prabhakar06447/micropendousx/Pictures/MicropendousX-LPC183x-Prototyping-Oven-Step2.jpg

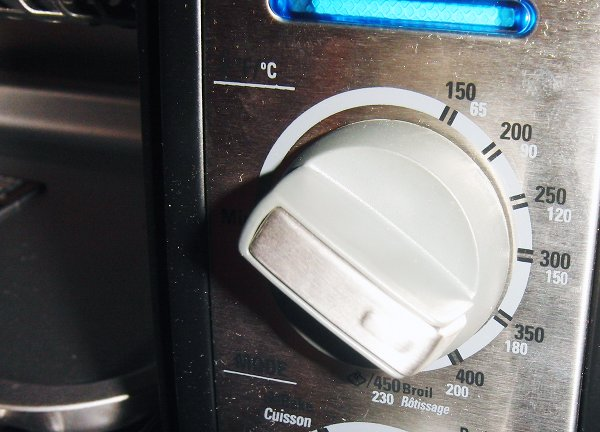
Pictures/MicropendousX-LPC183x-Prototyping-Oven-Step2.jpg
