prabhakar06447/micropendousx/Pictures/MicropendousX-LPC183x-Prototype-Testing-WindowsLibUSB.jpg

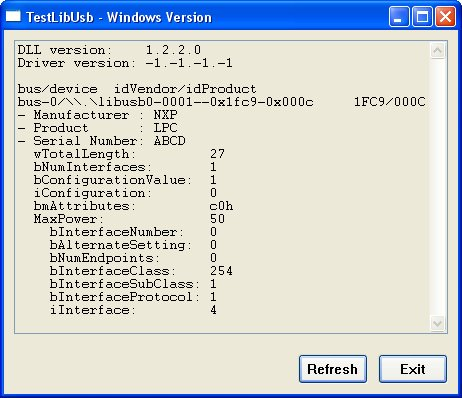
Pictures/MicropendousX-LPC183x-Prototype-Testing-WindowsLibUSB.jpg
