prabhakar06447/micropendousx/MicropendousX/Hardware/MicropendousX-176x/MicropendousX-176x_Actionshot-2-Bottom-Large.jpg

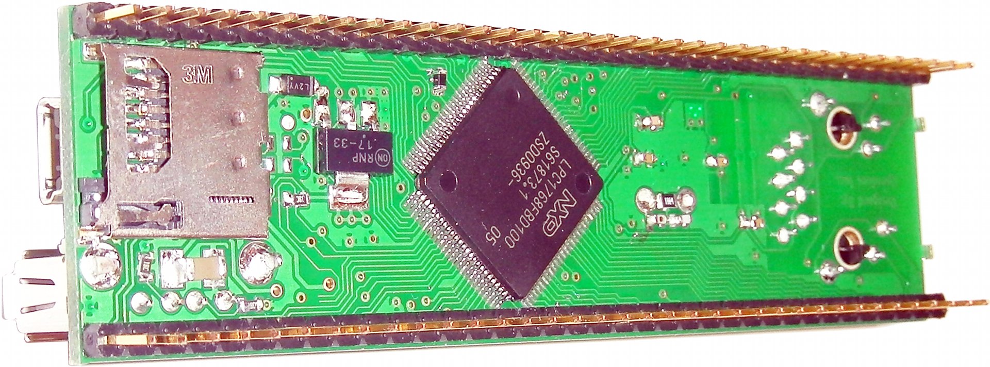
MicropendousX/Hardware/MicropendousX-176x/MicropendousX-176x_Actionshot-2-Bottom-Large.jpg
