prabhakar06447/micropendousx/MicropendousX/Hardware/MicropendousX-176x/MicropendousX-176x_JTAG_Connected-1.jpg

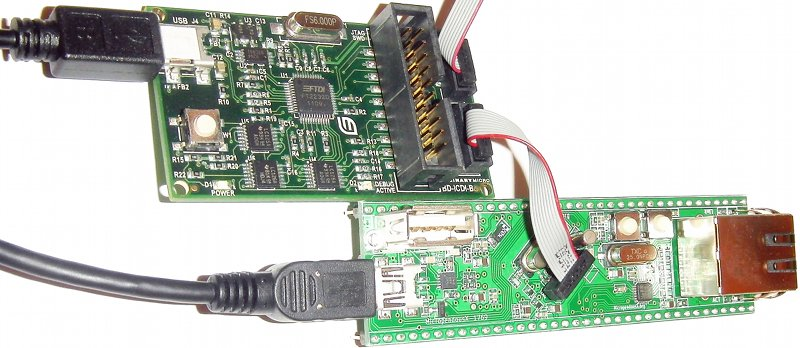
MicropendousX/Hardware/MicropendousX-176x/MicropendousX-176x_JTAG_Connected-1.jpg
