prabhakar06447/micropendousx/MicropendousX/Hardware/MicropendousX-176x/MicropendousX-176x_JTAG_Connected-2.jpg

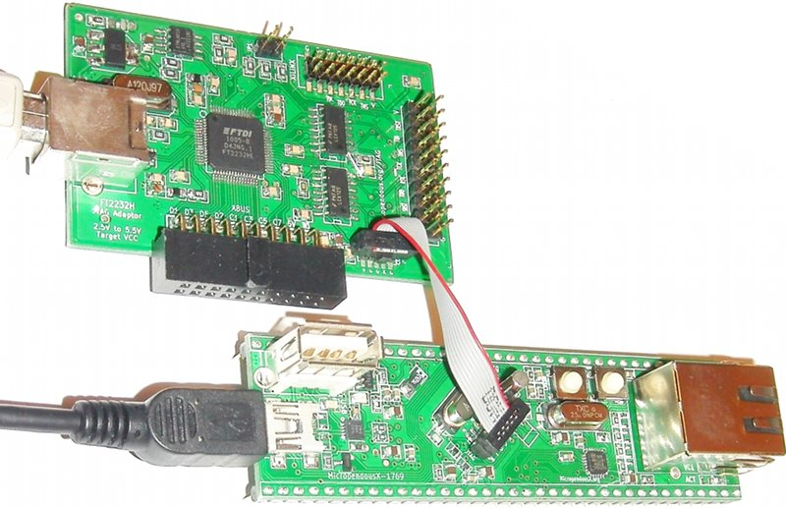
MicropendousX/Hardware/MicropendousX-176x/MicropendousX-176x_JTAG_Connected-2.jpg
