prabhakar06447/micropendousx/MicropendousX/Hardware/MicropendousX-176x/MicropendousX-176x_Top-Large.jpg

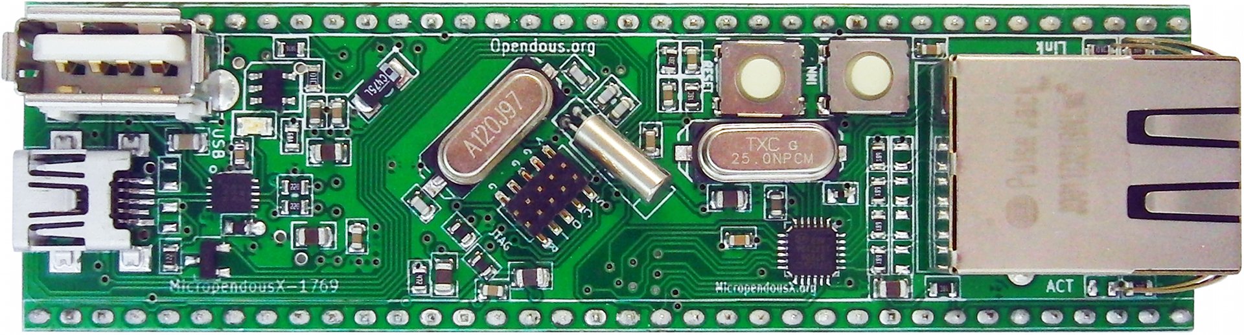
MicropendousX/Hardware/MicropendousX-176x/MicropendousX-176x_Top-Large.jpg
