prabhakar06447/micropendousx/MicropendousX/Hardware/MicropendousX-1343/MicropendousX-1343-Small.jpg

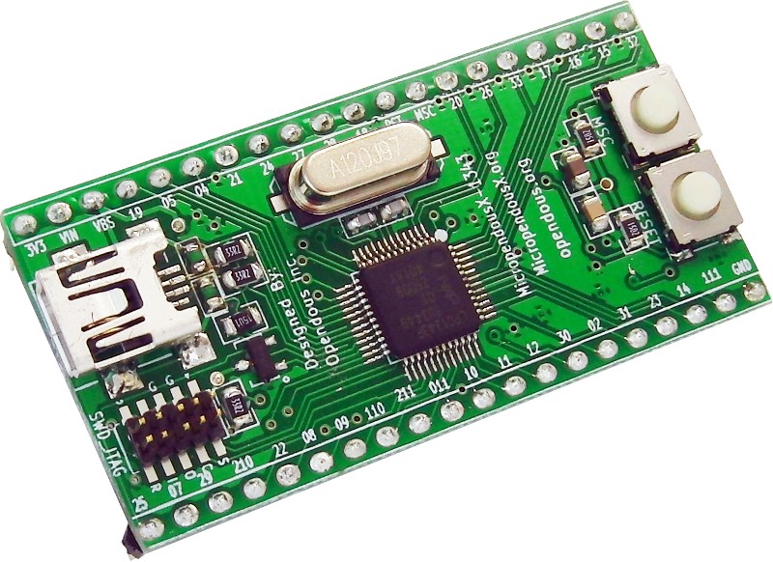
MicropendousX/Hardware/MicropendousX-1343/MicropendousX-1343-Small.jpg
