prabhakar06447/micropendousx/MicropendousX/Hardware/MicropendousX-1758/MicropendousX-1758-Bottom.jpg

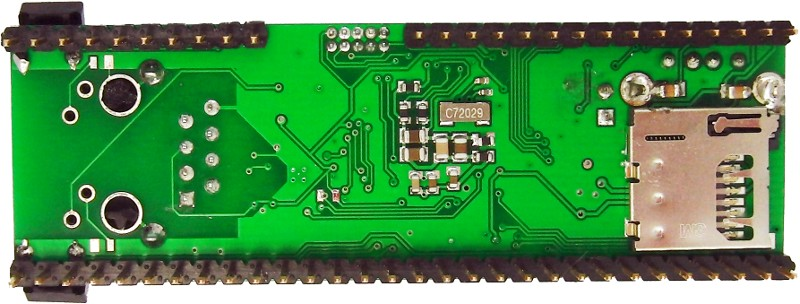
MicropendousX/Hardware/MicropendousX-1758/MicropendousX-1758-Bottom.jpg
