prabhakar06447/micropendousx/MicropendousX/Hardware/MicropendousX-1758/MicropendousX-1758-Top.jpg

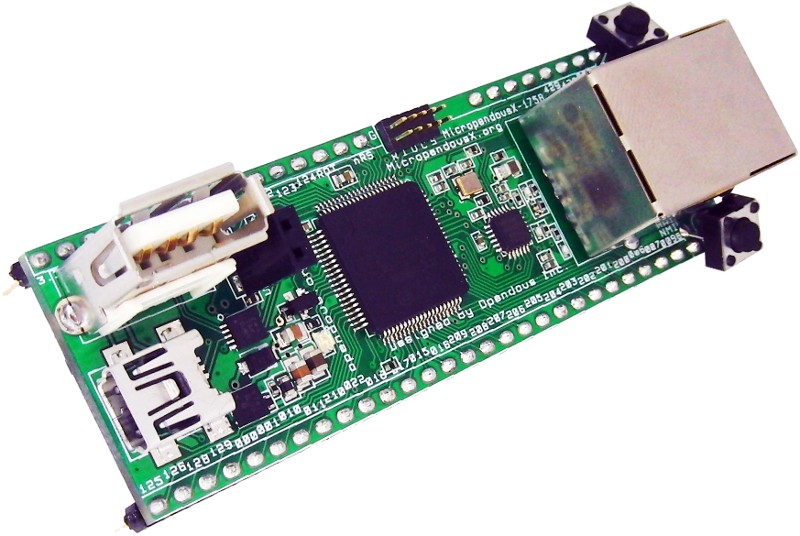
MicropendousX/Hardware/MicropendousX-1758/MicropendousX-1758-Top.jpg
