prabhakar06447/micropendousx/MicropendousX/Hardware/MicropendousX-GPS/MicropendousX-LPC182x-GPS-Layout.jpg

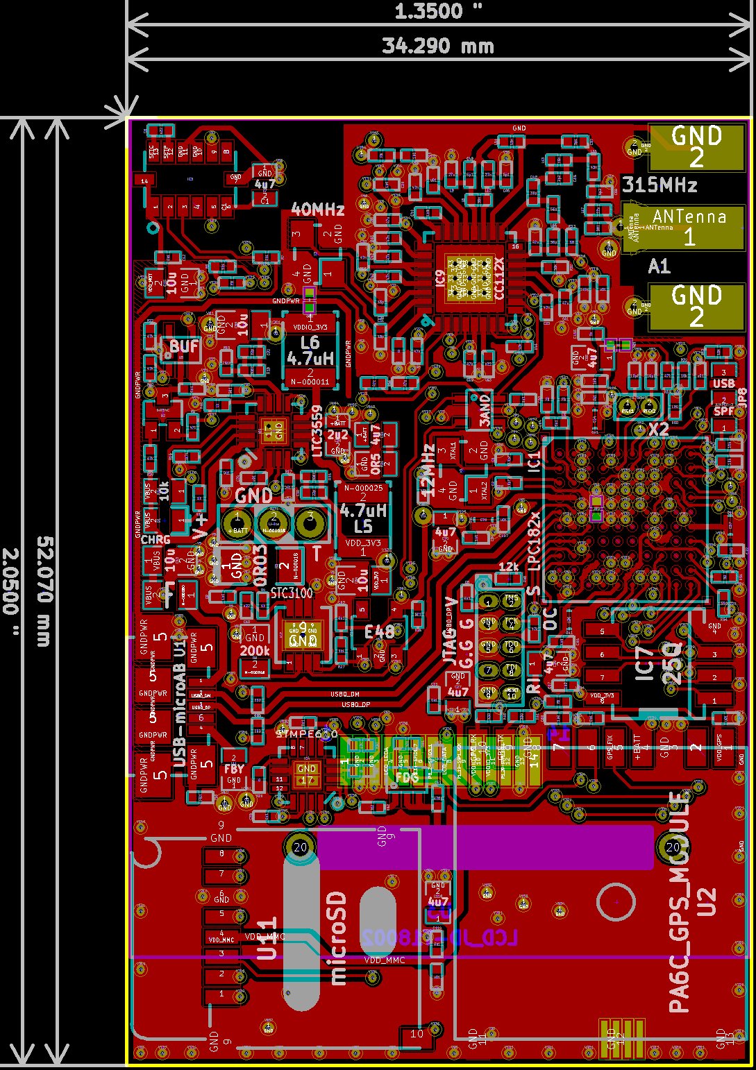
MicropendousX/Hardware/MicropendousX-GPS/MicropendousX-LPC182x-GPS-Layout.jpg
