prabhakar06447/micropendousx/MicropendousX/Hardware/MicropendousX-LPC183x/MicropendousX-LPC183x_Layout.jpg

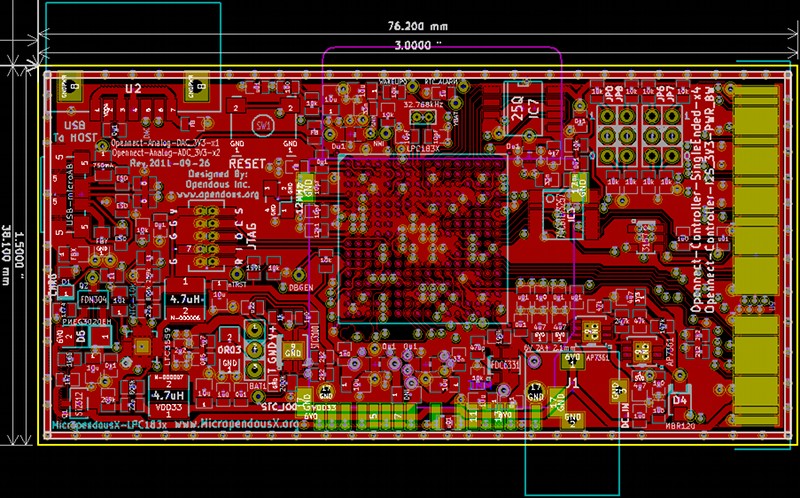
MicropendousX/Hardware/MicropendousX-LPC183x/MicropendousX-LPC183x_Layout.jpg
