prabhakar06447/micropendousx/Pictures/MicropendousX-1343-Picture1.jpg

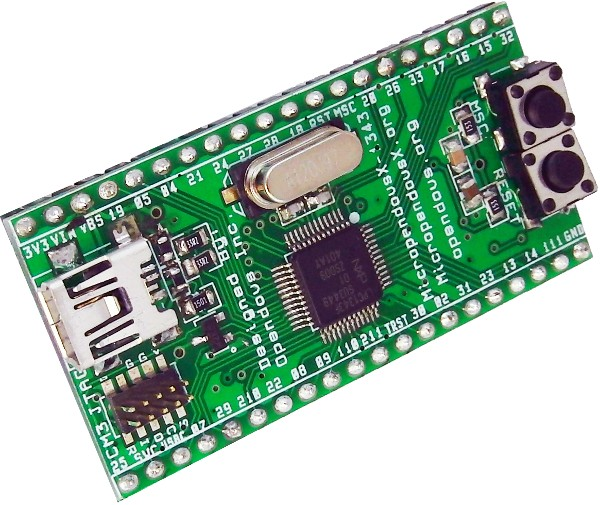
Pictures/MicropendousX-1343-Picture1.jpg
