prabhakar06447/micropendousx/Pictures/MicropendousX-1758-JTAG_Adapter_Connected-1.jpg

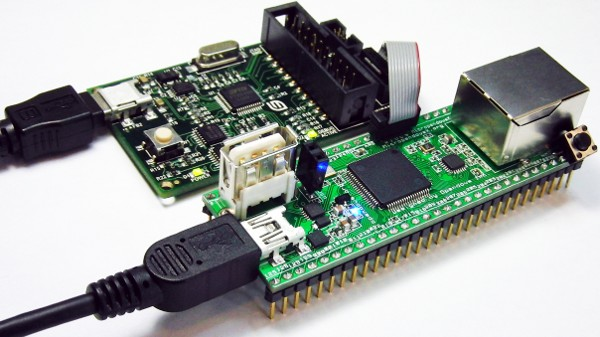
Pictures/MicropendousX-1758-JTAG_Adapter_Connected-1.jpg
