prabhakar06447/micropendousx/Pictures/MicropendousX-1758-Picture2.jpg

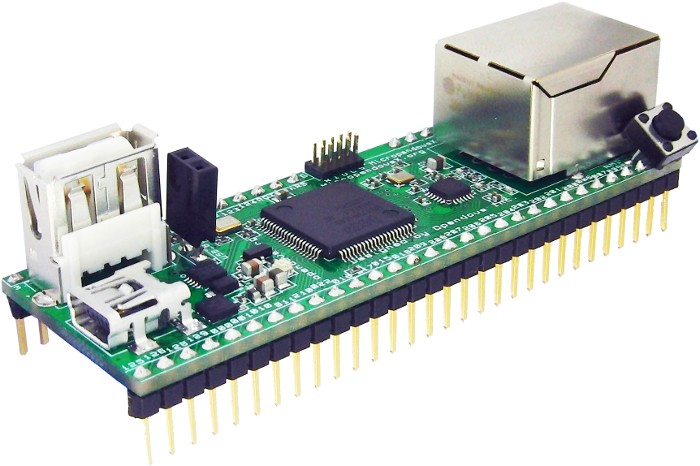
Pictures/MicropendousX-1758-Picture2.jpg
