prabhakar06447/micropendousx/Pictures/MicropendousX-1758-Picture3.jpg

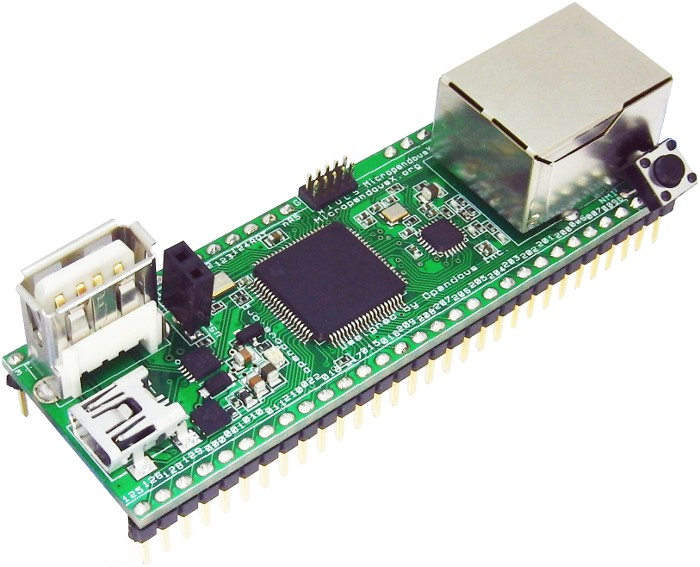
Pictures/MicropendousX-1758-Picture3.jpg
