prabhakar06447/micropendousx/Pictures/MicropendousX-LPC183x-Prototype-JumperSettingsUSB0.jpg

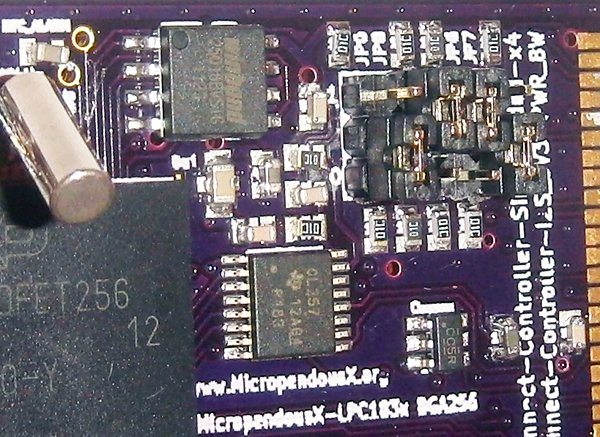
Pictures/MicropendousX-LPC183x-Prototype-JumperSettingsUSB0.jpg
