prabhakar06447/micropendousx/Pictures/MicropendousX-LPC183x-Prototyping-ExaminingPlacement.jpg

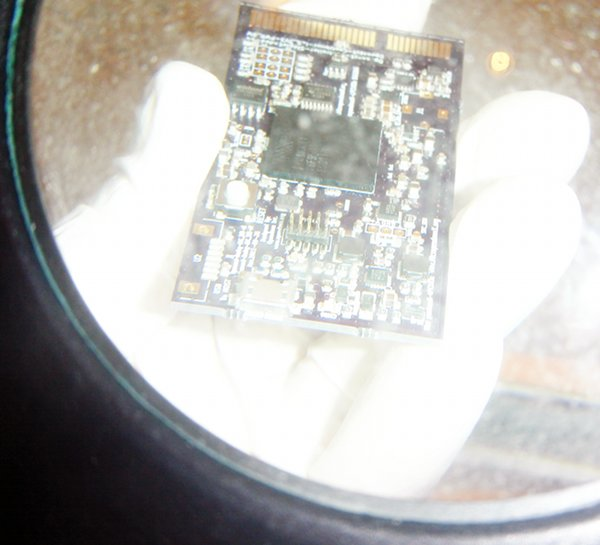
Pictures/MicropendousX-LPC183x-Prototyping-ExaminingPlacement.jpg
