prabhakar06447/micropendousx/Pictures/MicropendousX-LPC183x-Prototyping-OvenTray.jpg

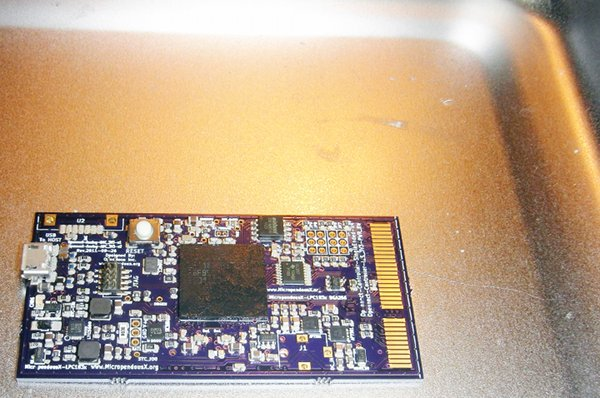
Pictures/MicropendousX-LPC183x-Prototyping-OvenTray.jpg
