prabhakar06447/micropendousx/Pictures/MicropendousX-LPC183x-Prototyping-PreparingBGA.jpg

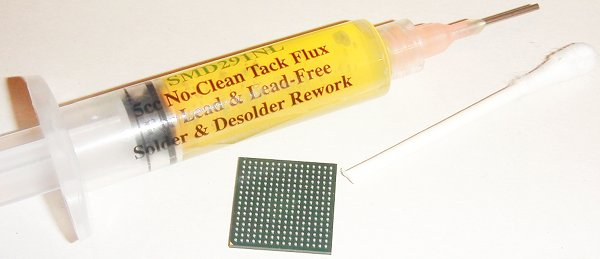
Pictures/MicropendousX-LPC183x-Prototyping-PreparingBGA.jpg
