prabhakar06447/micropendousx/Pictures/MicropendousX-LPC183x-Prototyping-StencilPositioning.jpg

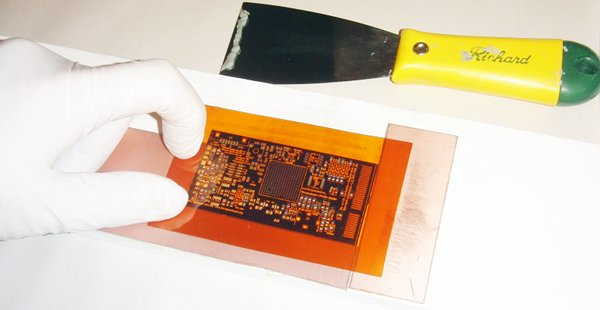
Pictures/MicropendousX-LPC183x-Prototyping-StencilPositioning.jpg
