prabhakar06447/micropendousx/MicropendousX/Hardware/MicropendousX-1343/MicropendousX-1343-BillOfMaterials.txt

QTY, Manufacturer Part#     , Cost($USD each) - References - Description

1  , LPC1343FBD48           , 6.30 - IC1 - IC MCU 32BIT 32KB FLASH 48LQFP
2  , CC0603JRNP09BN180      , 0.05 - C1 C2 - CAP CERAMIC 18PF 50V NP0 0603
1  , 08055C103KAT2A         , 0.03 - C7 - CAP CERM .01UF 10% 50V X7R 0805
2  , GRM21BR71E104KA01L     , 0.04 - C5 C6 - CAP CER .1UF 25V 10% X7R 0805
3  , LMK212BJ106KG-T        , 0.28 - C3 C4 C8 - CAP CER 10uF 10V X5R 0805
2  , CG0603MLC-05LE         , 0.23 - CR1 CR2 - SUPPRESSOR ESD 5VDC 0603 SMD MLC
1  , MBR120VLSFT1G          , 0.53 - D1 - DIODE SCHOTTKY 20V 1A SOD123FL
1  , BSS84LT1G              , 0.51 - Q1 - MOSFET P-CH 50V 130MA SOT-23 Logic Level Gate
2  , RMCF1/1033.2FRCT-ND    , 0.04 - R1 R2 - RES 33.2 OHM 1/8W 1% 0805 SMD
1  , RC0805FR-071K5L        , 0.07 - R3 - RES 1.50K OHM 1/8W 1% 0805 SMD
2  , RMCF1/1015KJRCT-ND     , 0.03 - R4 R5 - RES 15K OHM 1/8W 5% 0805 SMD
1  , RMCF1/100RCT-ND        , 0.03 - R7 - RES 0 OHM 1/8W 5% 0805 SMD
2  , EVQ-Q2U03W             , 0.39 - SW1 SW2 - SWITCH LT 6MM 260GF H=3.1MM SMD
1  , 101-00303-68           , 0.86 - U3 - CONN MINI MICRO-SD 8PIN PCB GOLD
1  , 690-004-221-023        , 0.93 - U2 - CONN USB JACK TYPE B HORIZON R/A
1  , GRPB052VWVN-RC         , 1.11 - U3 - Cortex CONN HEADER .050" 10PS DL PCB AU
1  , ZLDO1117G33TA          , 0.62 - U4 - IC REG LDO 1A 3.3V SOT223            
1  , ABLS-12.000MHZ-B4-T    , 0.46 - X1 - CRYSTAL 12.000 MHZ 18PF HC49US 30ppm
2  , 68001-220HLF           , 1.00 - P1 P2 - CONN HEADER 20POS .100 STR 15AU
-----------------------Total:15.86

Notes:	- Component costs listed are for single quantity orders from DigiKey
	- The outer male headers P1, P2 can be replaced with PPPC201LFBN-RC female headers
	- R3, the 1.5k USB D+ pull-up, and USB series resistors R1, R2 must be 1% or better
	- LPC1343FBD48 can be replaced with non-USB LPC1313FBD48 (Cortex-M3) or
	  LPC1114FBD48 (Cortex-M0) ICs.  USB will then only provide power.
	  DO NOT populate D1 when using non-USB ICs
	- MBR120VLSFT1G Schottky Diode can be replaced by MBRX120 in SOD123
	- R6 is a copper trace connecting GND and GNDPWR. Its pins should be shorted.
	- R7 need only be installed if you require SWD trace capability
