prabhakar06447/micropendousx/Pictures/MicropendousX-LPC183x-Prototyping-Materials.jpg

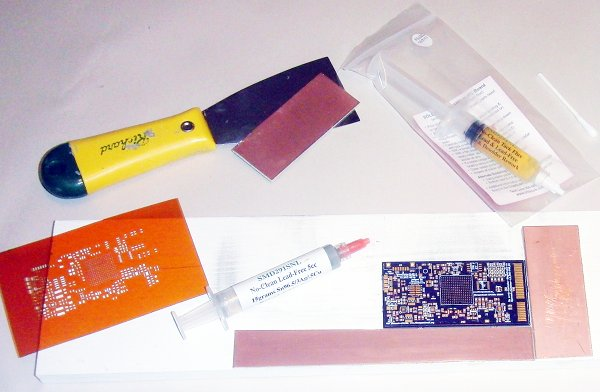
Pictures/MicropendousX-LPC183x-Prototyping-Materials.jpg
