prabhakar06447/micropendousx/MicropendousX/Hardware/MicropendousX-176x/MicropendousX-176x_Assembly.jpg

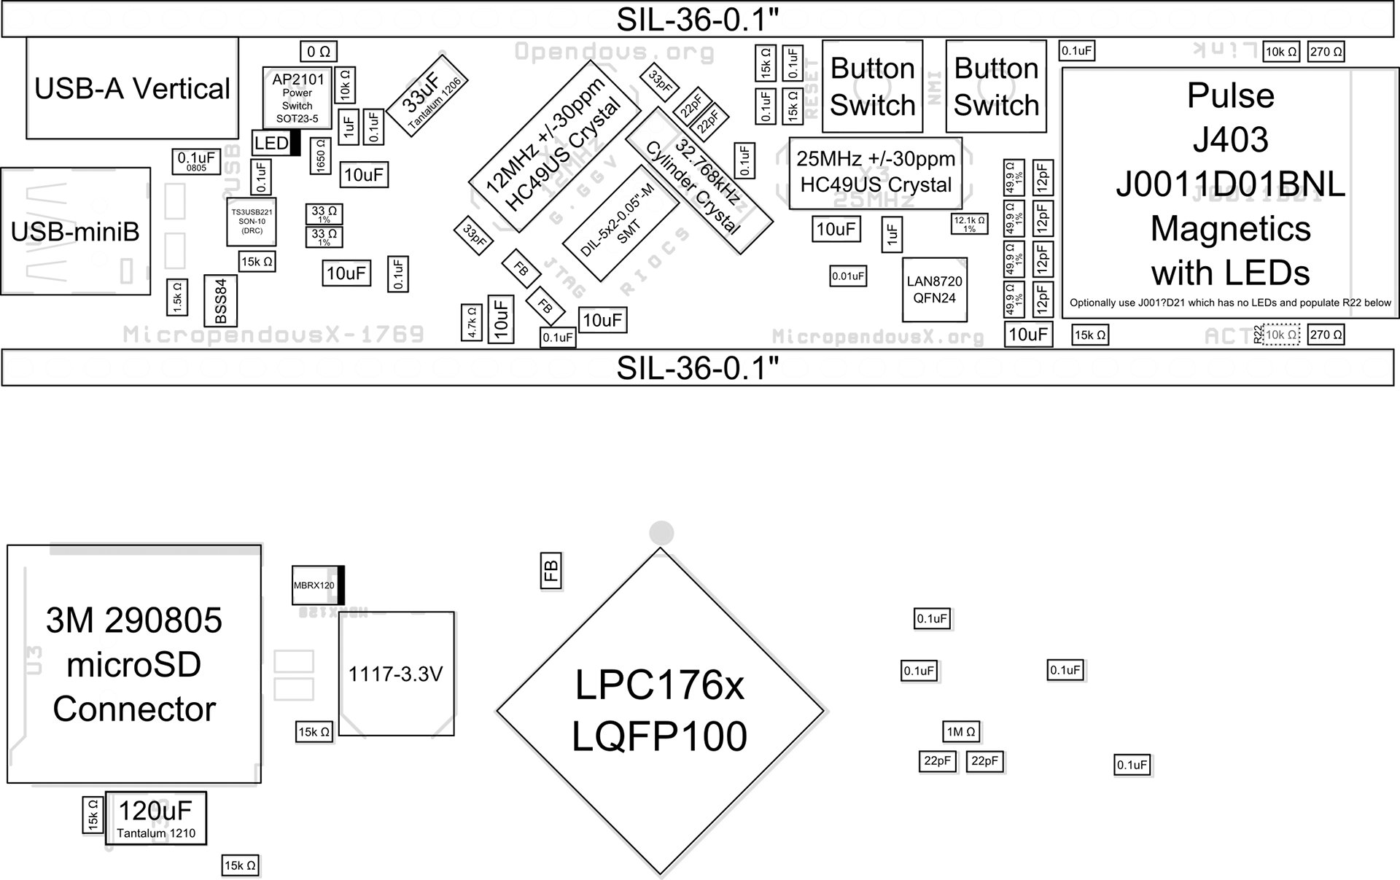
MicropendousX/Hardware/MicropendousX-176x/MicropendousX-176x_Assembly.jpg
