prabhakar06447/micropendousx/MicropendousX/Hardware/MicropendousX-1343/MicropendousX-1343_Assembly.jpg

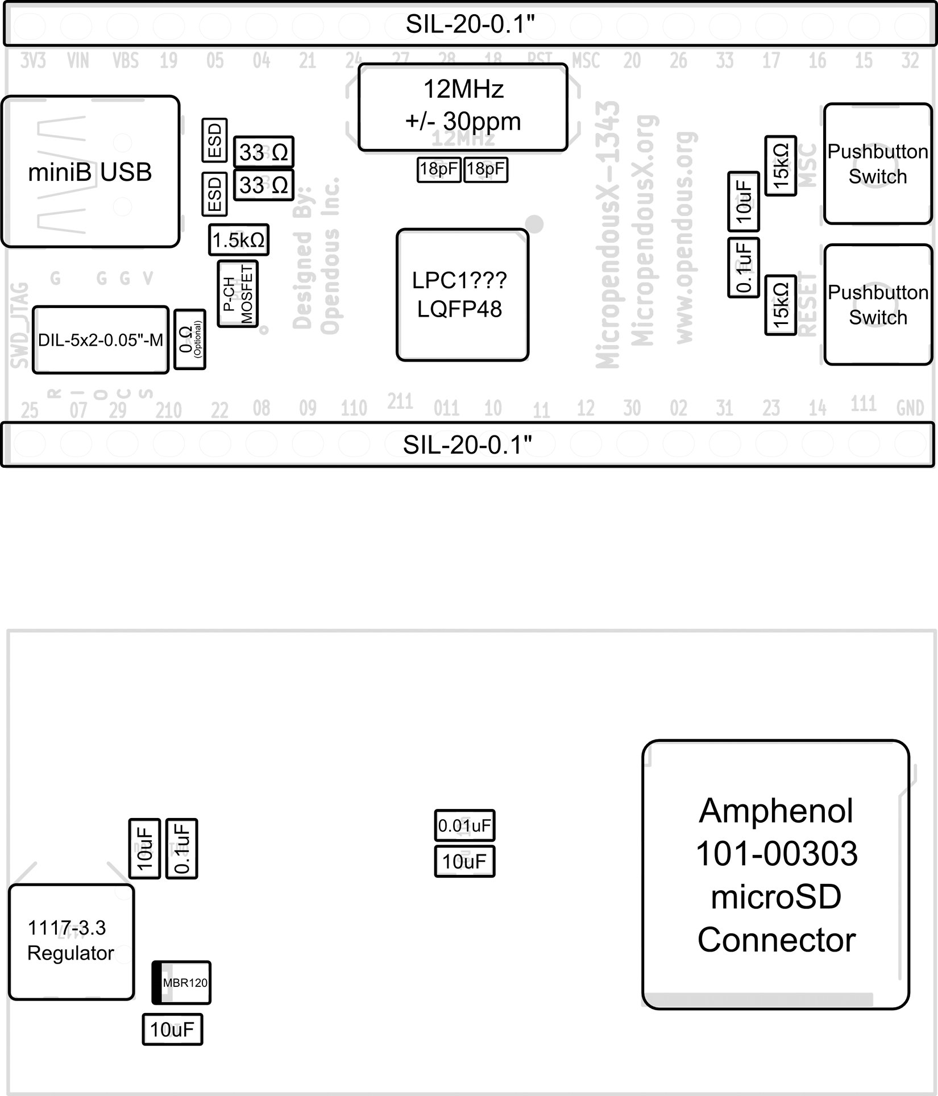
MicropendousX/Hardware/MicropendousX-1343/MicropendousX-1343_Assembly.jpg
