prabhakar06447/micropendousx/MicropendousX/Hardware/MicropendousX-LPC183x/MicropendousX-LPC183x-Assembly.jpg

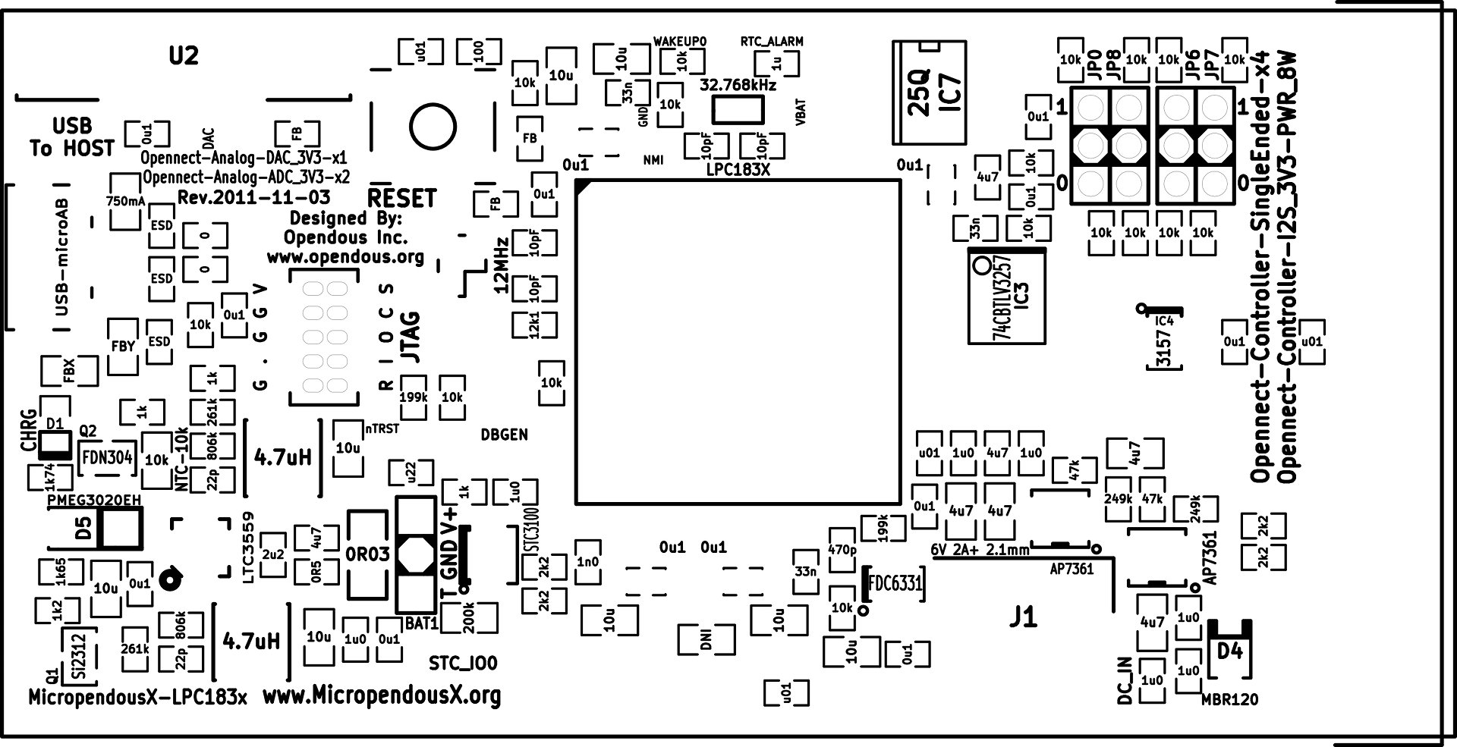
MicropendousX/Hardware/MicropendousX-LPC183x/MicropendousX-LPC183x-Assembly.jpg
