prabhakar06447/micropendousx/Pictures/MicropendousX-LPC183x-Prototyping-Oven-Step1.jpg

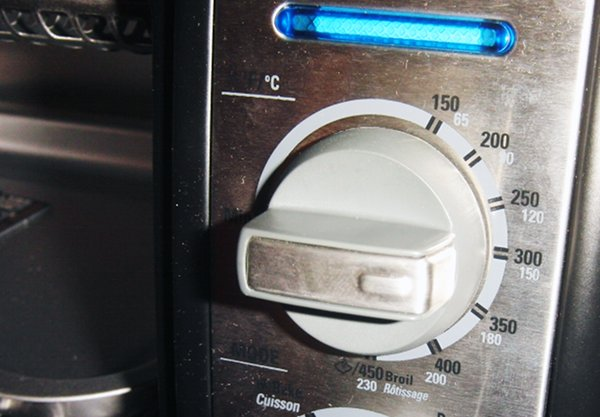
Pictures/MicropendousX-LPC183x-Prototyping-Oven-Step1.jpg
