prabhakar06447/micropendousx/Pictures/MicropendousX-LPC183x-Prototyping-Oven-Step3.jpg

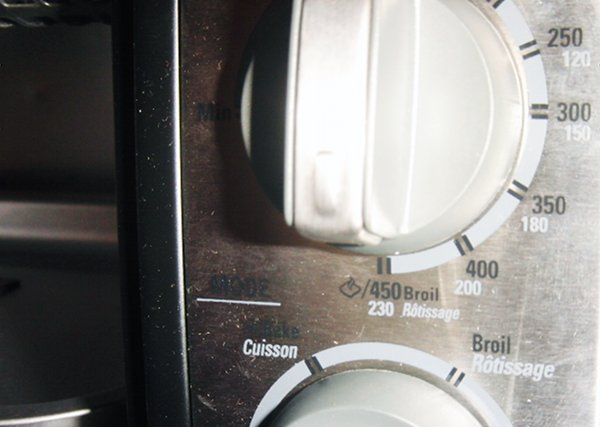
Pictures/MicropendousX-LPC183x-Prototyping-Oven-Step3.jpg
