prabhakar06447/micropendousx/Pictures/MicropendousX-LPC183x-Prototyping-SolderPasted.jpg

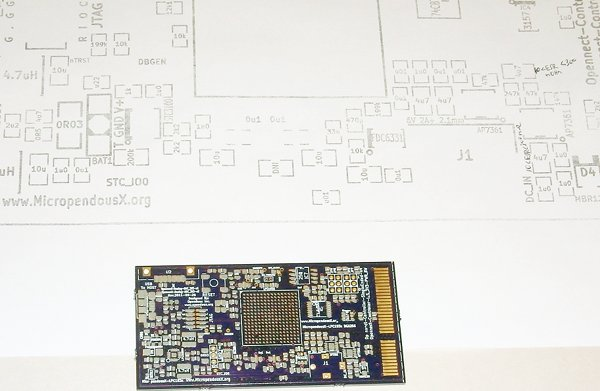
Pictures/MicropendousX-LPC183x-Prototyping-SolderPasted.jpg
