prabhakar06447/micropendousx/Pictures/MicropendousX-LPC183x-Prototype-Testing-Linux_lsusb.jpg

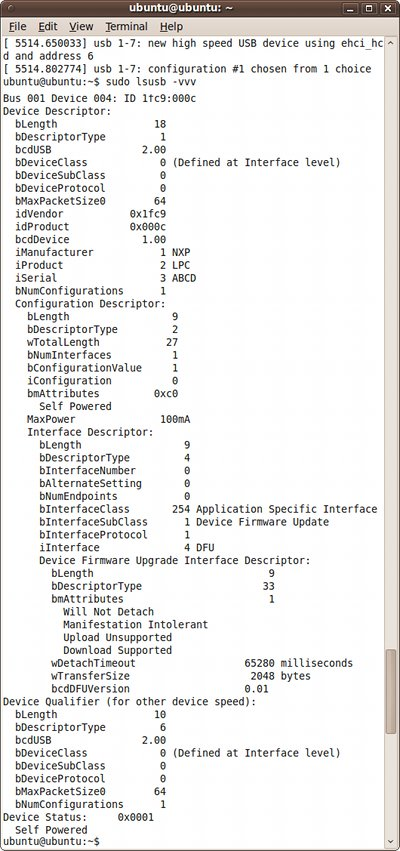
Pictures/MicropendousX-LPC183x-Prototype-Testing-Linux_lsusb.jpg
