prabhakar06447/micropendousx/Pictures/MicropendousX-LPC183x-Prototype-Testing-Small.jpg

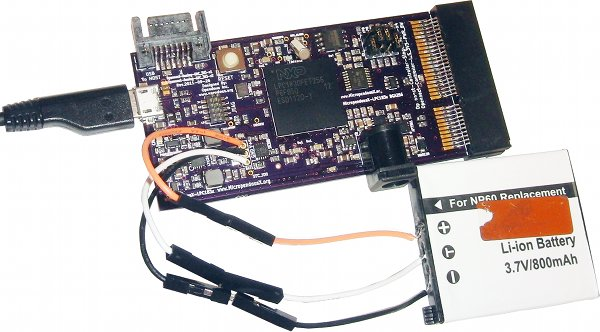
Pictures/MicropendousX-LPC183x-Prototype-Testing-Small.jpg
