prabhakar06447/micropendousx/MicropendousX/Hardware/MicropendousX-GPS/MicropendousX-LPC182x-GPS-Schematic.pdf

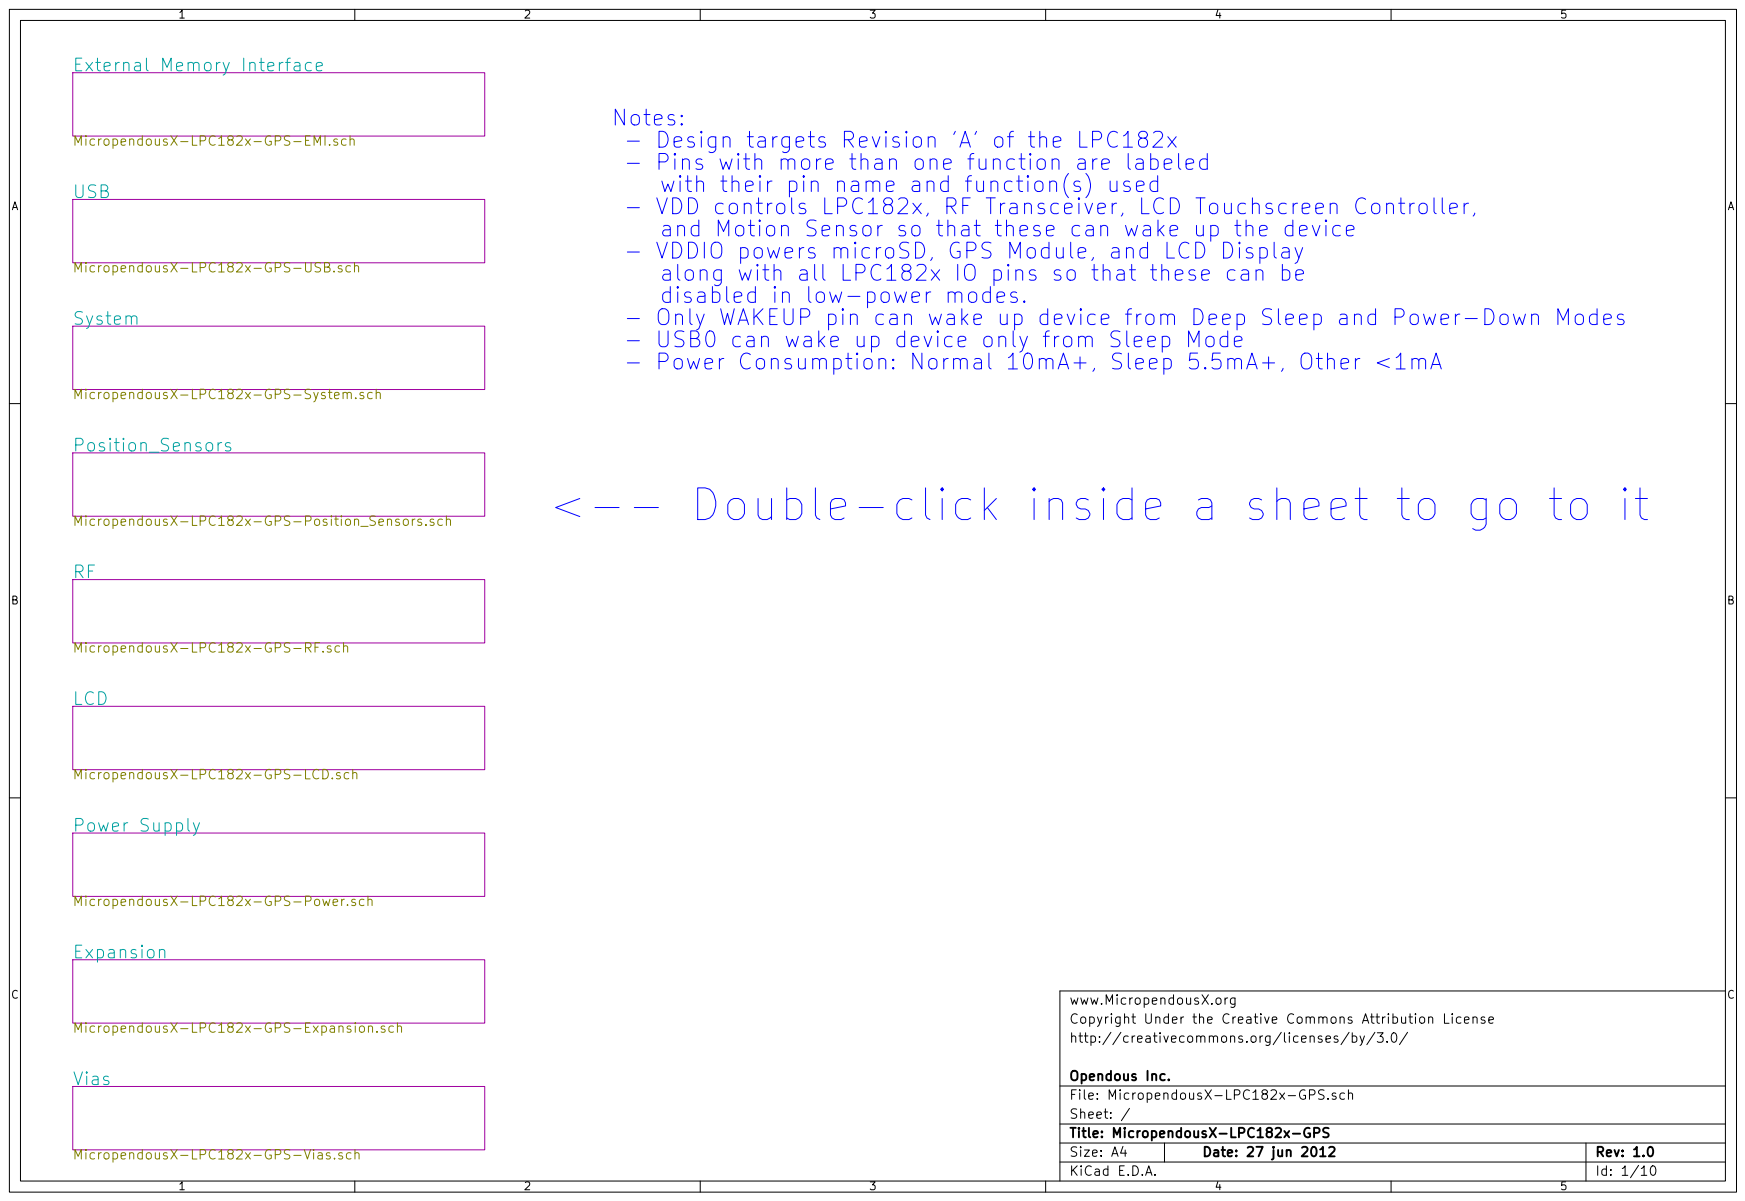
[picture p44: page 1]

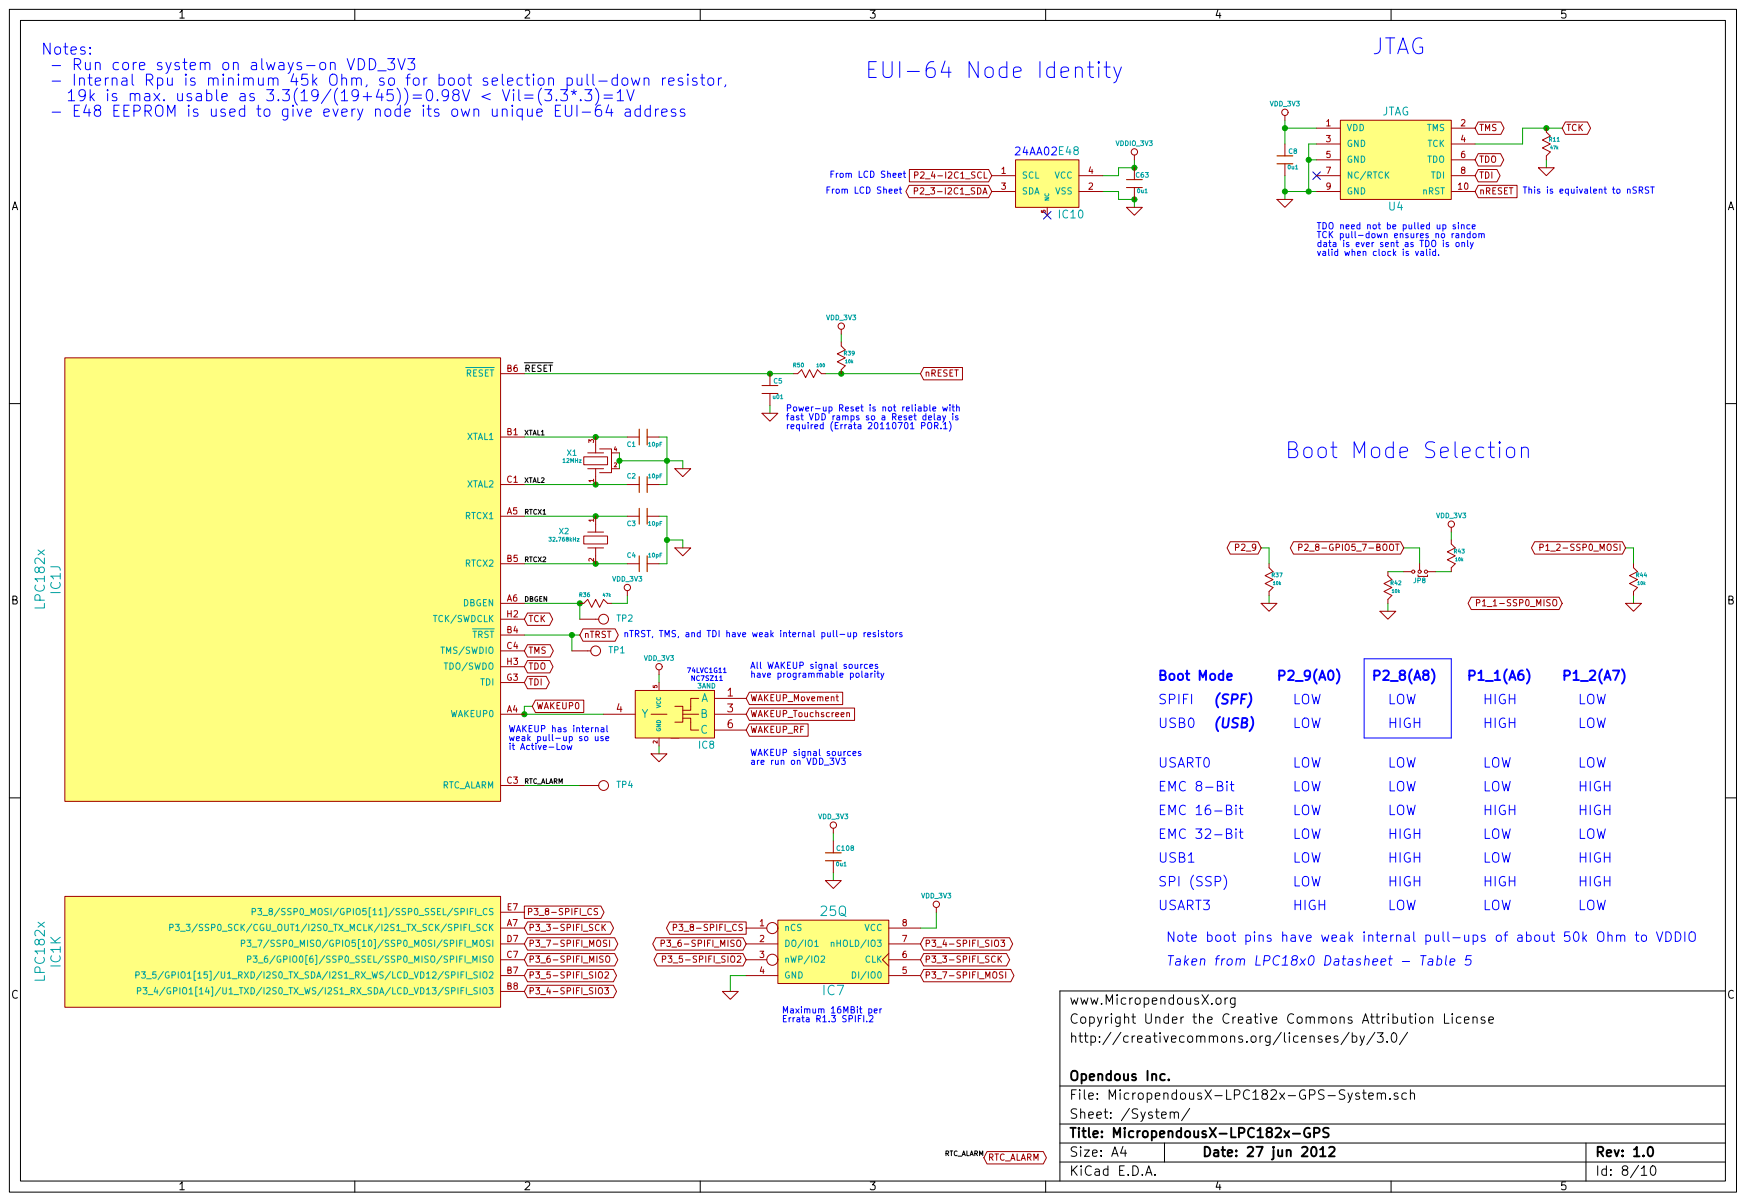
[picture p45: page 2]

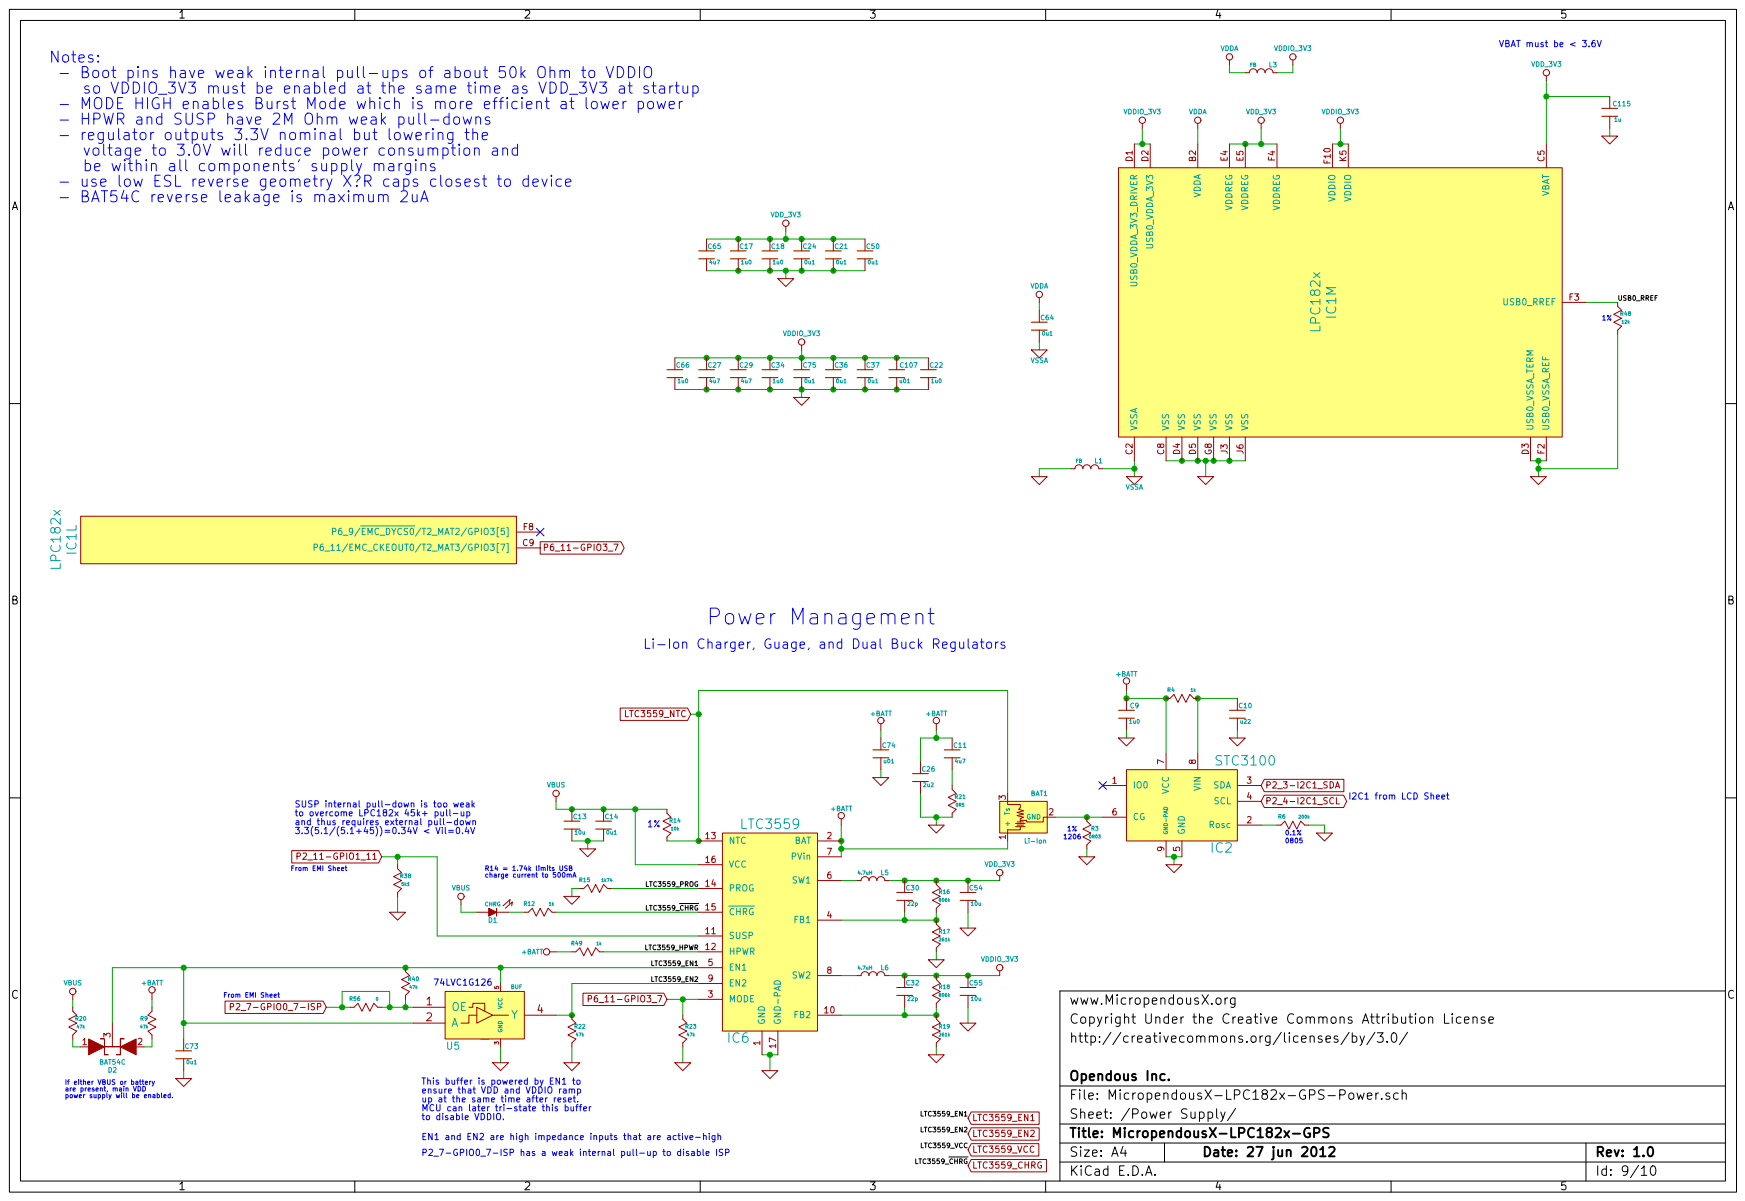
[picture p46: page 3]

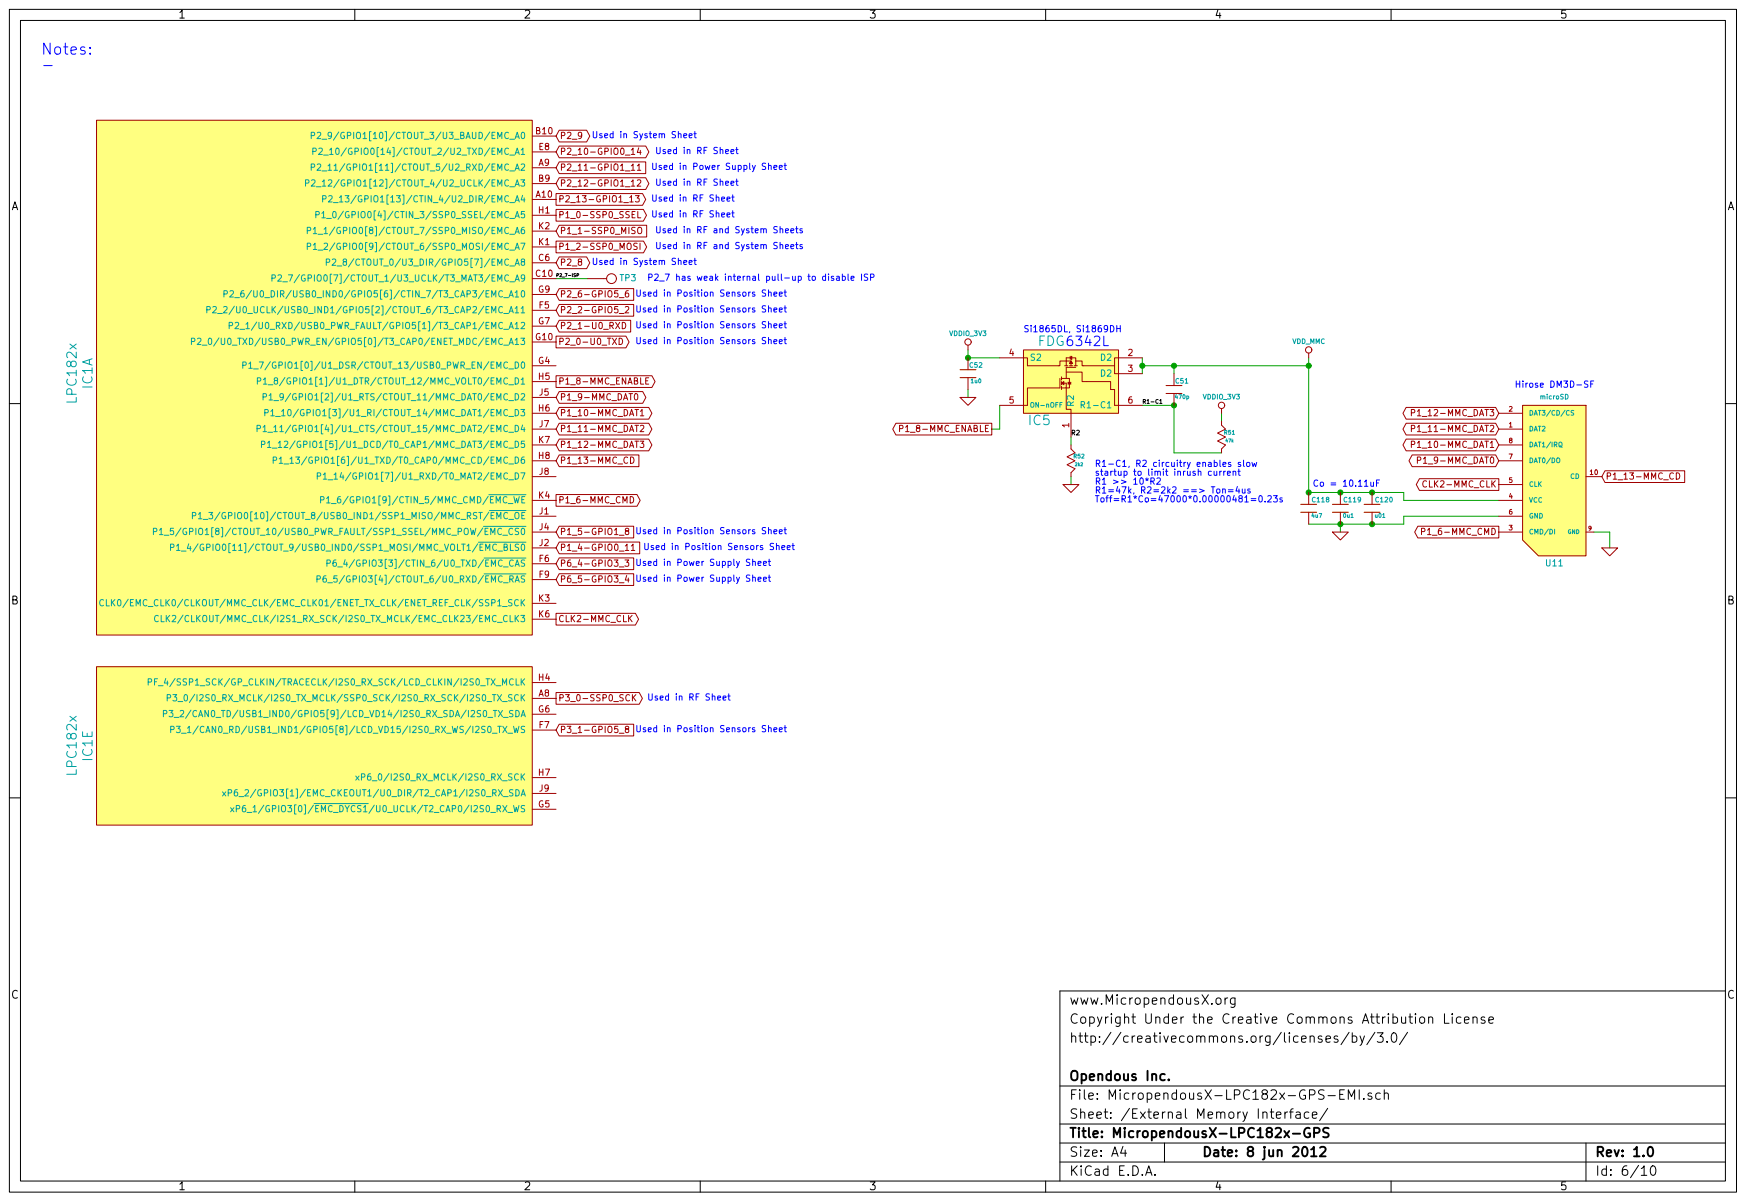
[picture p47: page 4]

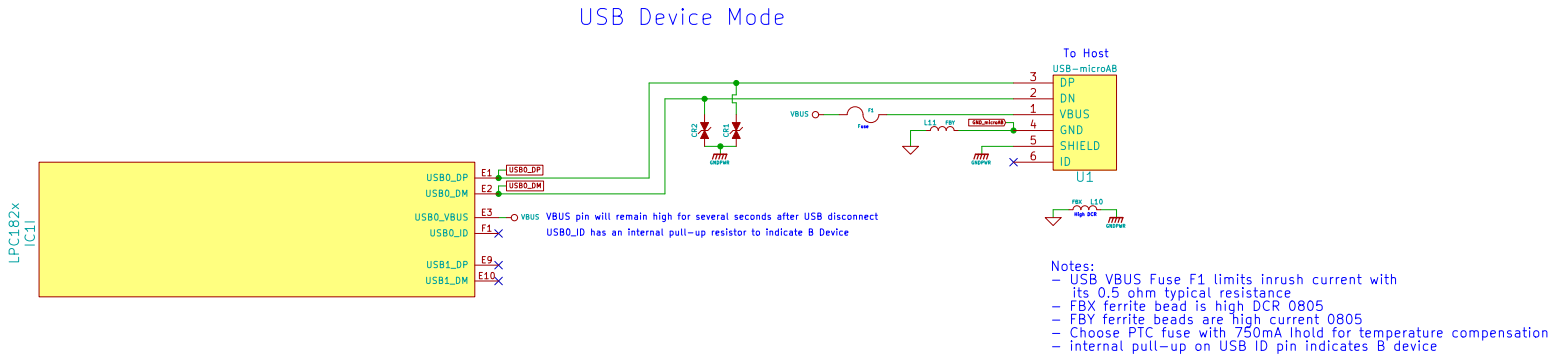
[picture p48: page 5]

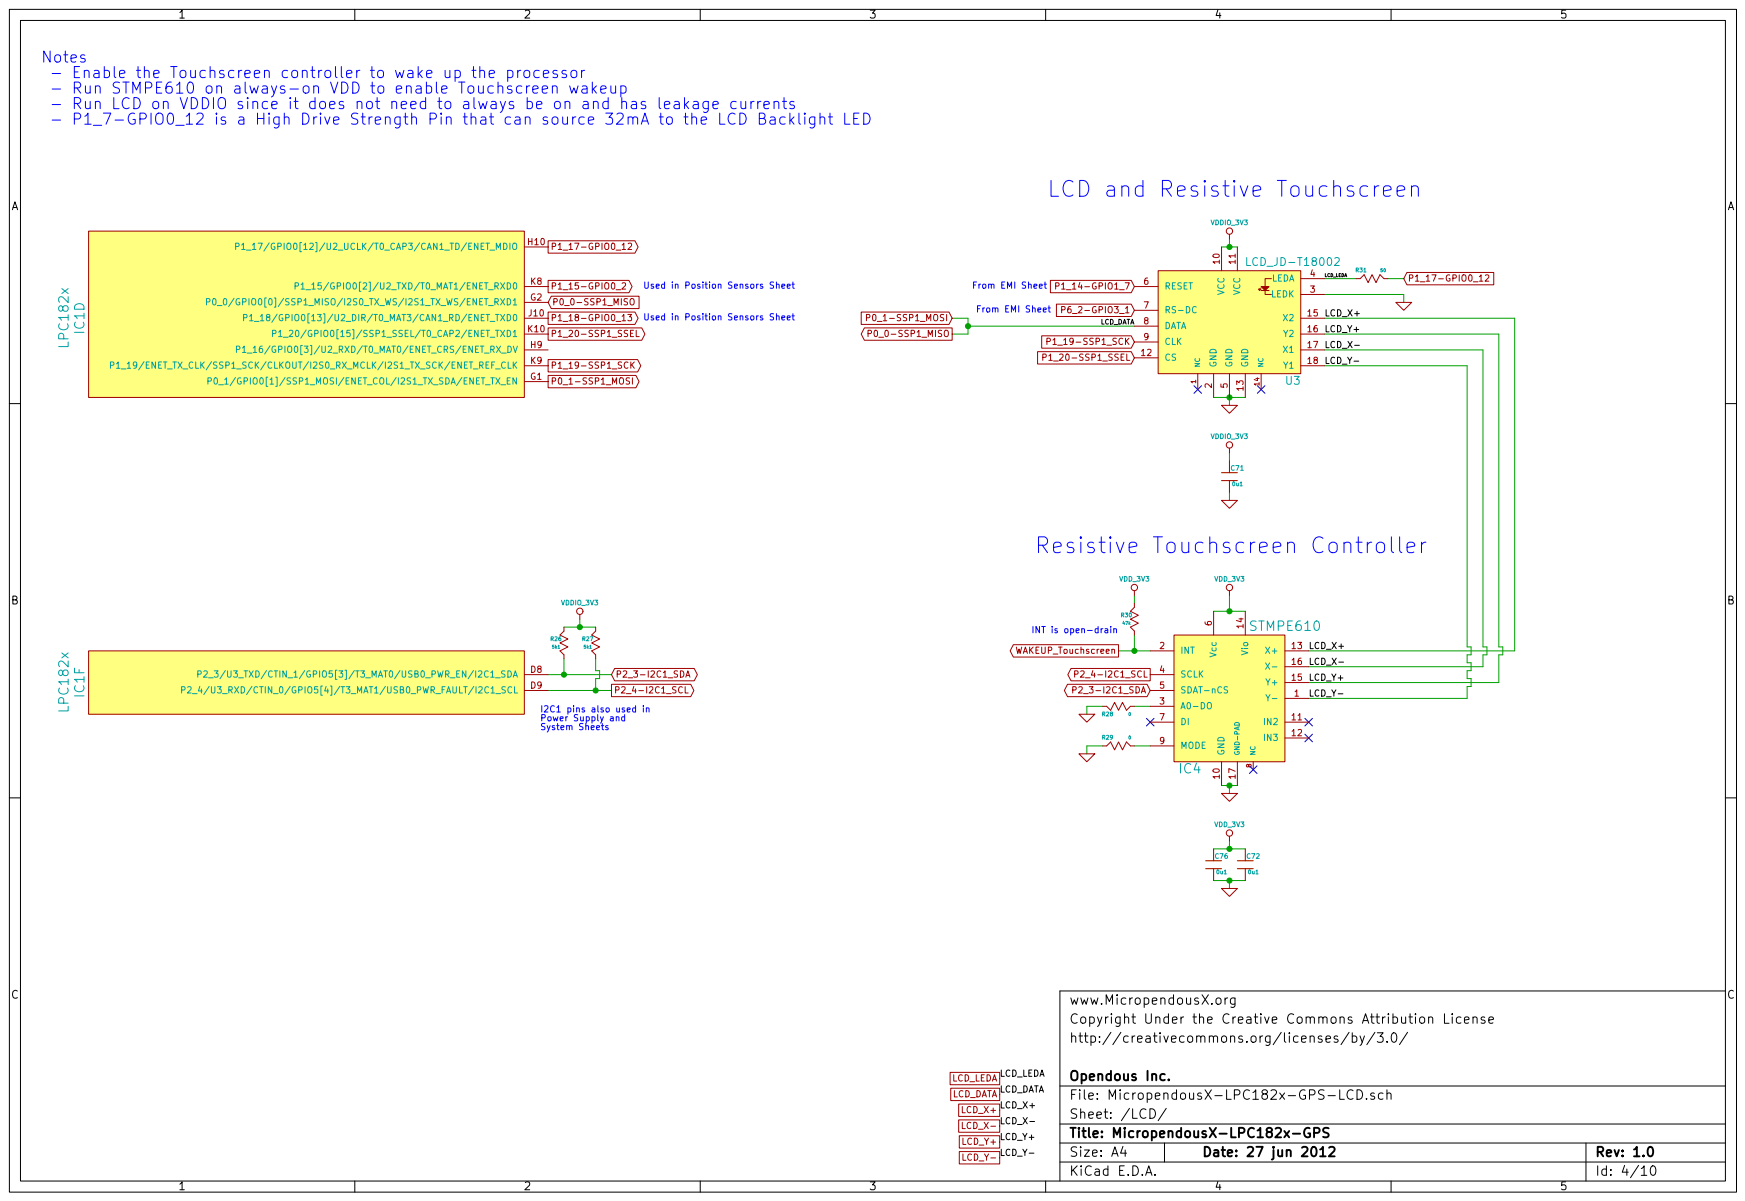
[picture p49: page 6]

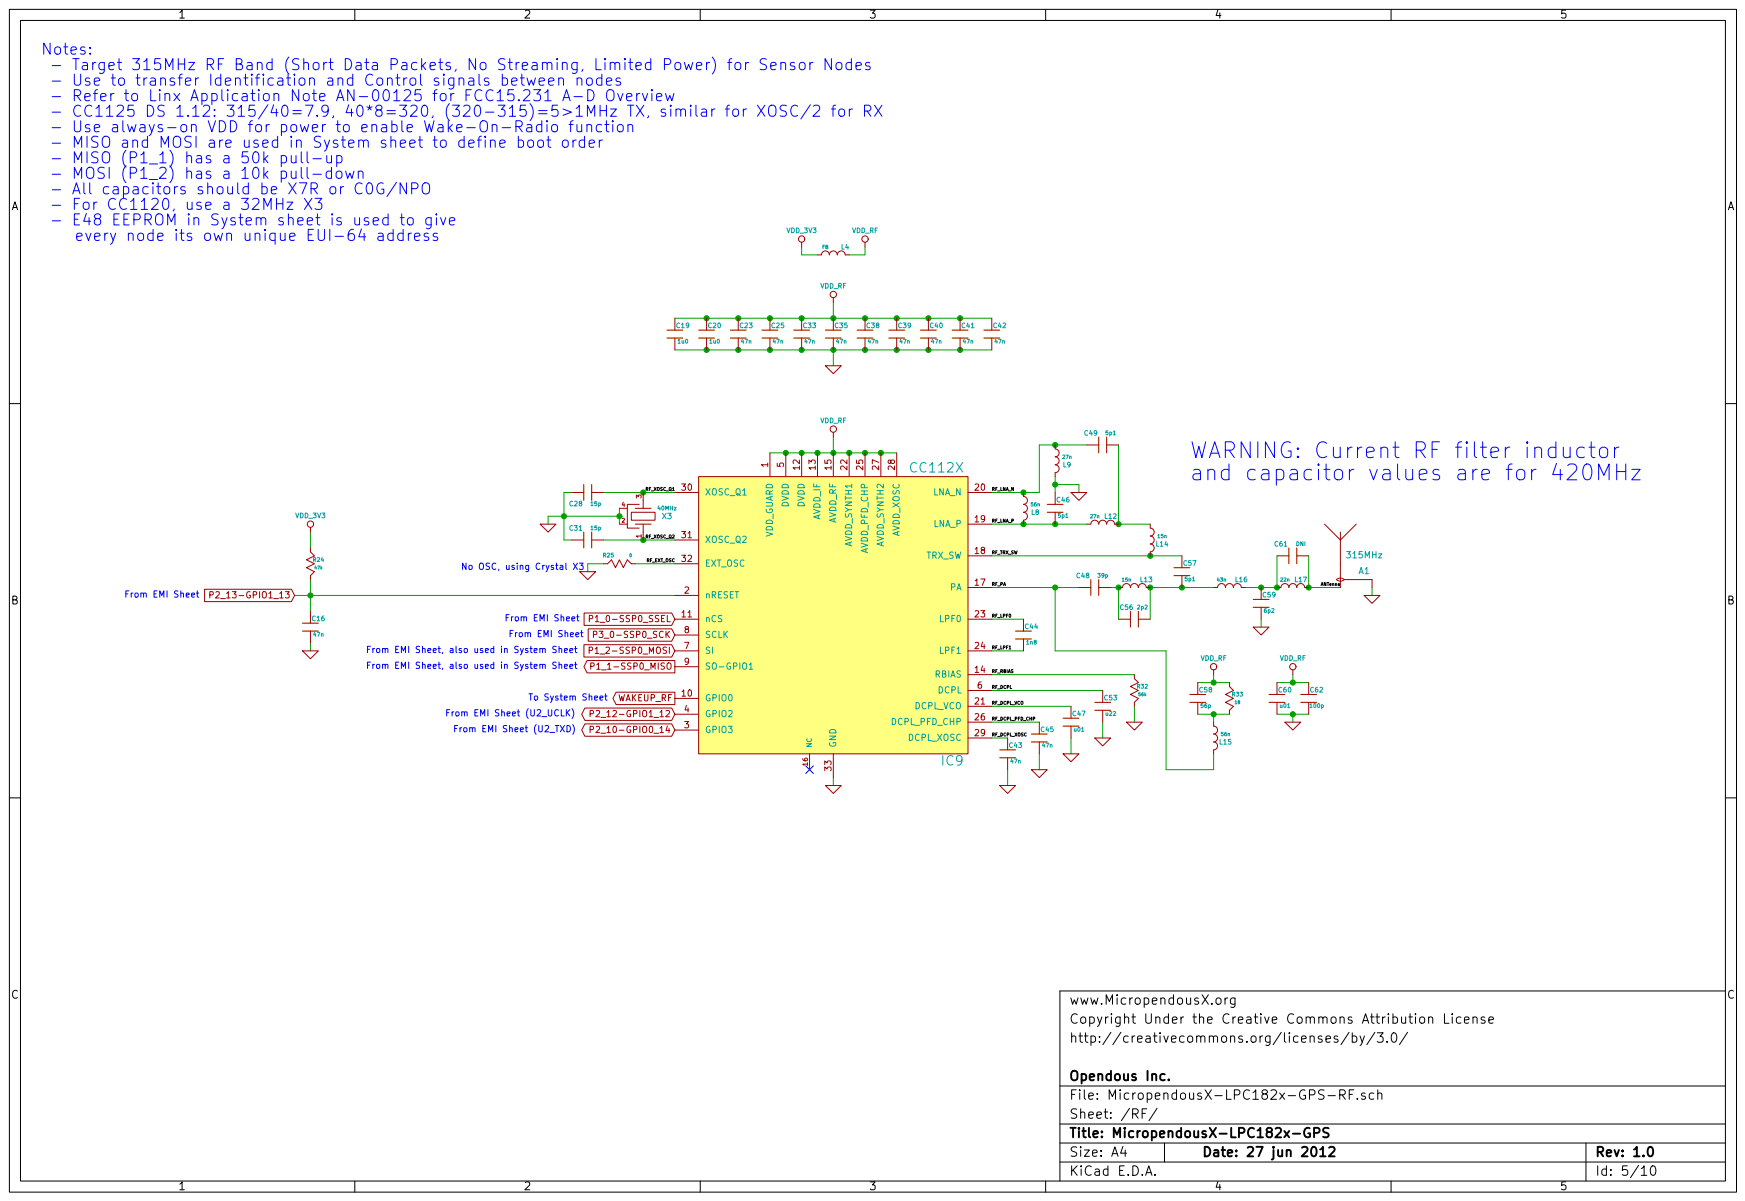
[picture p50: page 7]

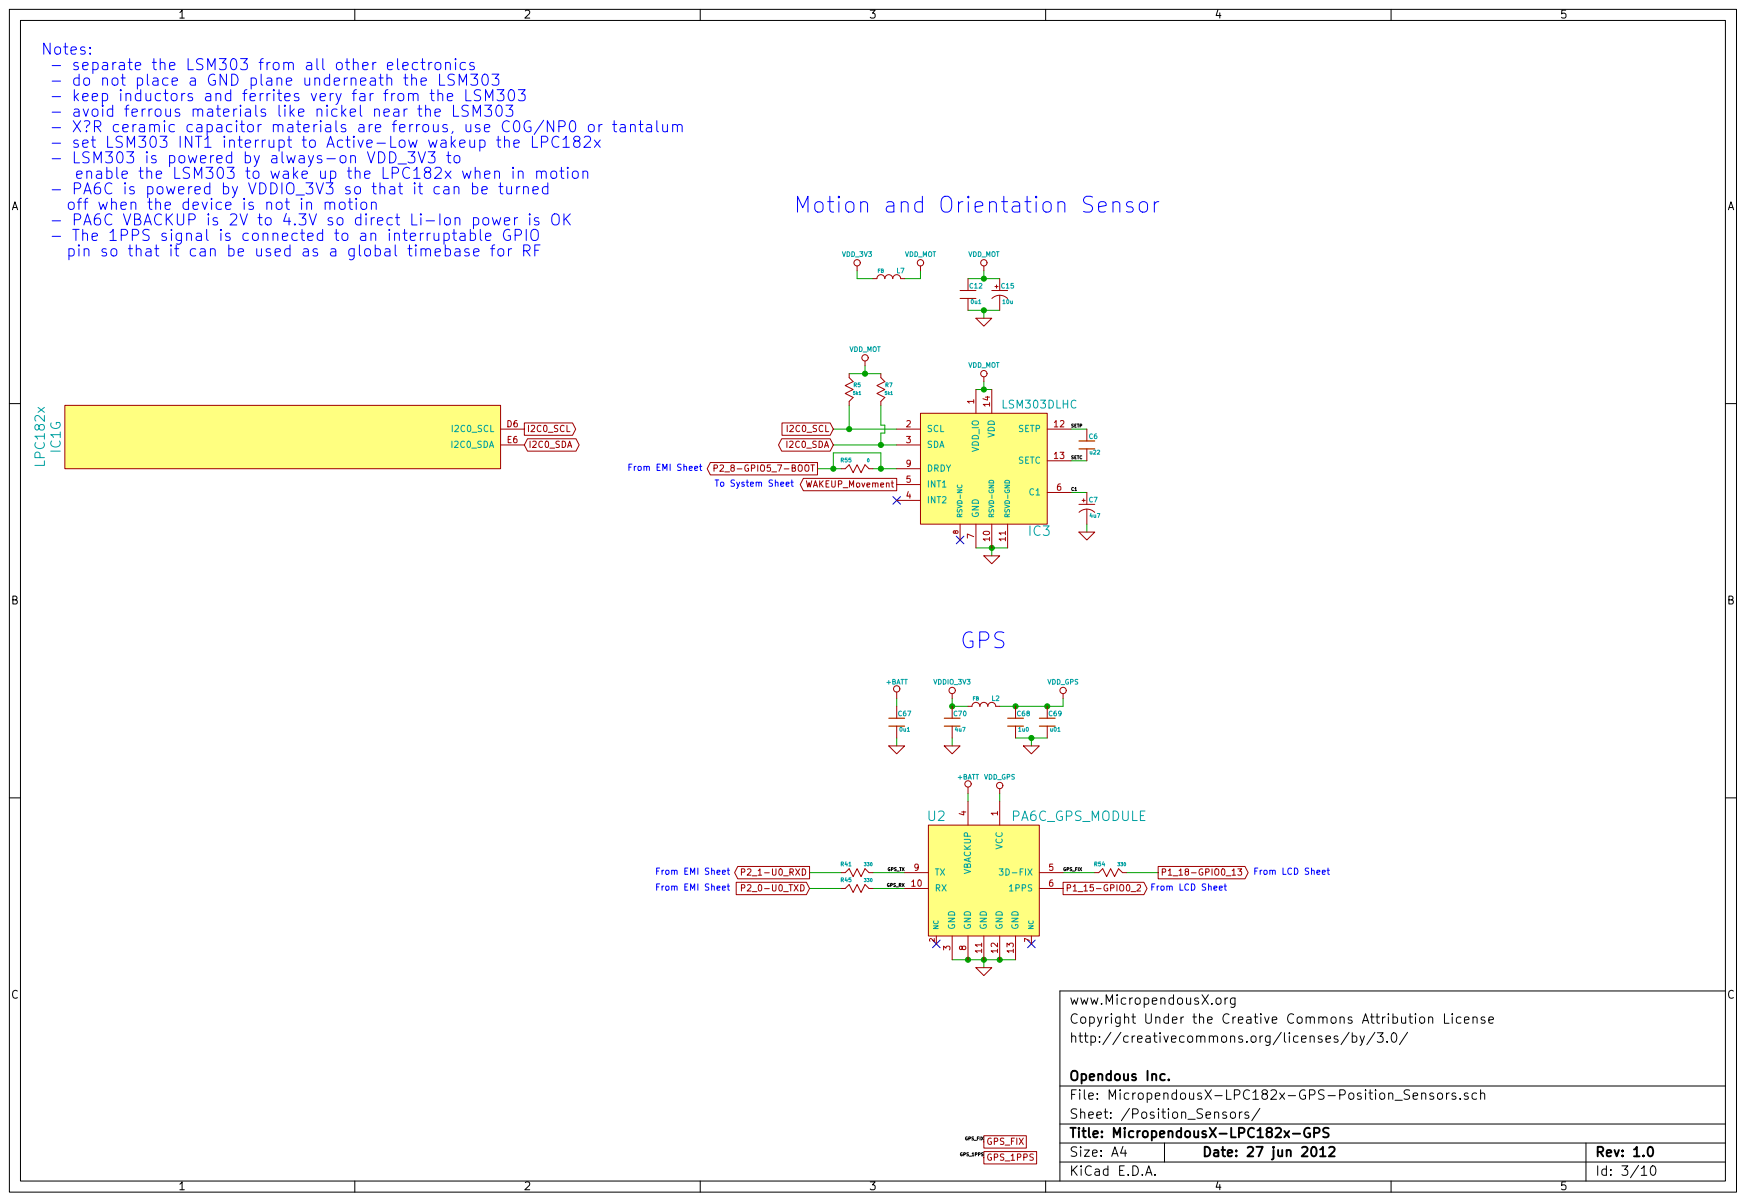
[picture p51: page 8]

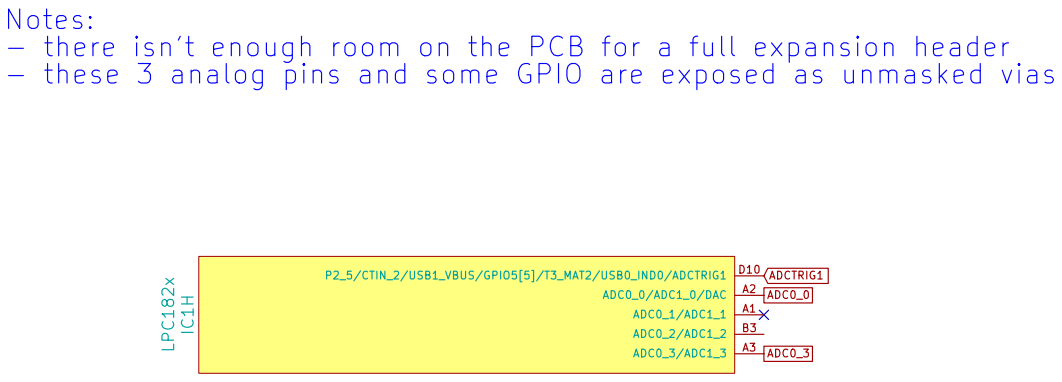
[picture p52: page 9]
