prabhakar06447/micropendousx/MicropendousX/Hardware/MicropendousX-LPC183x/MicropendousX-LPC183x-Schematic-EMI.pdf

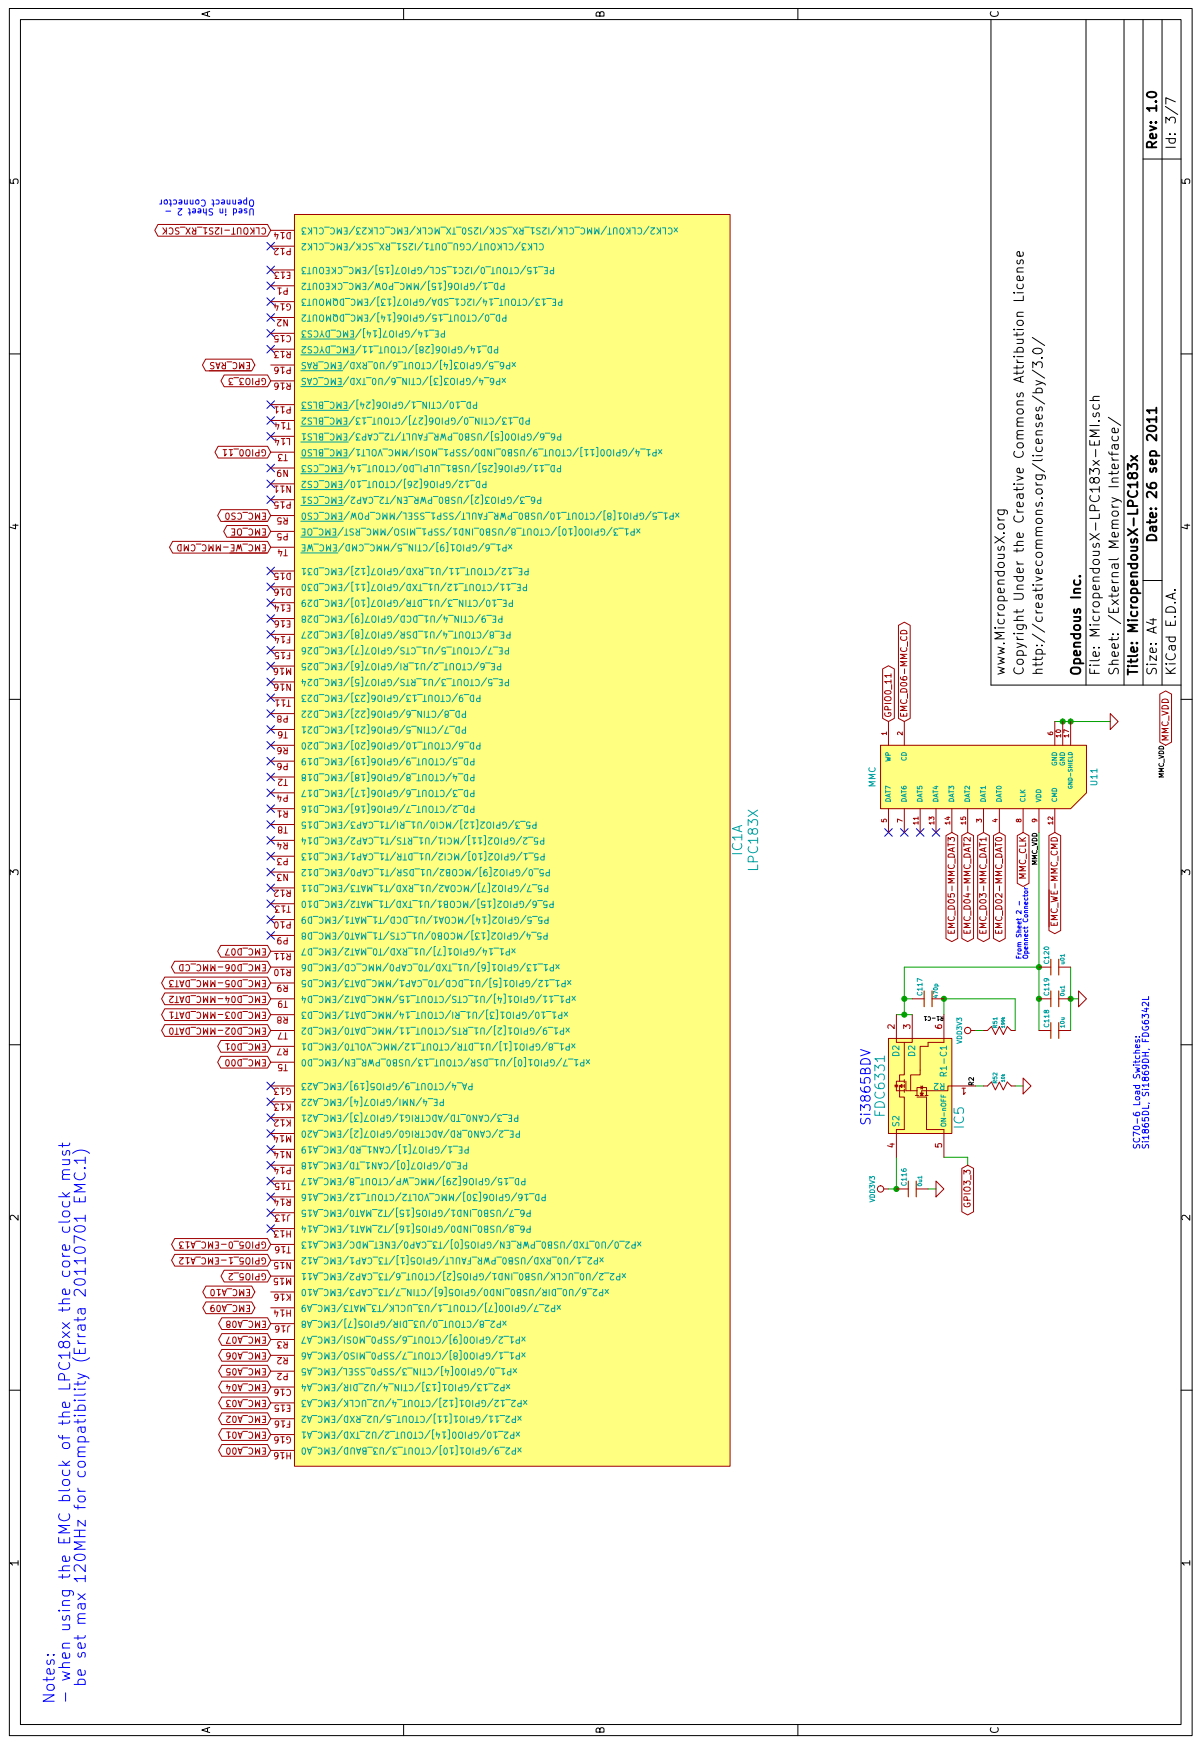
[picture p53: page 1]
