prabhakar06447/micropendousx/MicropendousX/Hardware/MicropendousX-LPC183x/MicropendousX-LPC183x-Schematic-Opennect_Connector.pdf

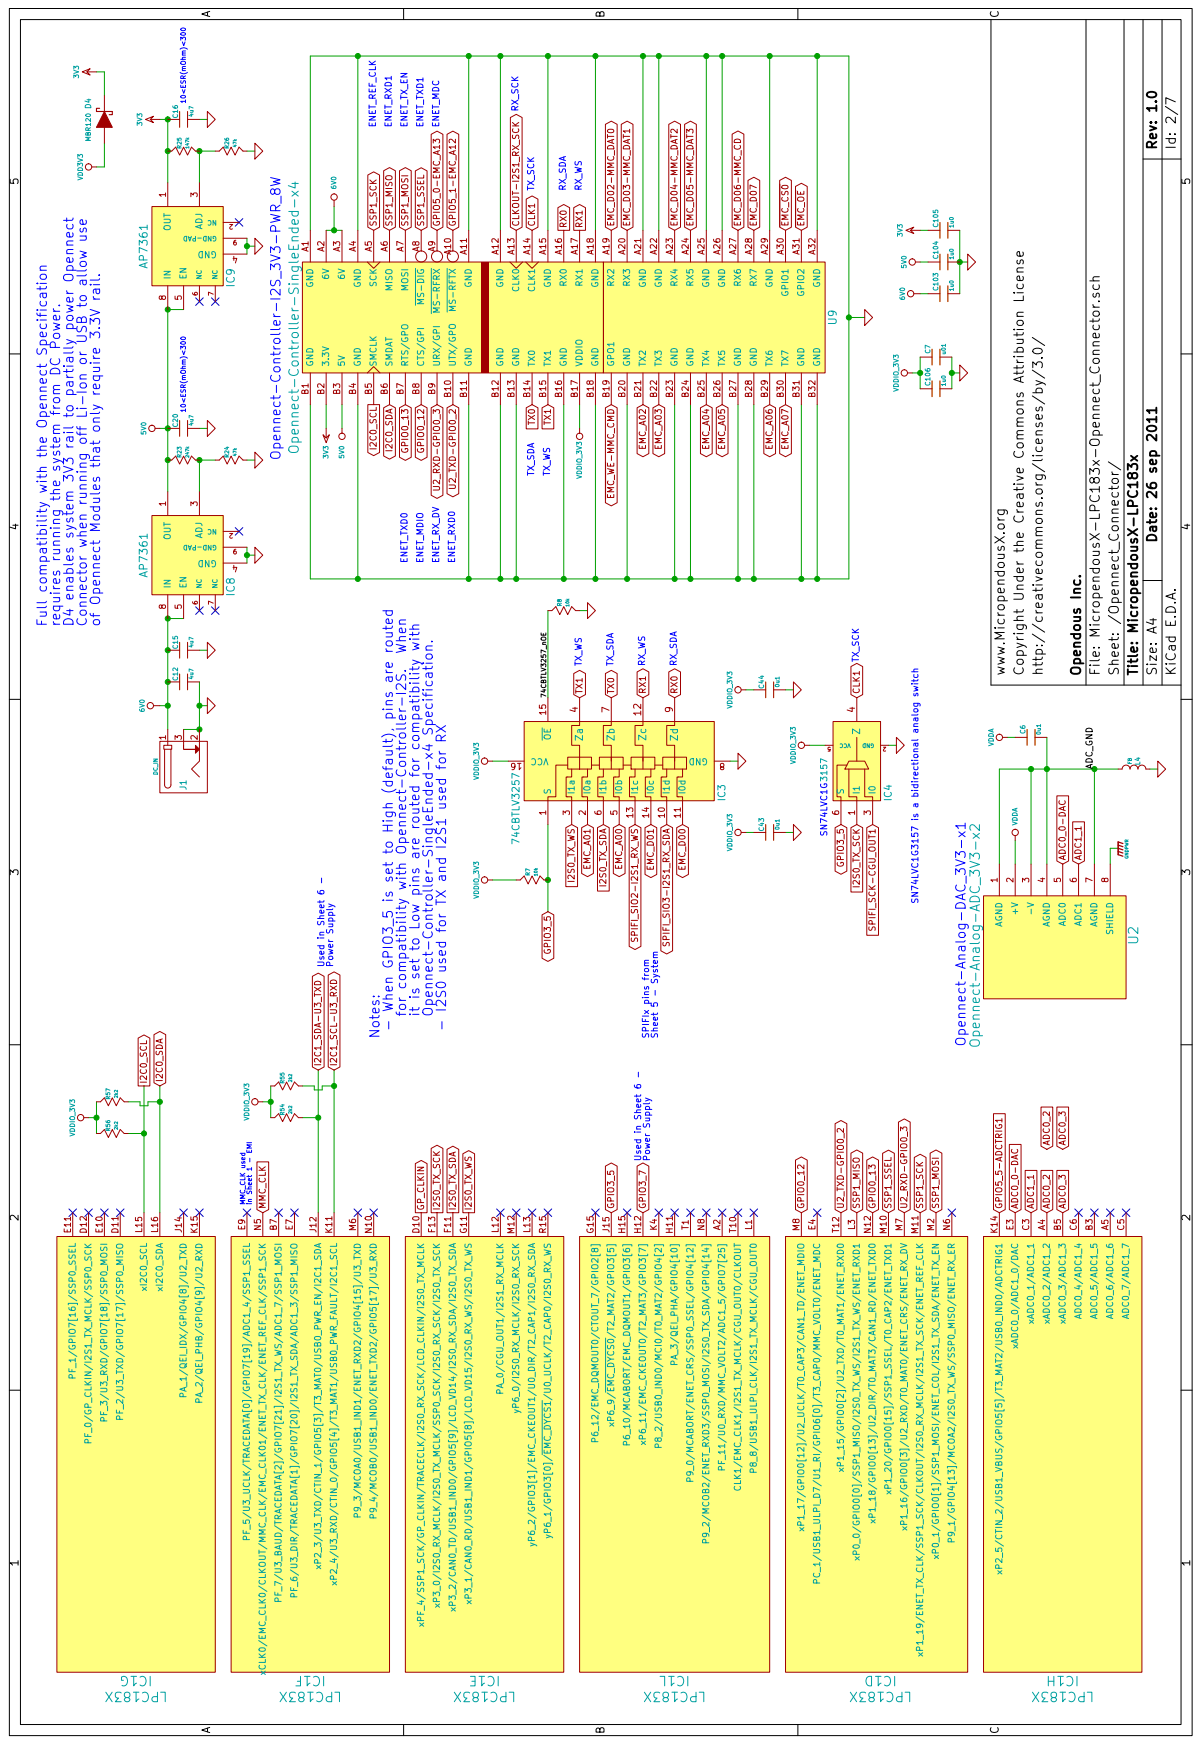
[picture p54: page 1]
