prabhakar06447/micropendousx/MicropendousX/Hardware/MicropendousX-1343/MicropendousX-1343-Schematic.pdf

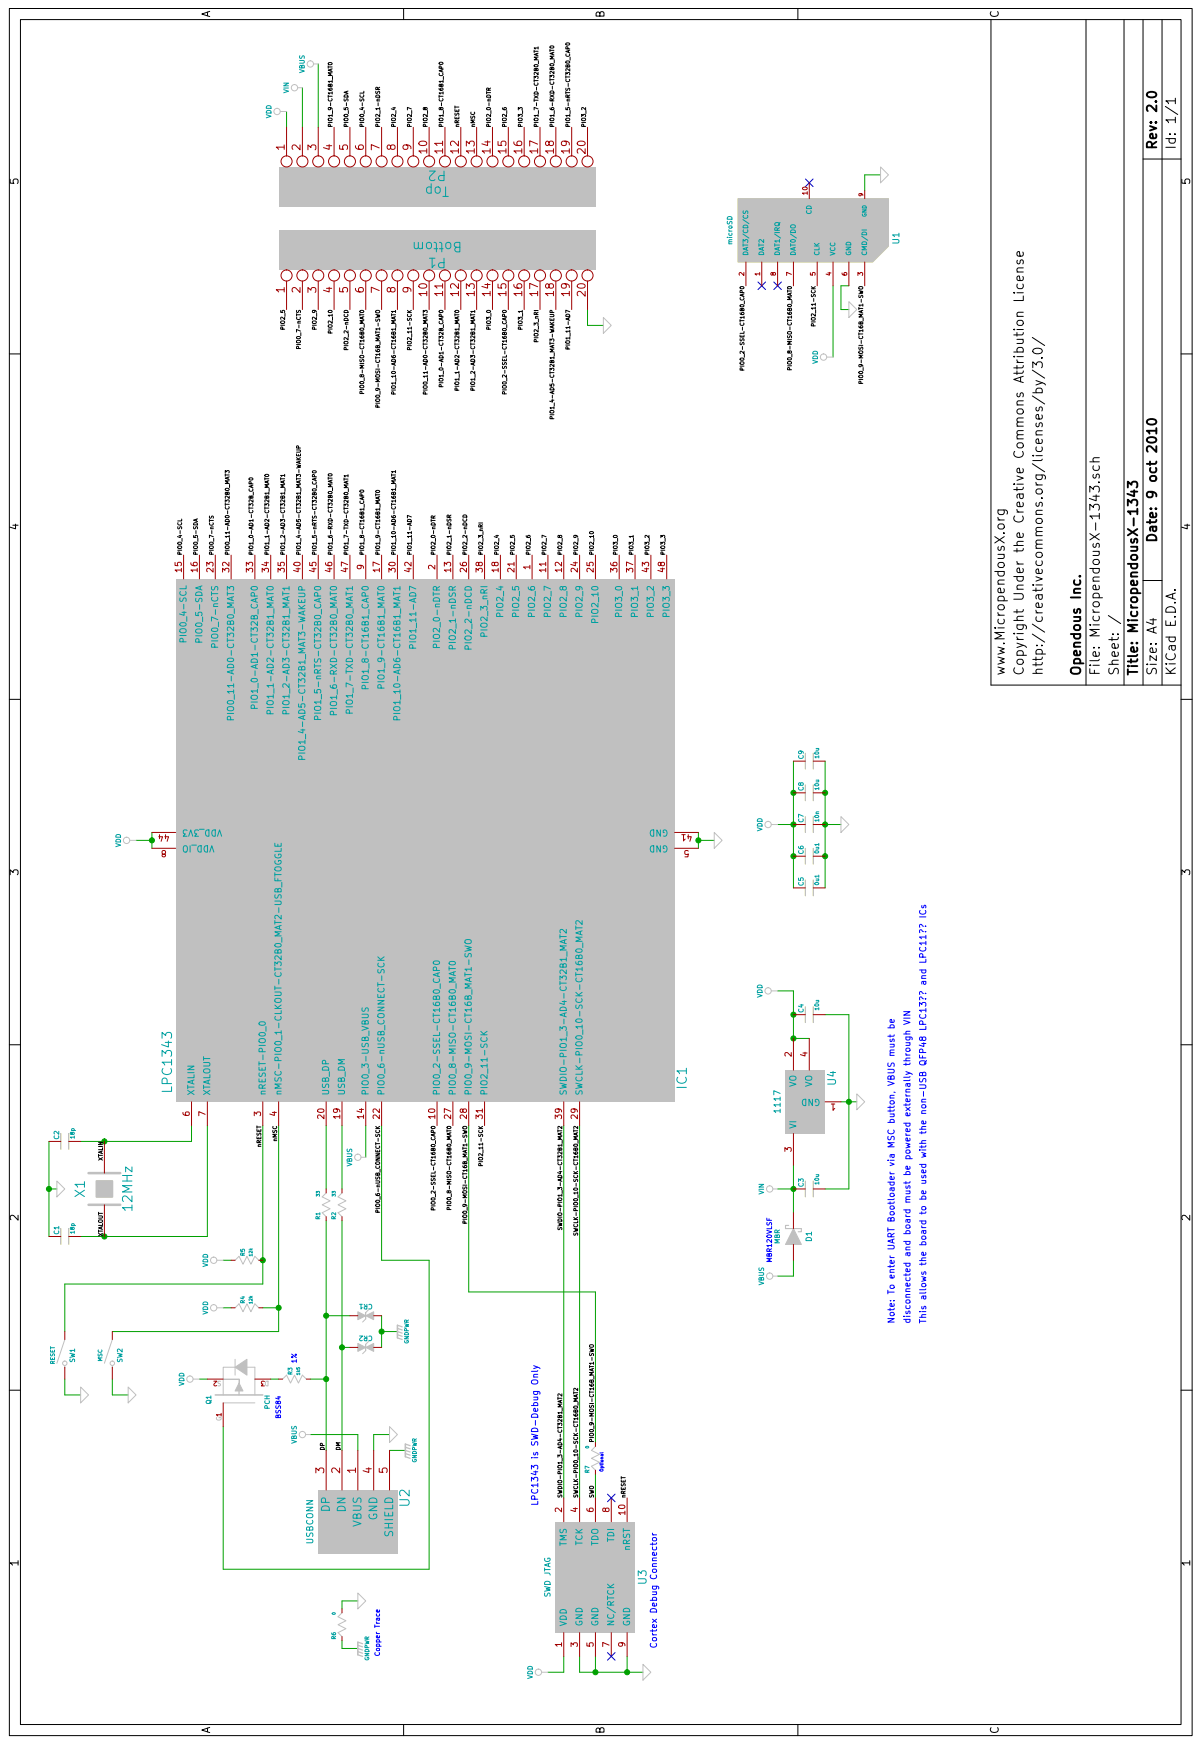
[picture p59: page 1]
