prabhakar06447/micropendousx/MicropendousX/Hardware/MicropendousX-1758/MicropendousX-1758-Schematic.pdf

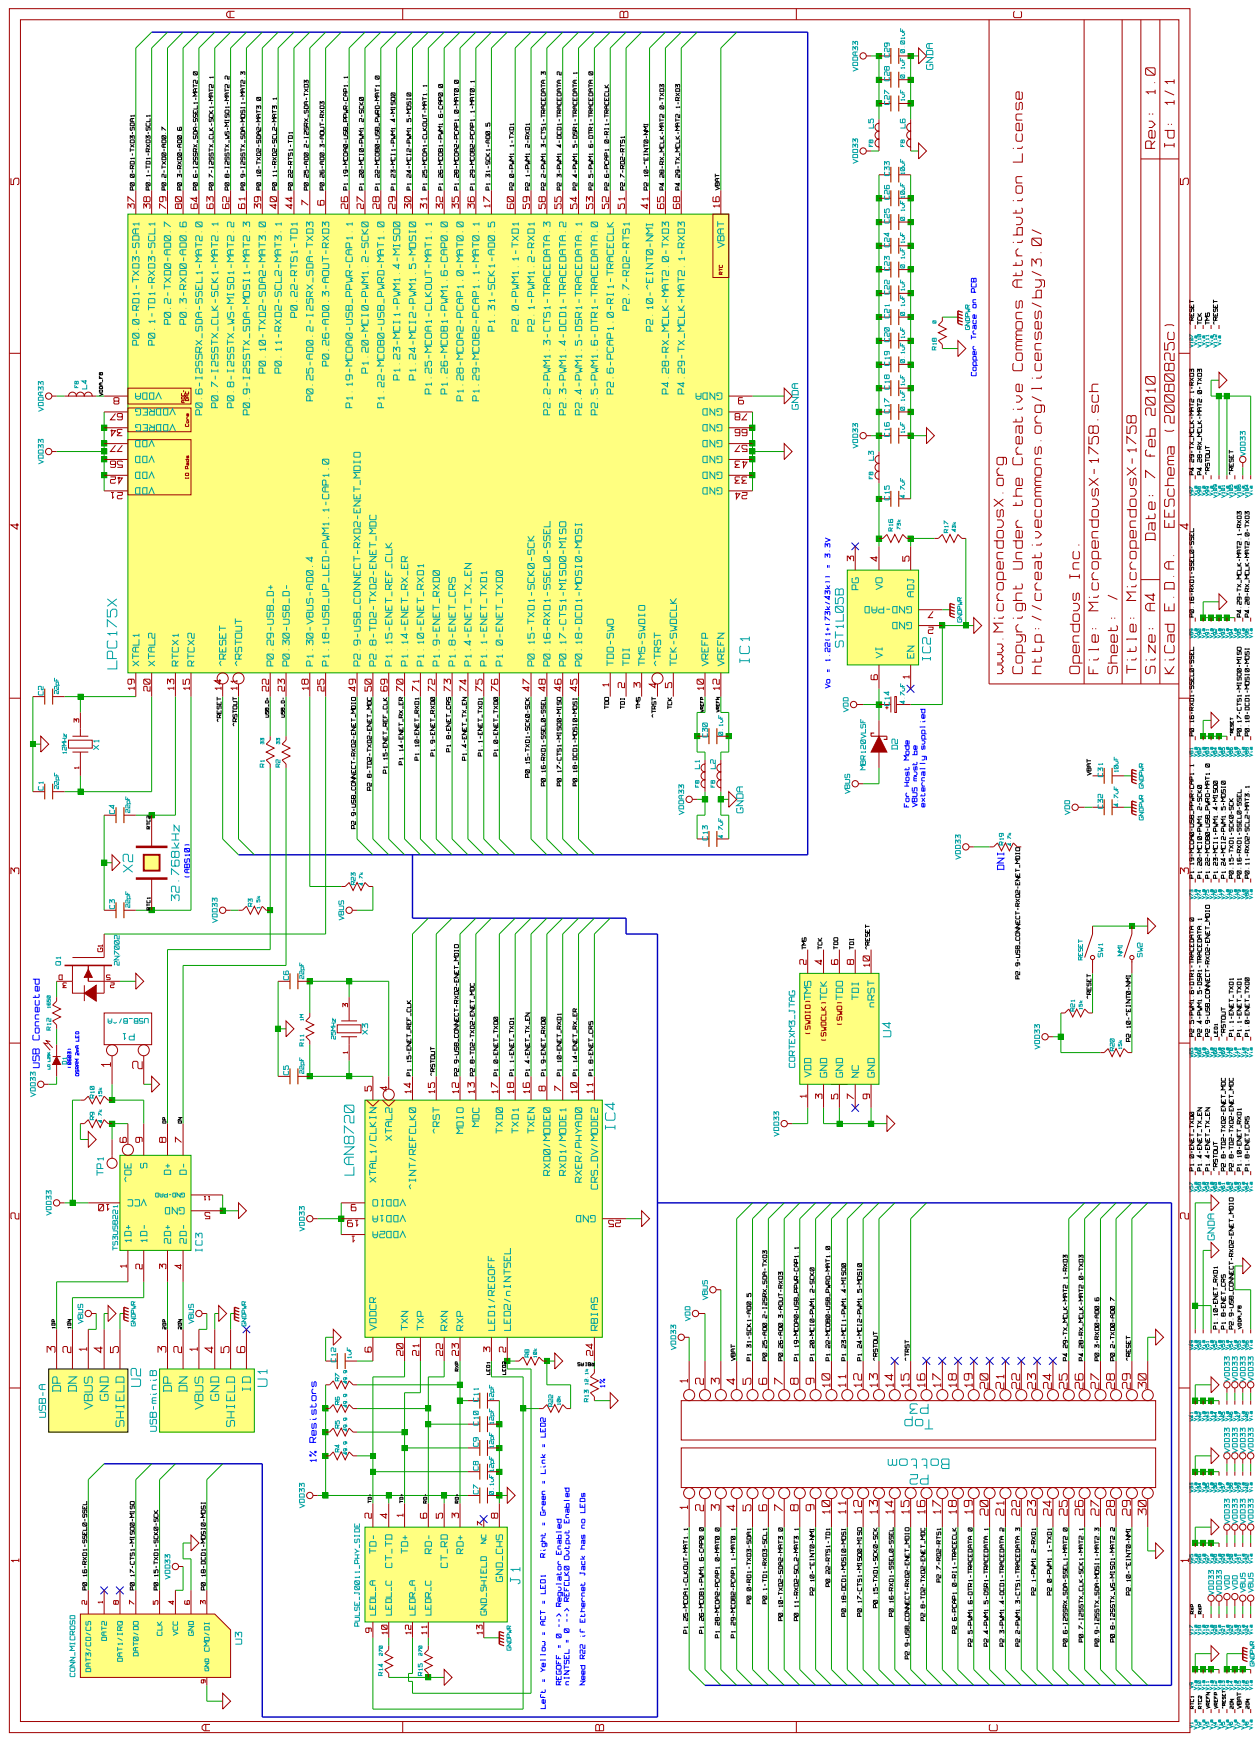
[picture p60: page 1]
