prabhakar06447/micropendousx/MicropendousX/Hardware/MicropendousX-176x/MicropendousX-176x.sch

## KiCad design MicropendousX/Hardware/MicropendousX-176x/MicropendousX-176x.sch (2010-10-13)

Schematic: MicropendousX-176x.sch

Parts:
C1, C2: 33p
C3, C4, C5, C6: 22p
C7, C18, C20, C22, C25, C26, C28, C29, C30, C36, C37, C38, C39, C42: 0u1
C8, C9, C10, C11: 12p
C12, C16: 1u
C13, C17, C19, C21, C24, C41: 10u
C23: u01
C35: 120u
C40: 33u
CR1, CR2: ESD
D1: USB
D2: MBRX120
IC1: LPC176X
IC2: AP2101
IC4: LAN8720
IC5: TS3USB221
J1: PULSE_J0011_PHY_SIDE
L1, L2, L4, L5: FB
P8: Bottom
P9: Top
Q1: PCH
R1, R2, R41: 0
R5, R6, R7, R39: 49.9
R8, R22, R40: 10k
R9, R10, R20, R21, R32, R34, R35: 15k
R11: 1M
R12: 1650
R13: 12k1
R14, R15: 270
R23: 4k7
R33: 1k5
R36, R37: 33
SW1: RESET
SW2: NMI
TP1: CONN_1
U1: USB-miniB
U2: USB-A
U3: microSD
U4: 1117-3.3
U6: JTAG
V1, V2, V4, V5, V9, V10, V11, V12, V13, V14, V15, V16, V21, V22, V26, V27, V28, V29, V30, V31, V32, V33, V34, V36, V37, V38, V39, V41, V42, V44, V45, V46, V47, V50, V52, V62, V64, V70, V71, V73, V76, V77, V78, V81, V83, V84, V85, V86, V87, V89, V90, V92, V94, V95, V97, V101, V103, V106, V107, V108, V109, V110, V112, V113, V115, V117, V119, V121, V124, V125, V127, V128, V130, V131, V132, V133, V135, V136, V139, V140, V141, V142, V143, V144, V145, V146, V147, V148, V150, V151, V152, V153, V154, V156, V157, V159, V166, V167, V168, V169, V170, V171, V174, V175, V176, V177, V179, V180, V181, V182, V183, V184, V185, V186, V187, V188, V189, V190, V191, V192, V193, V194, V195, V196, V197, V198, V199, V200, V201, V202, V203, V204: VIA
X1: 12MHz
X2: 32.768kHz
X3: 25MHz

Notes on the sheet:
BSS84
Populate either:
(R1, R2, CR1, CR2)
(U2, IC2, IC5, C35, C36, R9, R34, R35, R40, R41)
and connect USB-miniB to LPC176x
R1, R2, CR1, CR2 bypass USB switch
Need R22 if Ethernet Jack has no LEDs
1% Resistors
nINTSEL = 0 --> REFCLK0 Output Enabled
REGOFF = 0 --> Regulator Enabled
Left = Yellow = ACT = LED1 / Right = Green = Link = LED2
USB Connected
OSRAM 2mA LED
(0805)
