prabhakar06447/micropendousx/MicropendousX/Hardware/MicropendousX-1343/MicropendousX-1343.sch

## KiCad design MicropendousX/Hardware/MicropendousX-1343/MicropendousX-1343.sch (2010-10-13)

Schematic: MicropendousX-1343.sch

Parts:
C1, C2: 18p
C3, C4, C8, C9: 10u
C5, C6: 0u1
C7: 10n
CR1, CR2: ESD
D1: MBR
IC1: LPC1343
P1: Bottom
P2: Top
Q1: PCH
R1, R2: 33
R3: 1k5
R4, R5: 12k
R6, R7: 0
SW1: RESET
SW2: MSC
U1: microSD
U2: USBCONN
U3: SWD JTAG
U4: 1117
V1, V2, V3, V4, V5, V6, V7, V8, V9, V11, V12, V13, V14, V15, V16, V17, V18, V19, V20, V24, V25, V26, V27, V28, V29, V30, V31, V32, V33, V34, V35, V36, V37, V38, V39, V40, V41, V42, V43, V45, V46, V47, V48, V49, V50, V51, V52, V53, V54, V55, V56, V57, V58, V59, V60, V61, V62, V63, V64, V65, V66, V67, V68: VIA
X1: 12MHz

Notes on the sheet:
Cortex Debug Connector
LPC1343 is SWD-Debug Only
Optional
This allows the board to be used with the non-USB QFP48 LPC13?? and LPC11?? ICs
BSS84
MBR120VLSF
Copper Trace
disconnected and board must be powered externally through VIN
Note: To enter UART Bootloader via MSC button, VBUS must be
