prabhakar06447/micropendousx/MicropendousX/Hardware/MicropendousX-1758/MicropendousX-1758.sch

## KiCad design MicropendousX/Hardware/MicropendousX-1758/MicropendousX-1758.sch (2010-02-08)

Schematic: MicropendousX-1758.sch

Parts:
C1, C2, C3, C4, C5, C6: 22pF
C7, C17, C19, C21, C23, C25, C28, C30: 0.1uF
C8, C9, C10, C11: 12pF
C12, C16, C18, C20, C22, C24, C27: 1uF
C13, C14, C15, C32: 4.7uF
C26, C31, C33: 10uF
C29: 0.01uF
D1: LO L29K
D2: MBR120VLSF
IC1: LPC175X
IC2: ST1L05B
IC3: TS3USB221
IC4: LAN8720
J1: PULSE_J0011_PHY_SIDE
L1, L2, L3, L4, L5, L6: FB
P1: USB_B/^A
P2: Bottom
P3: Top
Q1: 2N7002
R1, R2: 33
R3: 1.5k
R4, R5, R6, R7: 49.9
R8, R22: 10k
R9, R19, R23: 4.7k
R10, R20, R21: 15k
R11: 1M
R12: 1650
R13: 12.1k
R14, R15: 270
R16: 73k
R17: 43k
R18: 0
SW1: RESET
SW2: NMI
TP1: CONN_1
U1: USB-miniB
U2: USB-A
U3: CONN_MICROSD
U4: CORTEXM3_JTAG
V1, V2, V3, V4, V5, V6, V7, V8, V9, V10, V11, V12, V13, V14, V15, V16, V17, V18, V19, V20, V21, V22, V23, V24, V25, V26, V27, V28, V29, V30, V31, V32, V33, V34, V35, V36, V37, V38, V39, V40, V41, V42, V43, V44, V45, V46, V47, V48, V49, V50, V51, V52, V53, V54, V55, V56, V57, V58, V59, V60, V61, V62, V63, V64, V65, V66, V67, V68, V69, V70, V71, V72, V73, V74, V75, V76, V77, V78, V79, V80, V81, V82, V83, V84, V85, V86, V87, V88, V89, V90, V91, V92, V93, V94, V95, V96, V97, V98, V99, V101, V104, V105, V106, V107, V109, V110, V111, V112: VIA
X1: 12MHz
X2: 32.768kHz
X3: 25MHz

Notes on the sheet:
Need R22 if Ethernet Jack has no LEDs
externally supplied
VBUS must be
For Host Mode
1% Resistors
nINTSEL = 0 --> REFCLK0 Output Enabled
DNI
REGOFF = 0 --> Regulator Enabled
Left = Yellow = ACT = LED1 Right = Green = Link = LED2
USB Connected
(ABS10)
OSRAM 2mA LED
(0603)
Copper Trace on PCB
Vo = 1.22(1+(73k/43k)) = 3.3V
