prabhakar06447/micropendousx/MicropendousX/Hardware/MicropendousX-GPS/MicropendousX-LPC182x-GPS-EMI.sch

## KiCad design MicropendousX/Hardware/MicropendousX-GPS/MicropendousX-LPC182x-GPS-EMI.sch (2012-06-27)

Schematic: MicropendousX-LPC182x-GPS-EMI.sch

Parts:
C51: 470p
C52: 1u0
C118: 4u7
C119: 0u1
C120: u01
IC1: LPC182x
IC5: FDG
R51: 47k
R52: 2k2
TP3: ISP
U11: microSD

Notes on the sheet:
Used in Power Supply Sheet
Used in LCD Sheet
6342L
Used in Position Sensors Sheet
Used in System and Position Sensors Sheets
Used in System Sheet
Used in RF Sheet
Co = 4.81uF
R1-C1, R2 circuitry enables slow startup to limit inrush current R1 >> 10*R2 R1=47k, R2=2k2 ==> Ton=4us Toff=R1*Co=47000*0.00000481=0.23s
Used in RF and System Sheets
P2_7 has weak internal pull-up to disable ISP
Hirose DM3D-SF
Notes: -
Si1865DL, Si1869DH
