prabhakar06447/micropendousx/MicropendousX/Hardware/MicropendousX-GPS/MicropendousX-LPC182x-GPS-LCD.sch

## KiCad design MicropendousX/Hardware/MicropendousX-GPS/MicropendousX-LPC182x-GPS-LCD.sch (2012-06-27)

Schematic: MicropendousX-LPC182x-GPS-LCD.sch

Parts:
C71, C72, C76: 0u1
IC1: LPC182x
IC4: STMPE610
R26, R27: 5k1
R28, R29: 0
R30: 47k
R31: 50
U3: LCD_JD-T18002

Notes on the sheet:
From EMI Sheet
Used in Position Sensors Sheet
Resistive Touchscreen Controller
LCD and Resistive Touchscreen
I2C1 pins also used in Power Supply and System Sheets
INT is open-drain
Notes - Enable the Touchscreen controller to wake up the processor - Run STMPE610 on always-on VDD to enable Touchscreen wakeup - Run LCD on VDDIO since it does not need to always be on and has leakage currents - P1_7-GPIO0_12 is a High Drive Strength Pin that can source 32mA to the LCD Backlight L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
