prabhakar06447/micropendousx/MicropendousX/Hardware/MicropendousX-GPS/MicropendousX-LPC182x-GPS-Position_Sensors.sch

## KiCad design MicropendousX/Hardware/MicropendousX-GPS/MicropendousX-LPC182x-GPS-Position_Sensors.sch (2012-06-27)

Schematic: MicropendousX-LPC182x-GPS-Position_Sensors.sch

Parts:
C6: u22
C7, C70: 4u7
C12, C67: 0u1
C15: 10u
C68: 1u0
C69: u01
IC1: LPC182x
IC3: LSM303DLHC
L2, L7: FB
R5, R7: 5k1
R41, R45, R54: 330
R55: 0
U2: PA6C_GPS_MODULE

Notes on the sheet:
Motion and Orientation Sensor
GPS
To System Sheet
From LCD Sheet
From EMI Sheet
Notes: - separate the LSM303 from all other electronics - do not place a GND plane underneath the LSM303 - keep inductors and ferrites very far from the LSM303 - avoid ferrous materials like nickel near the LSM303 - X?R ceramic capacitor materials are ferrous, use C0G/NP0 or tantalum - set LSM303 I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
