prabhakar06447/micropendousx/MicropendousX/Hardware/MicropendousX-GPS/MicropendousX-LPC182x-GPS-Power.sch

## KiCad design MicropendousX/Hardware/MicropendousX-GPS/MicropendousX-LPC182x-GPS-Power.sch (2012-06-27)

Schematic: MicropendousX-LPC182x-GPS-Power.sch

Parts:
BAT1: Li-Ion
C9, C17, C18, C22, C34, C66: 1u0
C10: u22
C11, C27, C29, C65: 4u7
C13, C54, C55: 10u
C14, C21, C24, C36, C37, C50, C64, C73, C75: 0u1
C26: 2u2
C30, C32: 22p
C74, C107: u01
C115: 1u
D1: CHRG
D2: BAT54C
IC1: LPC182x
IC2: STC3100
IC6: LTC3559
L1, L3: FB
L5, L6: 4.7uH
R3: 0R03
R4, R12, R49: 1k
R6: 200k
R9, R20, R22, R23, R40: 47k
R14: 10k
R15: 1k74
R16, R18: 806k
R17, R19: 261k
R21: 0R5
R38: 5k1
R48: 12k
R56: 0
U5: BUF

Notes on the sheet:
From EMI Sheet
P2_7-GPIO0_7-ISP has a weak internal pull-up to disable ISP
EN1 and EN2 are high impedance inputs that are active-high
This buffer is powered by EN1 to ensure that VDD and VDDIO ramp up at the same time after reset. MCU can later tri-state this buffer to disable VDDIO.
74LVC1G126
SUSP internal pull-down is too weak to overcome LPC182x 45k+ pull-up and thus requires external pull-down 3.3(5.1/(5.1+45))=0.34V < Vil=0.4V
Notes: - Boot pins have weak internal pull-ups of about 50k Ohm to VDDIO so VDDIO_3V3 must be enabled at the same time as VDD_3V3 at startup - MODE HIGH enables Burst Mode which is more efficient at lower power - HPWR and SUSP have 2M Ohm weak pull-downs - regulator outputs 3.3V nominal but lowerin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
VBAT must be < 3.6V
If either VBUS or battery are present, main VDD power supply will be enabled.
I2C1 from LCD Sheet
R14 = 1.74k limits USB charge current to 500mA
Li-Ion Charger, Guage, and Dual Buck Regulators
Power Management
0805
0.1%
1206
