prabhakar06447/micropendousx/MicropendousX/Hardware/MicropendousX-GPS/MicropendousX-LPC182x-GPS-RF.sch

## KiCad design MicropendousX/Hardware/MicropendousX-GPS/MicropendousX-LPC182x-GPS-RF.sch (2012-06-27)

Schematic: MicropendousX-LPC182x-GPS-RF.sch

Parts:
A1: 315MHz
C16, C23, C25, C33, C35, C38, C39, C40, C41, C42, C43, C45: 47n
C19, C20: 1u0
C28, C31: 15p
C44: 1n8
C46, C49, C57: 5p1
C47, C60: u01
C48: 39p
C53: u22
C56: 2p2
C58: 56p
C59: 6p2
C61: DNI
C62: 100p
IC9: CC112X
L4: FB
L8, L15: 56n
L9, L12: 27n
L13, L14: 15n
L16: 43n
L17: 22n
R24: 47k
R25: 0
R32: 56k
R33: 18
X3: 40MHz

Notes on the sheet:
WARNING: Current RF filter inductor and capacitor values are for 420MHz
From EMI Sheet, also used in System Sheet
From EMI Sheet (U2_TXD)
From EMI Sheet (U2_UCLK)
To System Sheet
From EMI Sheet
No OSC, using Crystal X3
Notes: - Target 315MHz RF Band (Short Data Packets, No Streaming, Limited Power) for Sensor Nodes - Use to transfer Identification and Control signals between nodes - Refer to Linx Application Note AN-00125 for FCC15.231 A-D Overview - CC1125 DS 1.12: 315/40=7.9, 40*8=320, (320-315)=5>1MHz TX, simi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
