prabhakar06447/micropendousx/MicropendousX/Hardware/MicropendousX-GPS/MicropendousX-LPC182x-GPS-System.sch

## KiCad design MicropendousX/Hardware/MicropendousX-GPS/MicropendousX-LPC182x-GPS-System.sch (2012-06-27)

Schematic: MicropendousX-LPC182x-GPS-System.sch

Parts:
C1, C2, C3, C4: 10pF
C5: u01
C8, C63, C108: 0u1
IC1: LPC182x
IC7: 25Q
IC8: 3AND
IC10: E48
JP8: JUMPER-3
R11, R36: 47k
R37, R39, R42, R43, R44: 10k
R50: 100
TP1: nTRST
TP2: DBGEN
TP4: ALARM
U4: JTAG
X1: 12MHz
X2: 32.768kHz

Notes on the sheet:
(SPF)
(USB)
24AA02
All WAKEUP signal sources have programmable polarity
EUI-64 Node Identity
From LCD Sheet
74LVC1G11
NC7SZ11
JTAG
Maximum 16MBit per Errata R1.3 SPIFI.2
Notes: - Run core system on always-on VDD_3V3 - Internal Rpu is minimum 45k Ohm, so for boot selection pull-down resistor, 19k is max. usable as 3.3(19/(19+45))=0.98V < Vil=(3.3*.3)=1V - E48 EEPROM is used to give every node its own unique EUI-64 address
WAKEUP signal sources are run on VDD_3V3
TDO need not be pulled up since TCK pull-down ensures no random data is ever sent as TDO is only valid when clock is valid.
Note boot pins have weak internal pull-ups of about 50k Ohm to VDDIO
nTRST, TMS, and TDI have weak internal pull-up resistors
WAKEUP has internal weak pull-up so use it Active-Low
LOW
HIGH
USART3
Taken from LPC18x0 Datasheet - Table 5
EMC 32-Bit
USB0
SPI (SSP)
USB1
EMC 8-Bit
EMC 16-Bit
SPIFI
USART0
P1_2(A7)
P1_1(A6)
P2_8(A8)
P2_9(A0)
Boot Mode
Boot Mode Selection
This is equivalent to nSRST
Power-up Reset is not reliable with fast VDD ramps so a Reset delay is required (Errata 20110701 POR.1)
