prabhakar06447/micropendousx/MicropendousX/Hardware/MicropendousX-GPS/MicropendousX-LPC182x-GPS-USB.sch

## KiCad design MicropendousX/Hardware/MicropendousX-GPS/MicropendousX-LPC182x-GPS-USB.sch (2012-06-27)

Schematic: MicropendousX-LPC182x-GPS-USB.sch

Parts:
CR1, CR2: ESD
F1: F
IC1: LPC182x
L10: FBX
L11: FBY
U1: USB-microAB

Notes on the sheet:
use
USB0_ID has an internal pull-up resistor to indicate B Device
USB Device Mode
VBUS pin will remain high for several seconds after USB disconnect
Notes: - USB VBUS Fuse F1 limits inrush current with its 0.5 ohm typical resistance - FBX ferrite bead is high DCR 0805 - FBY ferrite beads are high current 0805 - Choose PTC fuse with 750mA Ihold for temperature compensation - internal pull-up on USB ID pin indicates B device
High DCR
To Host
