prabhakar06447/micropendousx/MicropendousX/Hardware/MicropendousX-GPS/MicropendousX-LPC182x-GPS-Vias.sch

## KiCad design MicropendousX/Hardware/MicropendousX-GPS/MicropendousX-LPC182x-GPS-Vias.sch (2012-06-27)

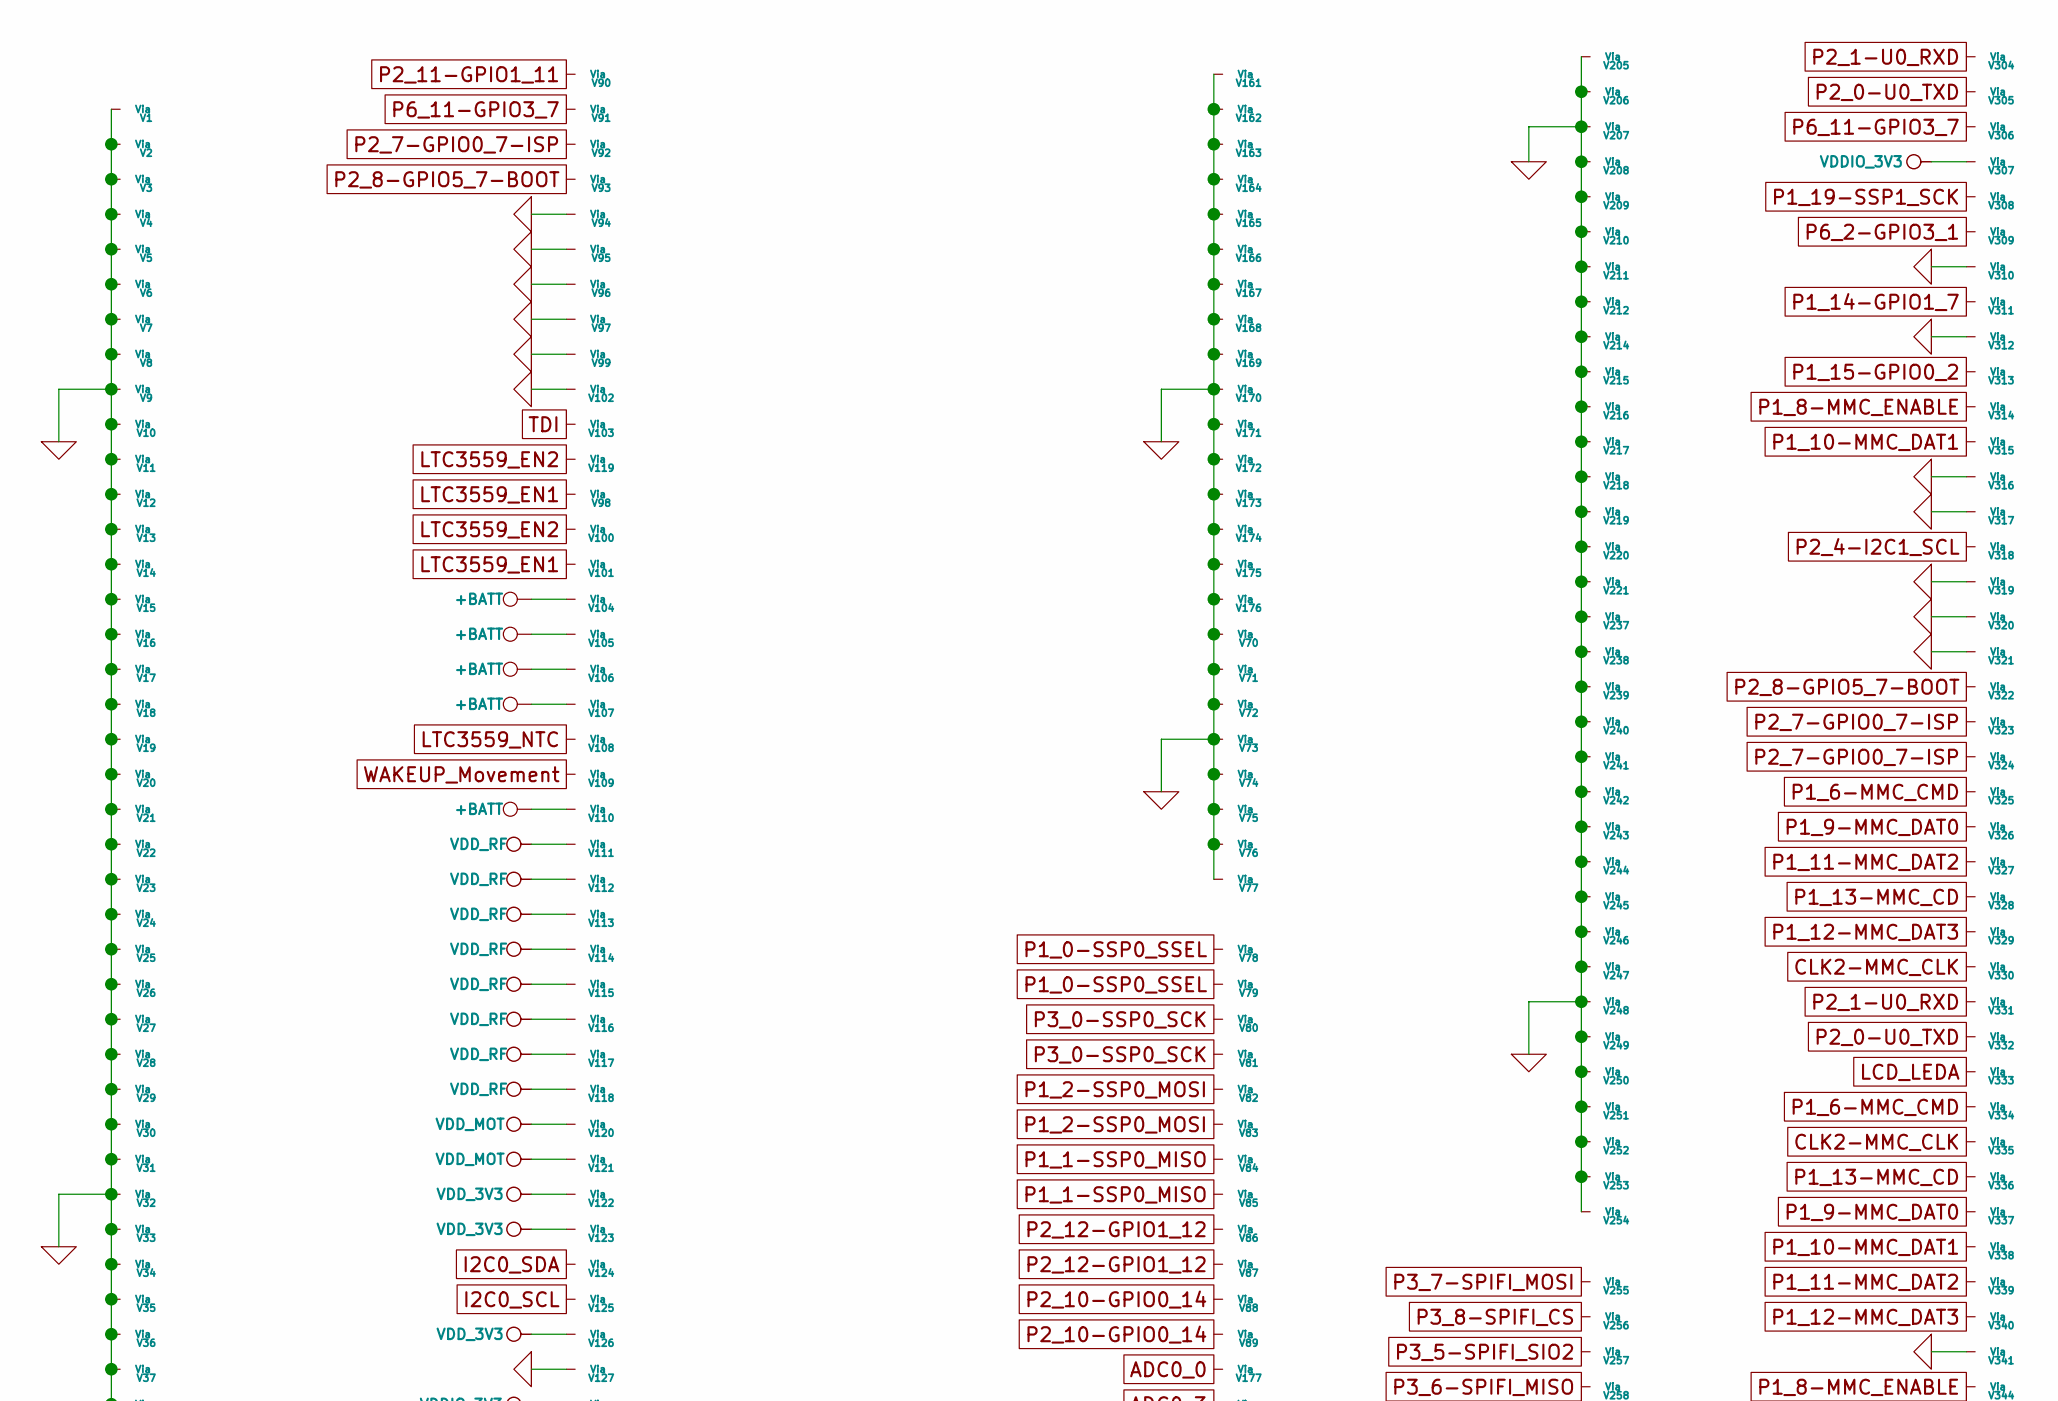
[picture p61: schematic MicropendousX-LPC182x-GPS-Vias.sch, part in row 1, column 1]

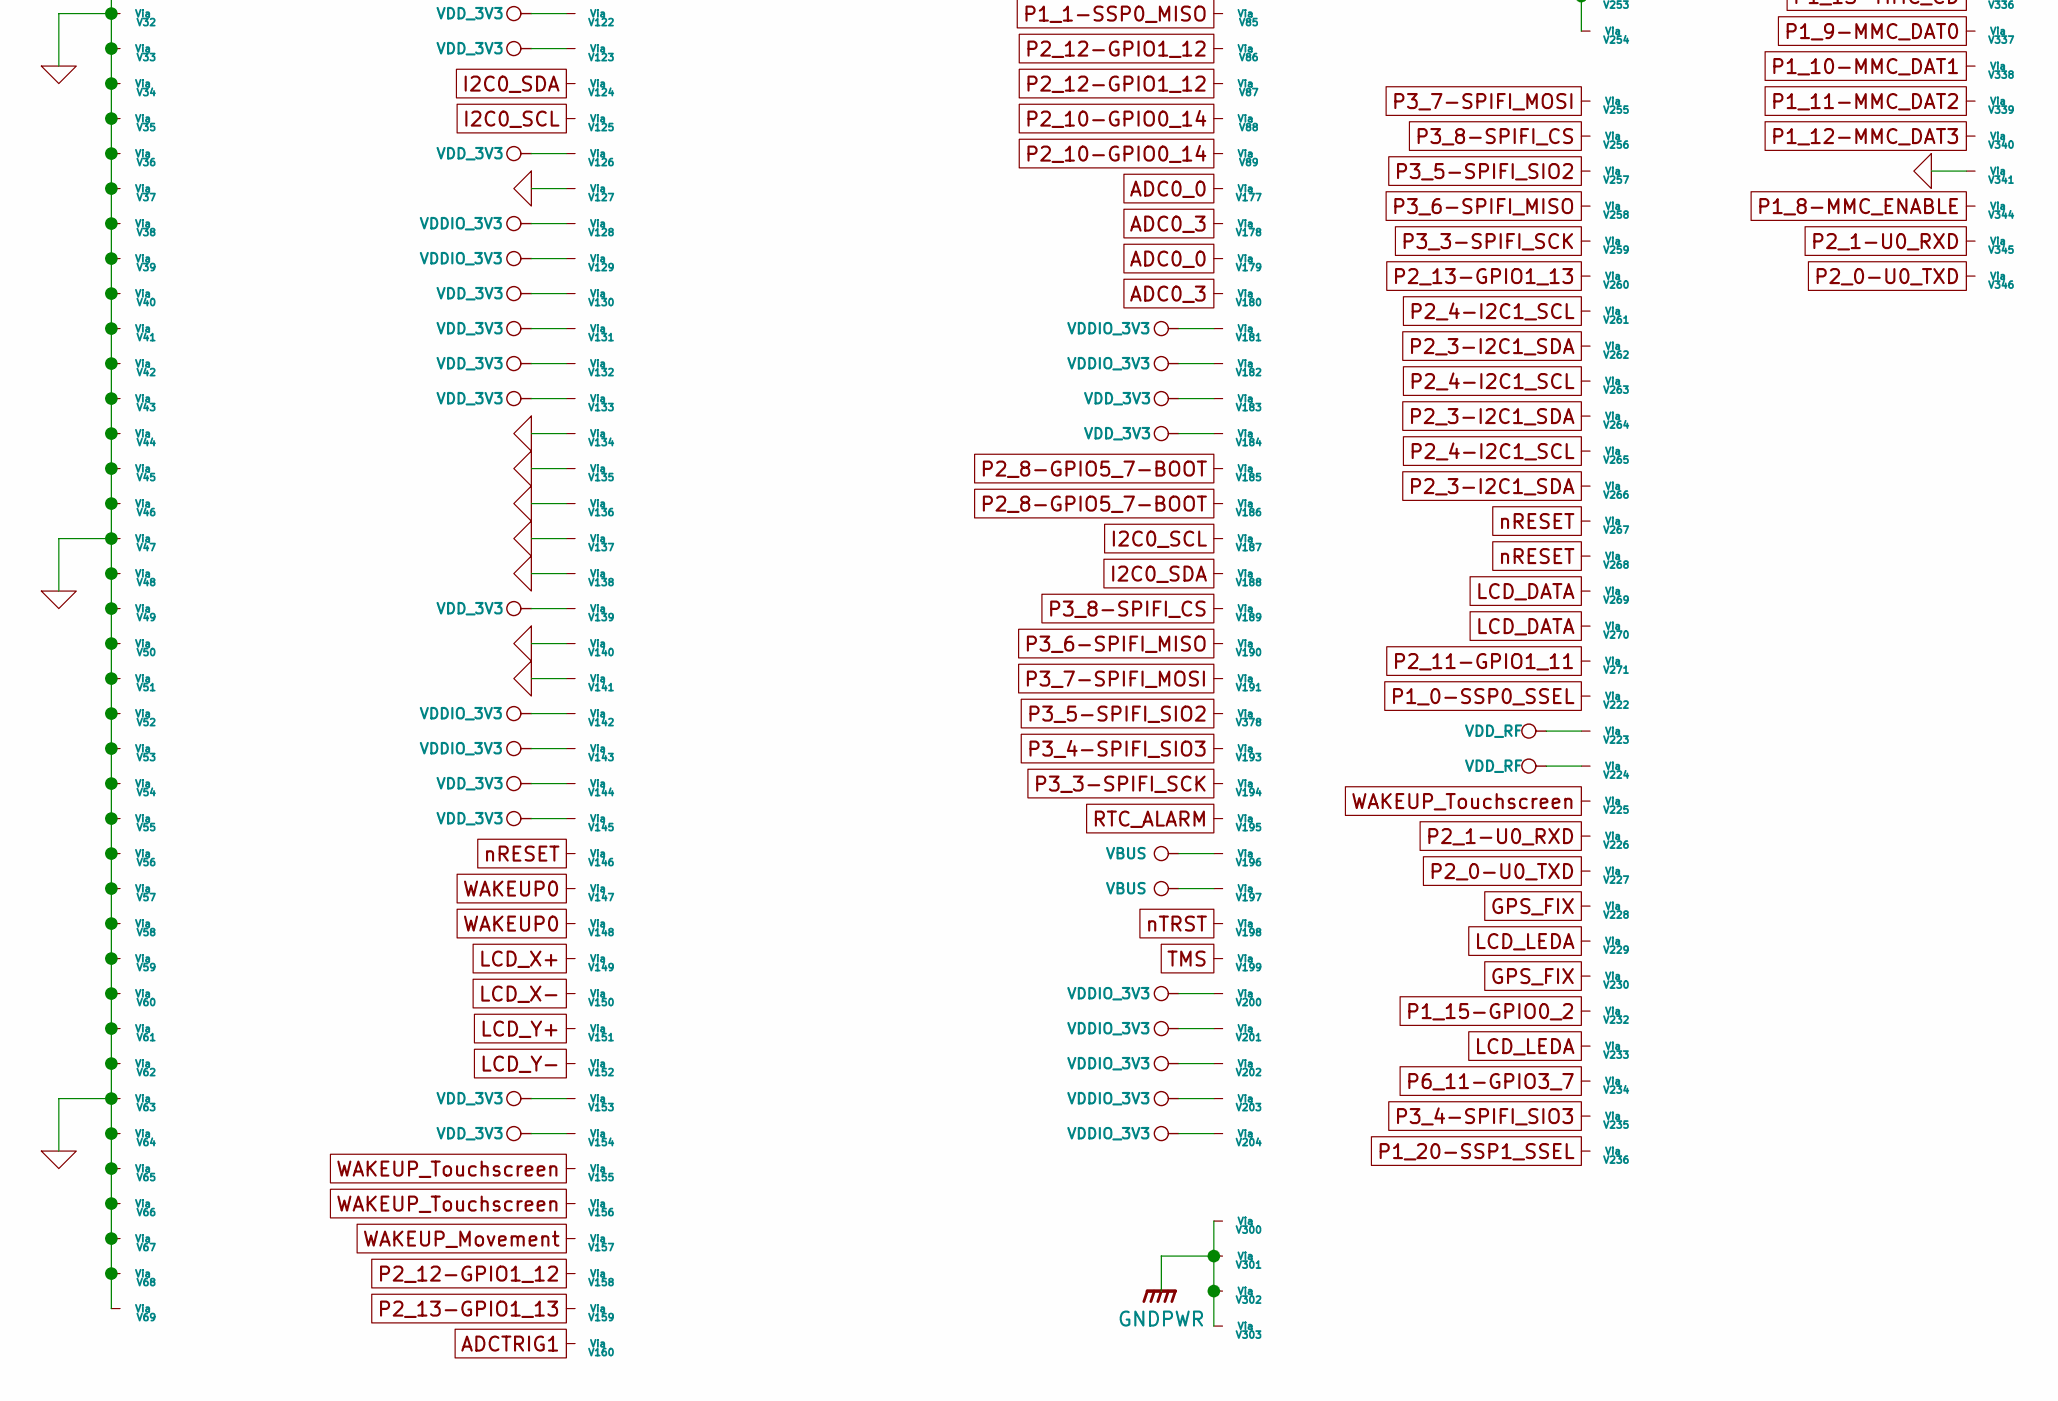
[picture p62: schematic MicropendousX-LPC182x-GPS-Vias.sch, part in row 2, column 1]

Parts:
V1, V2, V3, V4, V5, V6, V7, V8, V9, V10, V11, V12, V13, V14, V15, V16, V17, V18, V19, V20, V21, V22, V23, V24, V25, V26, V27, V28, V29, V30, V31, V32, V33, V34, V35, V36, V37, V38, V39, V40, V41, V42, V43, V44, V45, V46, V47, V48, V49, V50, V51, V52, V53, V54, V55, V56, V57, V58, V59, V60, V61, V62, V63, V64, V65, V66, V67, V68, V69, V70, V71, V72, V73, V74, V75, V76, V77, V78, V79, V80, V81, V82, V83, V84, V85, V86, V87, V88, V89, V90, V91, V92, V93, V94, V95, V96, V97, V98, V99, V100, V101, V102, V103, V104, V105, V106, V107, V108, V109, V110, V111, V112, V113, V114, V115, V116, V117, V118, V119, V120, V121, V122, V123, V124, V125, V126, V127, V128, V129, V130, V131, V132, V133, V134, V135, V136, V137, V138, V139, V140, V141, V142, V143, V144, V145, V146, V147, V148, V149, V150, V151, V152, V153, V154, V155, V156, V157, V158, V159, V160, V161, V162, V163, V164, V165, V166, V167, V168, V169, V170, V171, V172, V173, V174, V175, V176, V177, V178, V179, V180, V181, V182, V183, V184, V185, V186, V187, V188, V189, V190, V191, V193, V194, V195, V196, V197, V198, V199, V200, V201, V202, V203, V204, V205, V206, V207, V208, V209, V210, V211, V212, V214, V215, V216, V217, V218, V219, V220, V221, V222, V223, V224, V225, V226, V227, V228, V229, V230, V232, V233, V234, V235, V236, V237, V238, V239, V240, V241, V242, V243, V244, V245, V246, V247, V248, V249, V250, V251, V252, V253, V254, V255, V256, V257, V258, V259, V260, V261, V262, V263, V264, V265, V266, V267, V268, V269, V270, V271, V300, V301, V302, V303, V304, V305, V306, V307, V308, V309, V310, V311, V312, V313, V314, V315, V316, V317, V318, V319, V320, V321, V322, V323, V324, V325, V326, V327, V328, V329, V330, V331, V332, V333, V334, V335, V336, V337, V338, V339, V340, V341, V344, V345, V346, V378: VIA

Connections:
+BATT: V104.1, V105.1, V106.1, V107.1, V110.1
ADC0_0: V177.1, V179.1
ADC0_3: V178.1, V180.1
ADCTRIG1: V160.1
CLK2-MMC_CLK: V330.1, V335.1
GND: V1.1, V2.1, V3.1, V4.1, V5.1, V6.1, V7.1, V8.1, V9.1, V10.1, V11.1, V12.1, V13.1, V14.1, V15.1, V16.1, V17.1, V18.1, V19.1, V20.1, V21.1, V22.1, V23.1, V24.1, V25.1, V26.1, V27.1, V28.1, V29.1, V30.1, V31.1, V32.1, V33.1, V34.1, V35.1, V36.1, V37.1, V38.1, V39.1, V40.1, V41.1, V42.1, V43.1, V44.1, V45.1, V46.1, V47.1, V48.1, V49.1, V50.1, V51.1, V52.1, V53.1, V54.1, V55.1, V56.1, V57.1, V58.1, V59.1, V60.1, V61.1, V62.1, V63.1, V64.1, V65.1, V66.1, V67.1, V68.1, V69.1, V70.1, V71.1, V72.1, V73.1, V74.1, V75.1, V76.1, V77.1, V94.1, V95.1, V96.1, V97.1, V99.1, V102.1, V127.1, V134.1, V135.1, V136.1, V137.1, V138.1, V140.1, V141.1, V161.1, V162.1, V163.1, V164.1, V165.1, V166.1, V167.1, V168.1, V169.1, V170.1, V171.1, V172.1, V173.1, V174.1, V175.1, V176.1, V205.1, V206.1, V207.1, V208.1, V209.1, V210.1, V211.1, V212.1, V214.1, V215.1, V216.1, V217.1, V218.1, V219.1, V220.1, V221.1, V237.1, V238.1, V239.1, V240.1, V241.1, V242.1, V243.1, V244.1, V245.1, V246.1, V247.1, V248.1, V249.1, V250.1, V251.1, V252.1, V253.1, V254.1, V310.1, V312.1, V316.1, V317.1, V319.1, V320.1, V321.1, V341.1
GNDPWR: V300.1, V301.1, V302.1, V303.1
GPS_FIX: V228.1, V230.1
I2C0_SCL: V125.1, V187.1
I2C0_SDA: V124.1, V188.1
LCD_DATA: V269.1, V270.1
LCD_LEDA: V229.1, V233.1, V333.1
LCD_X+: V149.1
LCD_X-: V150.1
LCD_Y+: V151.1
LCD_Y-: V152.1
LTC3559_EN1: V98.1, V101.1
LTC3559_EN2: V100.1, V119.1
LTC3559_NTC: V108.1
P1_0-SSP0_SSEL: V78.1, V79.1, V222.1
P1_1-SSP0_MISO: V84.1, V85.1
P1_2-SSP0_MOSI: V82.1, V83.1
P1_6-MMC_CMD: V325.1, V334.1
P1_8-MMC_ENABLE: V314.1, V344.1
P1_9-MMC_DAT0: V326.1, V337.1
P1_10-MMC_DAT1: V315.1, V338.1
P1_11-MMC_DAT2: V327.1, V339.1
P1_12-MMC_DAT3: V329.1, V340.1
P1_13-MMC_CD: V328.1, V336.1
P1_14-GPIO1_7: V311.1
P1_15-GPIO0_2: V232.1, V313.1
P1_19-SSP1_SCK: V308.1
P1_20-SSP1_SSEL: V236.1
P2_0-U0_TXD: V227.1, V305.1, V332.1, V346.1
P2_1-U0_RXD: V226.1, V304.1, V331.1, V345.1
P2_3-I2C1_SDA: V262.1, V264.1, V266.1
P2_4-I2C1_SCL: V261.1, V263.1, V265.1, V318.1
P2_7-GPIO0_7-ISP: V92.1, V323.1, V324.1
P2_8-GPIO5_7-BOOT: V93.1, V185.1, V186.1, V322.1
P2_10-GPIO0_14: V88.1, V89.1
P2_11-GPIO1_11: V90.1, V271.1
P2_12-GPIO1_12: V86.1, V87.1, V158.1
P2_13-GPIO1_13: V159.1, V260.1
P3_0-SSP0_SCK: V80.1, V81.1
P3_3-SPIFI_SCK: V194.1, V259.1
P3_4-SPIFI_SIO3: V193.1, V235.1
P3_5-SPIFI_SIO2: V257.1, V378.1
P3_6-SPIFI_MISO: V190.1, V258.1
P3_7-SPIFI_MOSI: V191.1, V255.1
P3_8-SPIFI_CS: V189.1, V256.1
P6_2-GPIO3_1: V309.1
P6_11-GPIO3_7: V91.1, V234.1, V306.1
RTC_ALARM: V195.1
TDI: V103.1
TMS: V199.1
VBUS: V196.1, V197.1
VDDIO_3V3: V128.1, V129.1, V142.1, V143.1, V181.1, V182.1, V200.1, V201.1, V202.1, V203.1, V204.1, V307.1
VDD_3V3: V122.1, V123.1, V126.1, V130.1, V131.1, V132.1, V133.1, V139.1, V144.1, V145.1, V153.1, V154.1, V183.1, V184.1
VDD_MOT: V120.1, V121.1
VDD_RF: V111.1, V112.1, V113.1, V114.1, V115.1, V116.1, V117.1, V118.1, V223.1, V224.1
WAKEUP0: V147.1, V148.1
WAKEUP_Movement: V109.1, V157.1
WAKEUP_Touchscreen: V155.1, V156.1, V225.1
nRESET: V146.1, V267.1, V268.1
nTRST: V198.1
