prabhakar06447/micropendousx/MicropendousX/Hardware/MicropendousX-LPC182x/MicropendousX-LPC182x-Expansion.sch

## KiCad design MicropendousX/Hardware/MicropendousX-LPC182x/MicropendousX-LPC182x-Expansion.sch (2012-07-02)

Schematic: MicropendousX-LPC182x-Expansion.sch

Parts:
IC1: LPC182x
P1, P2: CONN_18
P3: CONN_8
TP3: ISP
TP4: ADC0_3
TP5: P1_15

Notes on the sheet:
P2_7 has weak internal pull-up to disable ISP
