prabhakar06447/micropendousx/MicropendousX/Hardware/MicropendousX-LPC182x/MicropendousX-LPC182x-Power.sch

## KiCad design MicropendousX/Hardware/MicropendousX-LPC182x/MicropendousX-LPC182x-Power.sch (2012-07-02)

Schematic: MicropendousX-LPC182x-Power.sch

Parts:
C17, C34, C66: 1u0
C21, C24, C37, C50, C64, C75: 0u1
C27, C29, C65: 4u7
C107: u01
D1, D2: MBR120
IC1: LPC182x
IC2: AP7361
L1, L3: FB
R11: 135k
R12: 43k
R48: 12k

Notes on the sheet:
For a desired output, need an R11 value of:
R11 = 43k((VOut / 0.8) - 1)
Notes: - Boot pins have weak internal pull-ups of about 50k Ohm to VDDIO so VDDIO_3V3 must be enabled at the same time as VDD_3V3 at startup - regulator outputs 3.3V nominal but lowering the voltage to 3.0V will reduce power consumption and be within all components' supply margins - use low ESL rev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
VBAT must be < 3.6V
