prabhakar06447/micropendousx/MicropendousX/Hardware/MicropendousX-LPC182x/MicropendousX-LPC182x-System.sch

## KiCad design MicropendousX/Hardware/MicropendousX-LPC182x/MicropendousX-LPC182x-System.sch (2012-07-02)

Schematic: MicropendousX-LPC182x-System.sch

Parts:
C1, C2, C3, C4: 10pF
C5: u01
C8, C108: 0u1
IC1: LPC182x
IC7: 25Q
R10, R36: 47k
R37, R39, R44: 10k
R50: 100
TP1: nTRST
TP2: DBGEN
U4: JTAG
X1: 12MHz
X2: 32.768kHz

Notes on the sheet:
P2_8 is exposed to external application.
DBGEN selects between ARM and boundary scan with ARM as default
(SPF)
(USB)
JTAG
Maximum 16MBit per Errata R1.3 SPIFI.2
Notes: - Run core system on always-on VDD_3V3 - Internal Rpu is minimum 45k Ohm, so for boot selection pull-down resistor, 19k is max. usable as 3.3(19/(19+45))=0.98V < Vil=(3.3*.3)=1V
TDO need not be pulled up since TCK pull-down ensures no random data is ever sent as TDO is only valid when clock is valid.
Note boot pins have weak internal pull-ups of about 50k Ohm to VDDIO
nTRST, TMS, and TDI have weak internal pull-up resistors
WAKEUP has internal weak pull-up so use it Active-Low
LOW
HIGH
USART3
Taken from LPC18x0 Datasheet - Table 5
EMC 32-Bit
USB0
SPI (SSP)
USB1
EMC 8-Bit
EMC 16-Bit
SPIFI
USART0
P1_2(A7)
P1_1(A6)
P2_8(A8)
P2_9(A0)
Boot Mode
Boot Mode Selection
This is equivalent to nSRST
Power-up Reset is not reliable with fast VDD ramps so a Reset delay is required (Errata 20110701 POR.1)
