prabhakar06447/micropendousx/MicropendousX/Hardware/MicropendousX-LPC182x/MicropendousX-LPC182x-Vias.sch

## KiCad design MicropendousX/Hardware/MicropendousX-LPC182x/MicropendousX-LPC182x-Vias.sch (2012-07-02)

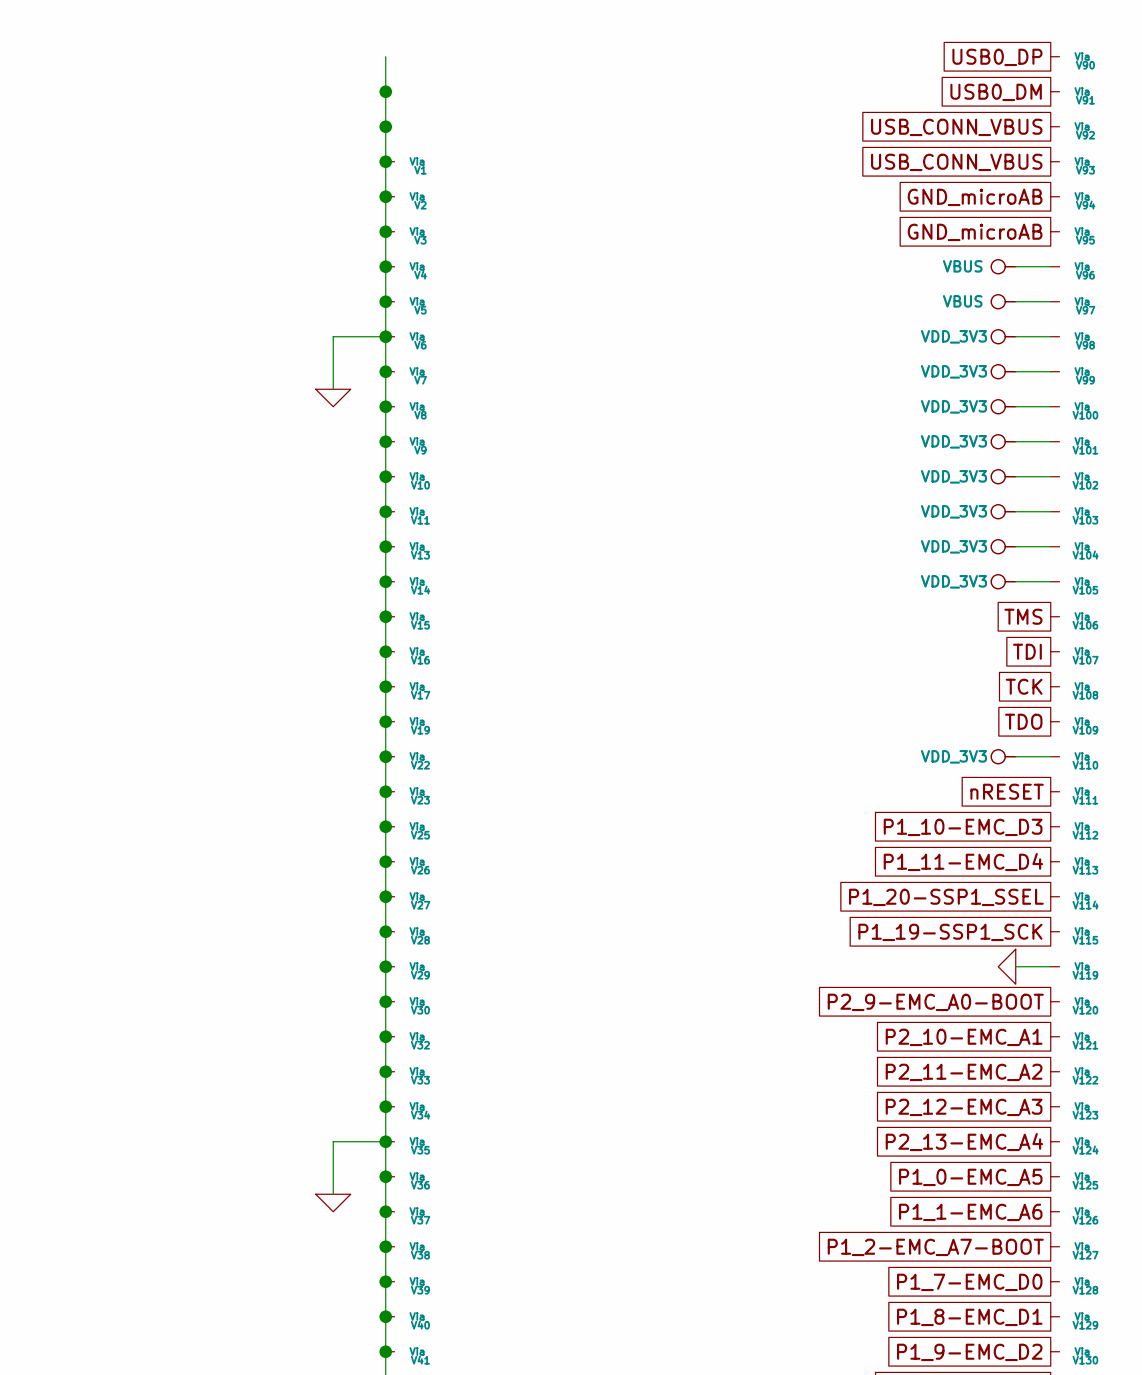
[picture p63: schematic MicropendousX-LPC182x-Vias.sch, part in row 1, column 1]

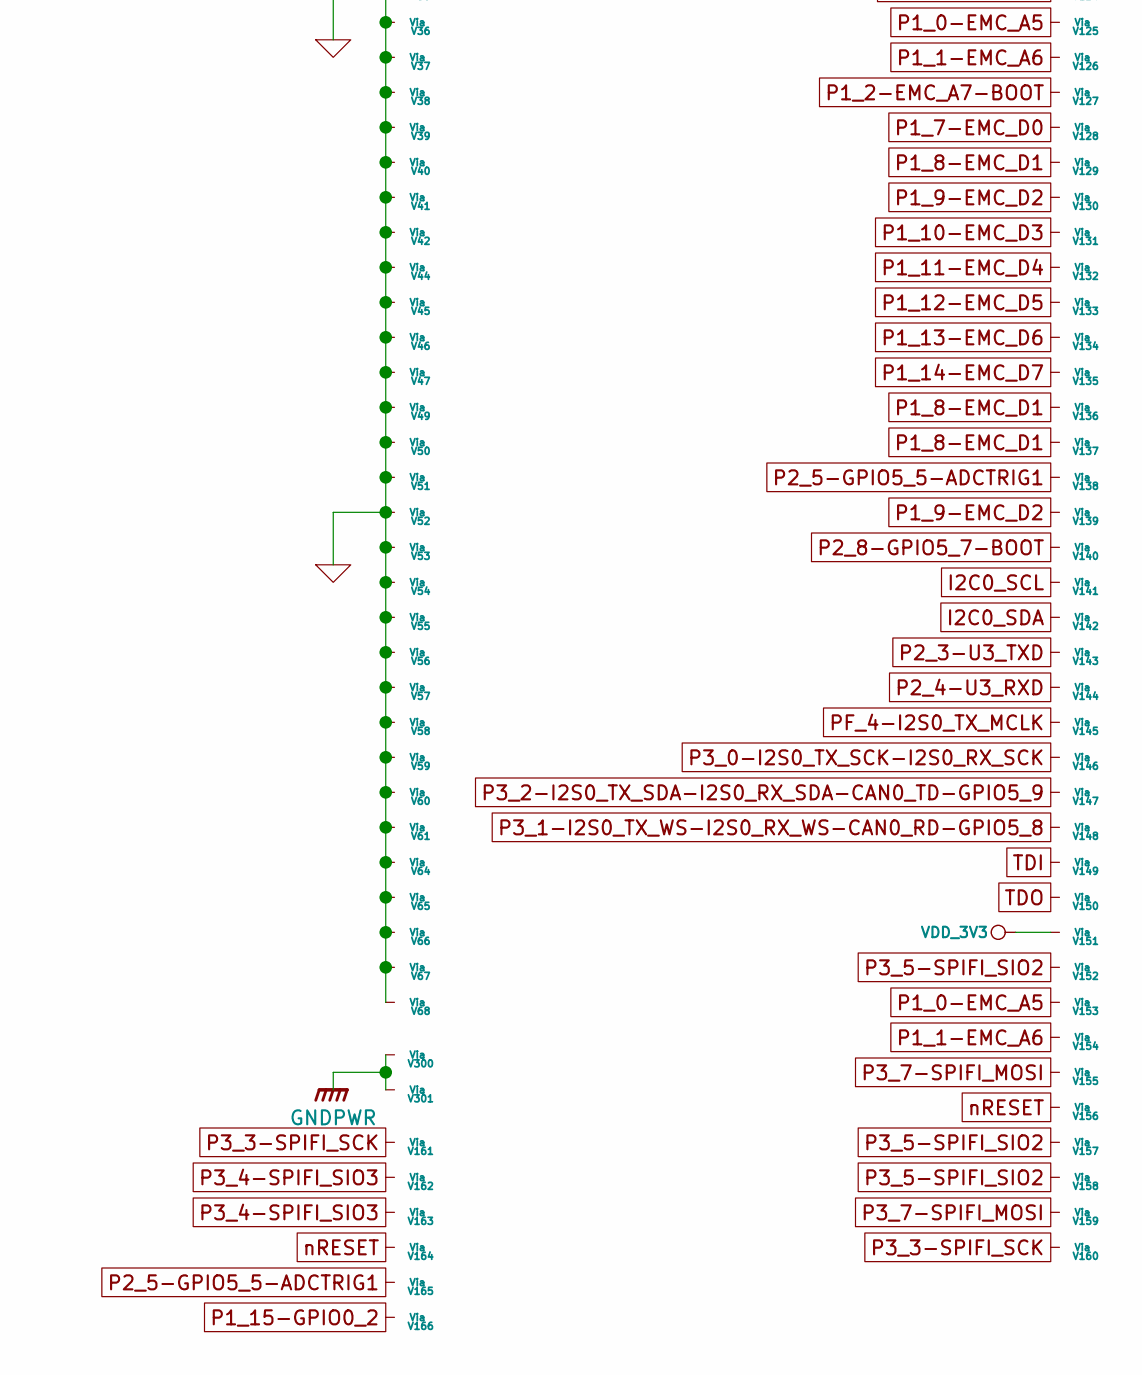
[picture p64: schematic MicropendousX-LPC182x-Vias.sch, part in row 2, column 1]

Parts:
V1, V2, V3, V4, V5, V6, V7, V8, V9, V10, V11, V13, V14, V15, V16, V17, V19, V22, V23, V25, V26, V27, V28, V29, V30, V32, V33, V34, V35, V36, V37, V38, V39, V40, V41, V42, V44, V45, V46, V47, V49, V50, V51, V52, V53, V54, V55, V56, V57, V58, V59, V60, V61, V64, V65, V66, V67, V68, V90, V91, V92, V93, V94, V95, V96, V97, V98, V99, V100, V101, V102, V103, V104, V105, V106, V107, V108, V109, V110, V111, V112, V113, V114, V115, V119, V120, V121, V122, V123, V124, V125, V126, V127, V128, V129, V130, V131, V132, V133, V134, V135, V136, V137, V138, V139, V140, V141, V142, V143, V144, V145, V146, V147, V148, V149, V150, V151, V152, V153, V154, V155, V156, V157, V158, V159, V160, V161, V162, V163, V164, V165, V166, V300, V301: VIA

Connections:
GND: V1.1, V2.1, V3.1, V4.1, V5.1, V6.1, V7.1, V8.1, V9.1, V10.1, V11.1, V13.1, V14.1, V15.1, V16.1, V17.1, V19.1, V22.1, V23.1, V25.1, V26.1, V27.1, V28.1, V29.1, V30.1, V32.1, V33.1, V34.1, V35.1, V36.1, V37.1, V38.1, V39.1, V40.1, V41.1, V42.1, V44.1, V45.1, V46.1, V47.1, V49.1, V50.1, V51.1, V52.1, V53.1, V54.1, V55.1, V56.1, V57.1, V58.1, V59.1, V60.1, V61.1, V64.1, V65.1, V66.1, V67.1, V68.1, V119.1
GNDPWR: V300.1, V301.1
GND_microAB: V94.1, V95.1
I2C0_SCL: V141.1
I2C0_SDA: V142.1
P1_0-EMC_A5: V125.1, V153.1
P1_1-EMC_A6: V126.1, V154.1
P1_2-EMC_A7-BOOT: V127.1
P1_7-EMC_D0: V128.1
P1_8-EMC_D1: V129.1, V136.1, V137.1
P1_9-EMC_D2: V130.1, V139.1
P1_10-EMC_D3: V112.1, V131.1
P1_11-EMC_D4: V113.1, V132.1
P1_12-EMC_D5: V133.1
P1_13-EMC_D6: V134.1
P1_14-EMC_D7: V135.1
P1_15-GPIO0_2: V166.1
P1_19-SSP1_SCK: V115.1
P1_20-SSP1_SSEL: V114.1
P2_3-U3_TXD: V143.1
P2_4-U3_RXD: V144.1
P2_5-GPIO5_5-ADCTRIG1: V138.1, V165.1
P2_8-GPIO5_7-BOOT: V140.1
P2_9-EMC_A0-BOOT: V120.1
P2_10-EMC_A1: V121.1
P2_11-EMC_A2: V122.1
P2_12-EMC_A3: V123.1
P2_13-EMC_A4: V124.1
P3_0-I2S0_TX_SCK-I2S0_RX_SCK: V146.1
P3_1-I2S0_TX_WS-I2S0_RX_WS-CAN0_RD-GPIO5_8: V148.1
P3_2-I2S0_TX_SDA-I2S0_RX_SDA-CAN0_TD-GPIO5_9: V147.1
P3_3-SPIFI_SCK: V160.1, V161.1
P3_4-SPIFI_SIO3: V162.1, V163.1
P3_5-SPIFI_SIO2: V152.1, V157.1, V158.1
P3_7-SPIFI_MOSI: V155.1, V159.1
PF_4-I2S0_TX_MCLK: V145.1
TCK: V108.1
TDI: V107.1, V149.1
TDO: V109.1, V150.1
TMS: V106.1
USB0_DM: V91.1
USB0_DP: V90.1
USB_CONN_VBUS: V92.1, V93.1
VBUS: V96.1, V97.1
VDD_3V3: V98.1, V99.1, V100.1, V101.1, V102.1, V103.1, V104.1, V105.1, V110.1, V151.1
nRESET: V111.1, V156.1, V164.1
