prabhakar06447/micropendousx/MicropendousX/Hardware/MicropendousX-LPC183x/MicropendousX-LPC183x-EMI.sch

## KiCad design MicropendousX/Hardware/MicropendousX-LPC183x/MicropendousX-LPC183x-EMI.sch (2011-11-04)

Schematic: MicropendousX-LPC183x-EMI.sch

Parts:
C116, C119: 0u1
C117: 470p
C118: 10u
C120: u01
IC1: LPC183X
IC5: FDC6331
R51: 199k
R52: 10k
U11: MMC

Notes on the sheet:
SC70-6 Load Switches: Si1865DL, Si1869DH, FDG6342L
From Sheet 2 - Opennect Connector
Used in Sheet 2 - Opennect Connector
Notes: - when using the EMC block of the LPC18xx the core clock must be set max 120MHz for compatibility (Errata 20110701 EMC.1)
Si3865BDV
