prabhakar06447/micropendousx/MicropendousX/Hardware/MicropendousX-LPC183x/MicropendousX-LPC183x-Opennect_Connector.sch

## KiCad design MicropendousX/Hardware/MicropendousX-LPC183x/MicropendousX-LPC183x-Opennect_Connector.sch (2011-11-03)

Schematic: MicropendousX-LPC183x-Opennect_Connector.sch

Parts:
C6, C44, C106: 0u1
C7: u01
C12, C15, C16, C20, C43: 4u7
C103, C104, C105: 1u0
D4: MBR120
IC1: LPC183X
IC3: 74CBTLV3257
IC4: 3157
IC8, IC9: AP7361
J1: DC_IN
L4: FB
R7, R8: 10k
R23, R25: 249k
R24, R26: 47k
R54, R55, R56, R57: 2k2
U2: Opennect-Analog-ADC_3V3-x2
U9: Opennect-Controller-SingleEnded-x4

Notes on the sheet:
SPIFI_SCK pin from Sheet 5 - System
Full compatibility with the Opennect Specification requires running the system from DC Power. D4 enables system 3V3 rail to partially power Opennect Connector when running off Li-Ion or USB to allow use of Opennect Modules that only require 3.3V rail.
10<ESR(mOhm)<300
ENET_MDC
ENET_RXD1
ENET_REF_CLK
ENET_TX_EN
ENET_TXD1
ENET_RXD0
ENET_RX_DV
ENET_TXD0
ENET_MDIO
SN74LVC1G
SN74LVC1G3157 is a bidirectional analog switch
Notes: - When GPIO3_5 is set to High (default), pins are routed for compatibility with Opennect-Controller-I2S. When it is set to Low pins are routed for compatibility with Opennect-Controller-SingleEnded-x4 Specification. - I2S0 used for TX and I2S1 used for RX
MMC_CLK used in Sheet 1 - EMI
RX_SCK
Used in Sheet 6 - Power Supply
SPIFIx pins from Sheet 5 - System
TX_SCK
RX_WS
RX_SDA
TX_SDA
TX_WS
Opennect-Analog-DAC_3V3-x1
Opennect-Controller-I2S_3V3-PWR_8W
