prabhakar06447/micropendousx/MicropendousX/Hardware/MicropendousX-LPC183x/MicropendousX-LPC183x-Power.sch

## KiCad design MicropendousX/Hardware/MicropendousX-LPC183x/MicropendousX-LPC183x-Power.sch (2011-11-03)

Schematic: MicropendousX-LPC183x-Power.sch

Parts:
BAT1: Li-Ion
C9, C18, C22, C51: 1u0
C10: u22
C11, C17: 4u7
C13, C24, C27, C29, C34, C54, C55: 10u
C14, C19, C64, C109, C112, C113, C114: 0u1
C21, C36, C50: 33n
C26: 2u2
C30, C32: 22p
C37: 1n0
C107: u01
C115: 1u
D1: CHRG
D5: PMEG3020EH
IC1: LPC183X
IC2: STC3100
IC6: LTC3559
L1, L3: FB
L2: DNI
L5, L6: 4.7uH
Q1: Si2312
Q2: FDN304
R3: 0R03
R4, R12, R15: 1k
R6: 200k
R9, R13, R20: 10k
R10: 1k2
R11: 1k65
R14: 1k74
R16, R18: 806k
R17, R19: 261k
R21: 0R5
R48: 12k1
TP5: VBAT
TP6: STC_IO0

Notes on the sheet:
DNI
DC Power Jack Support
From Sheet 1 - EMI
Use Rectifier with >500mOhm Vdrop for D1 as LTC3559 has maximum Vcc of 5.5V. PMEG3020EH, SMD26PL, MBRX160
From Sheet 2 - Opennect Connector
R14 = 1.74k limits USB charge current to 500mA
Li-Ion Charger, Guage, and Dual Buck Regulators
Power Management
0805
0.1%
1206
