prabhakar06447/micropendousx/MicropendousX/Hardware/MicropendousX-LPC183x/MicropendousX-LPC183x-System.sch

## KiCad design MicropendousX/Hardware/MicropendousX-LPC183x/MicropendousX-LPC183x-System.sch (2011-11-03)

Schematic: MicropendousX-LPC183x-System.sch

Parts:
C1, C2, C3, C4: 10pF
C5: u01
C8, C108: 0u1
IC1: LPC183X
IC7: 25Q
JP0, JP6, JP7, JP8: JUMPER-3
R5, R36, R37, R39, R40, R41, R42, R43, R44, R45, R46, R47: 10k
R22: 199k
R50: 100
SW1: RESET
TP1: nTRST
TP2: DBGEN
TP3: NMI
TP4: RTC_ALARM
TP7: WAKEUP0
U4: JTAG
X1: 12MHz
X2: 32.768kHz

Notes on the sheet:
LOW
HIGH
USART3
Taken from 2011-08-22 LPC18x0 Datasheet - Table 5
EMC 32-Bit
USB0
SPI (SSP)
USB1
EMC 8-Bit
EMC 16-Bit
SPIFI
USART0
P1_2(A7)
P1_1(A6)
P2_8(A8)
P2_9(A0)
Boot Mode
Boot Mode Selection
SOICW
This is equivalent to nSRST
Power-up Reset is not reliable with fast VDD ramps so a Reset delay is required (Errata 20110701 POR.1)
