prabhakar06447/micropendousx/MicropendousX/Hardware/MicropendousX-LPC183x/MicropendousX-LPC183x-USB.sch

## KiCad design MicropendousX/Hardware/MicropendousX-LPC183x/MicropendousX-LPC183x-USB.sch (2011-11-03)

Schematic: MicropendousX-LPC183x-USB.sch

Parts:
CR1, CR2, CR5: ESD
F1: 750mA
IC1: LPC183X
L10: FBX
L11: FBY
R1, R2: 0
U1: USB-microAB

Notes on the sheet:
Notes: - USB VBUS Fuse F1 limits inrush current - FBX ferrite bead is high DCR 0805 - FBY ferrite beads are high current 0805 - all other FB are 1A 0603, moderate DCR
High DCR
To Host
