prabhakar06447/micropendousx/MicropendousX/Hardware/MicropendousX-LPC183x/MicropendousX-LPC183x-Vias.sch

## KiCad design MicropendousX/Hardware/MicropendousX-LPC183x/MicropendousX-LPC183x-Vias.sch (2011-11-03)

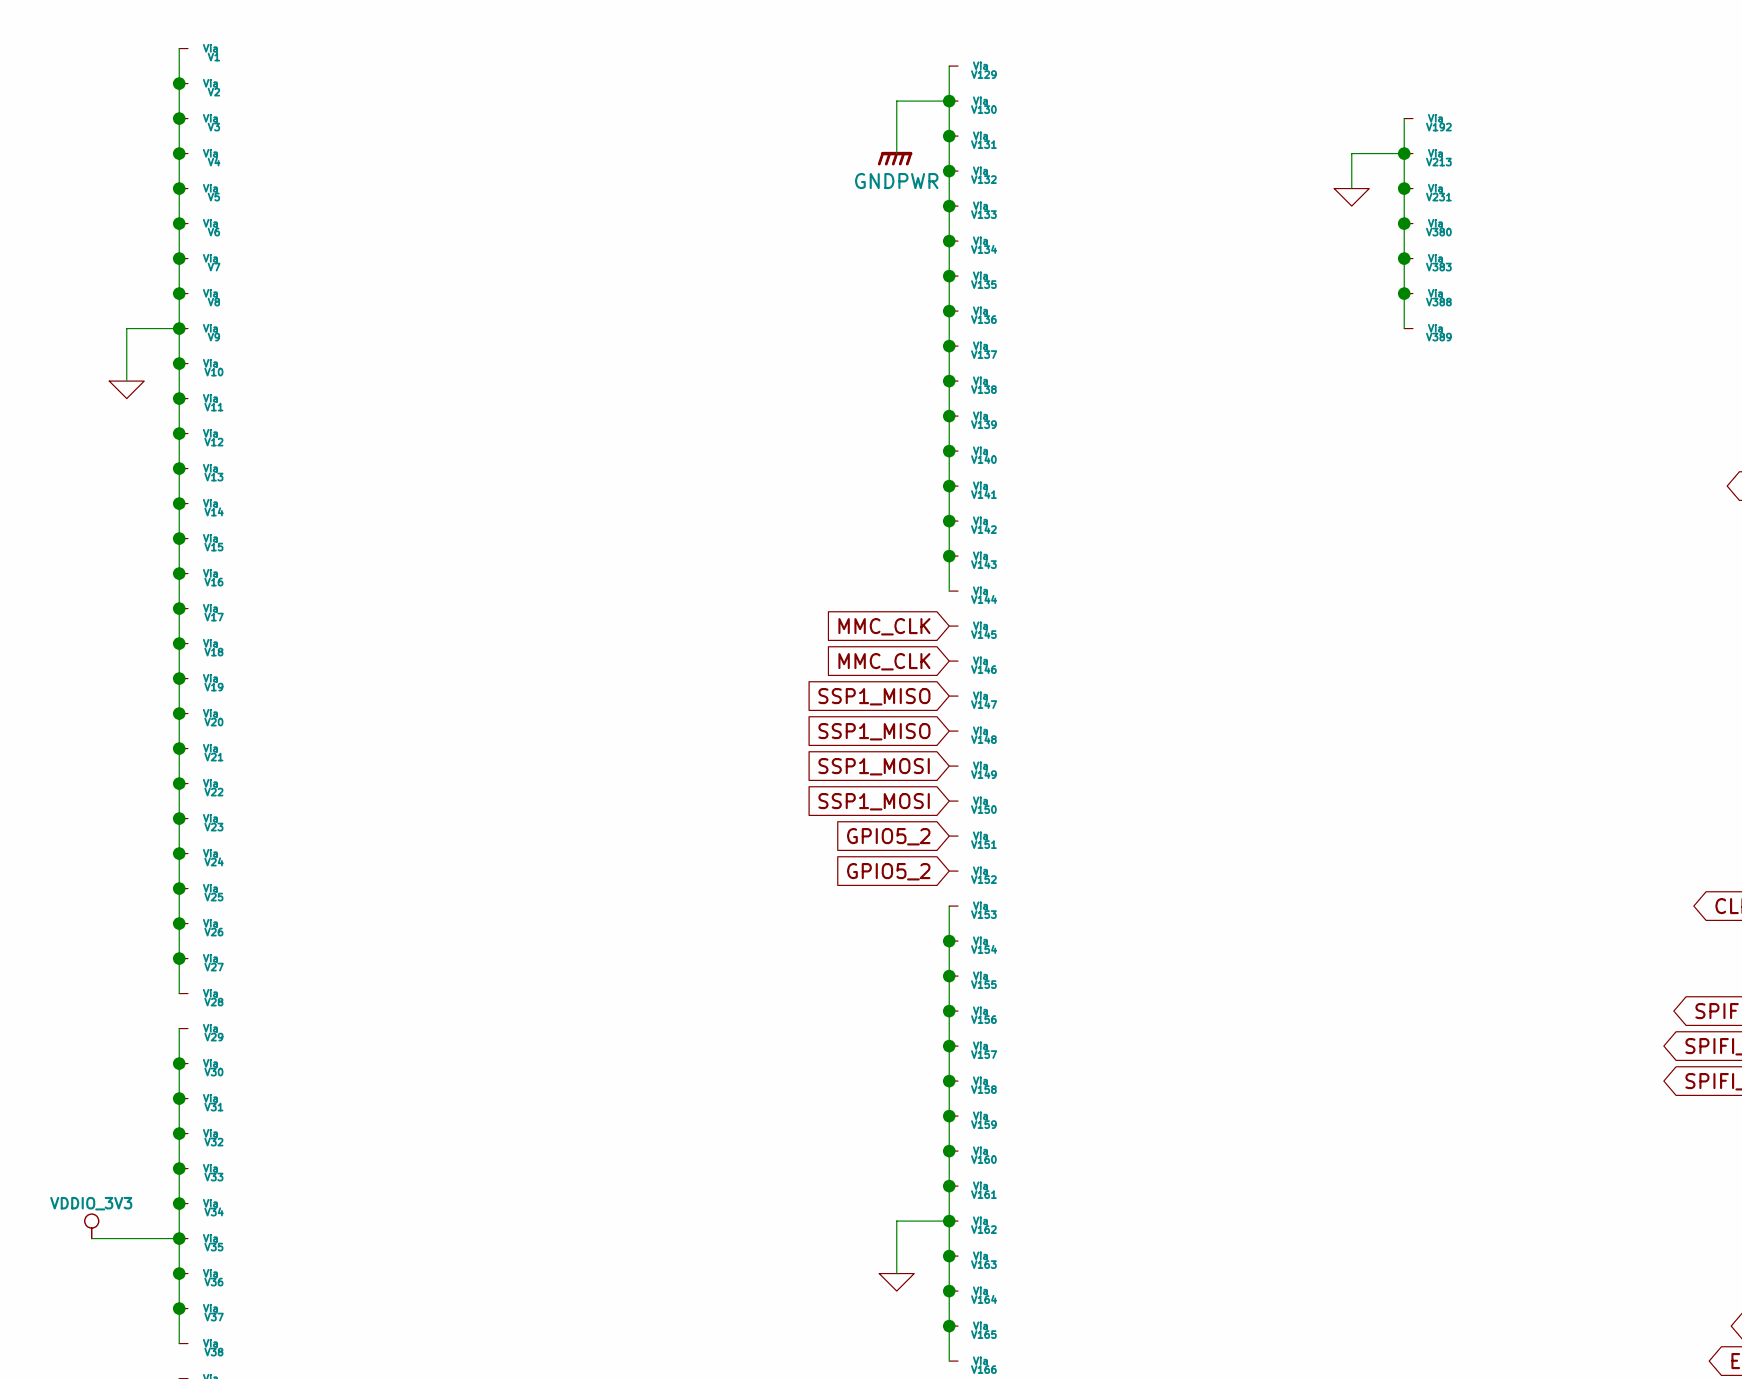
[picture p65: schematic MicropendousX-LPC183x-Vias.sch, part in row 1, column 1]

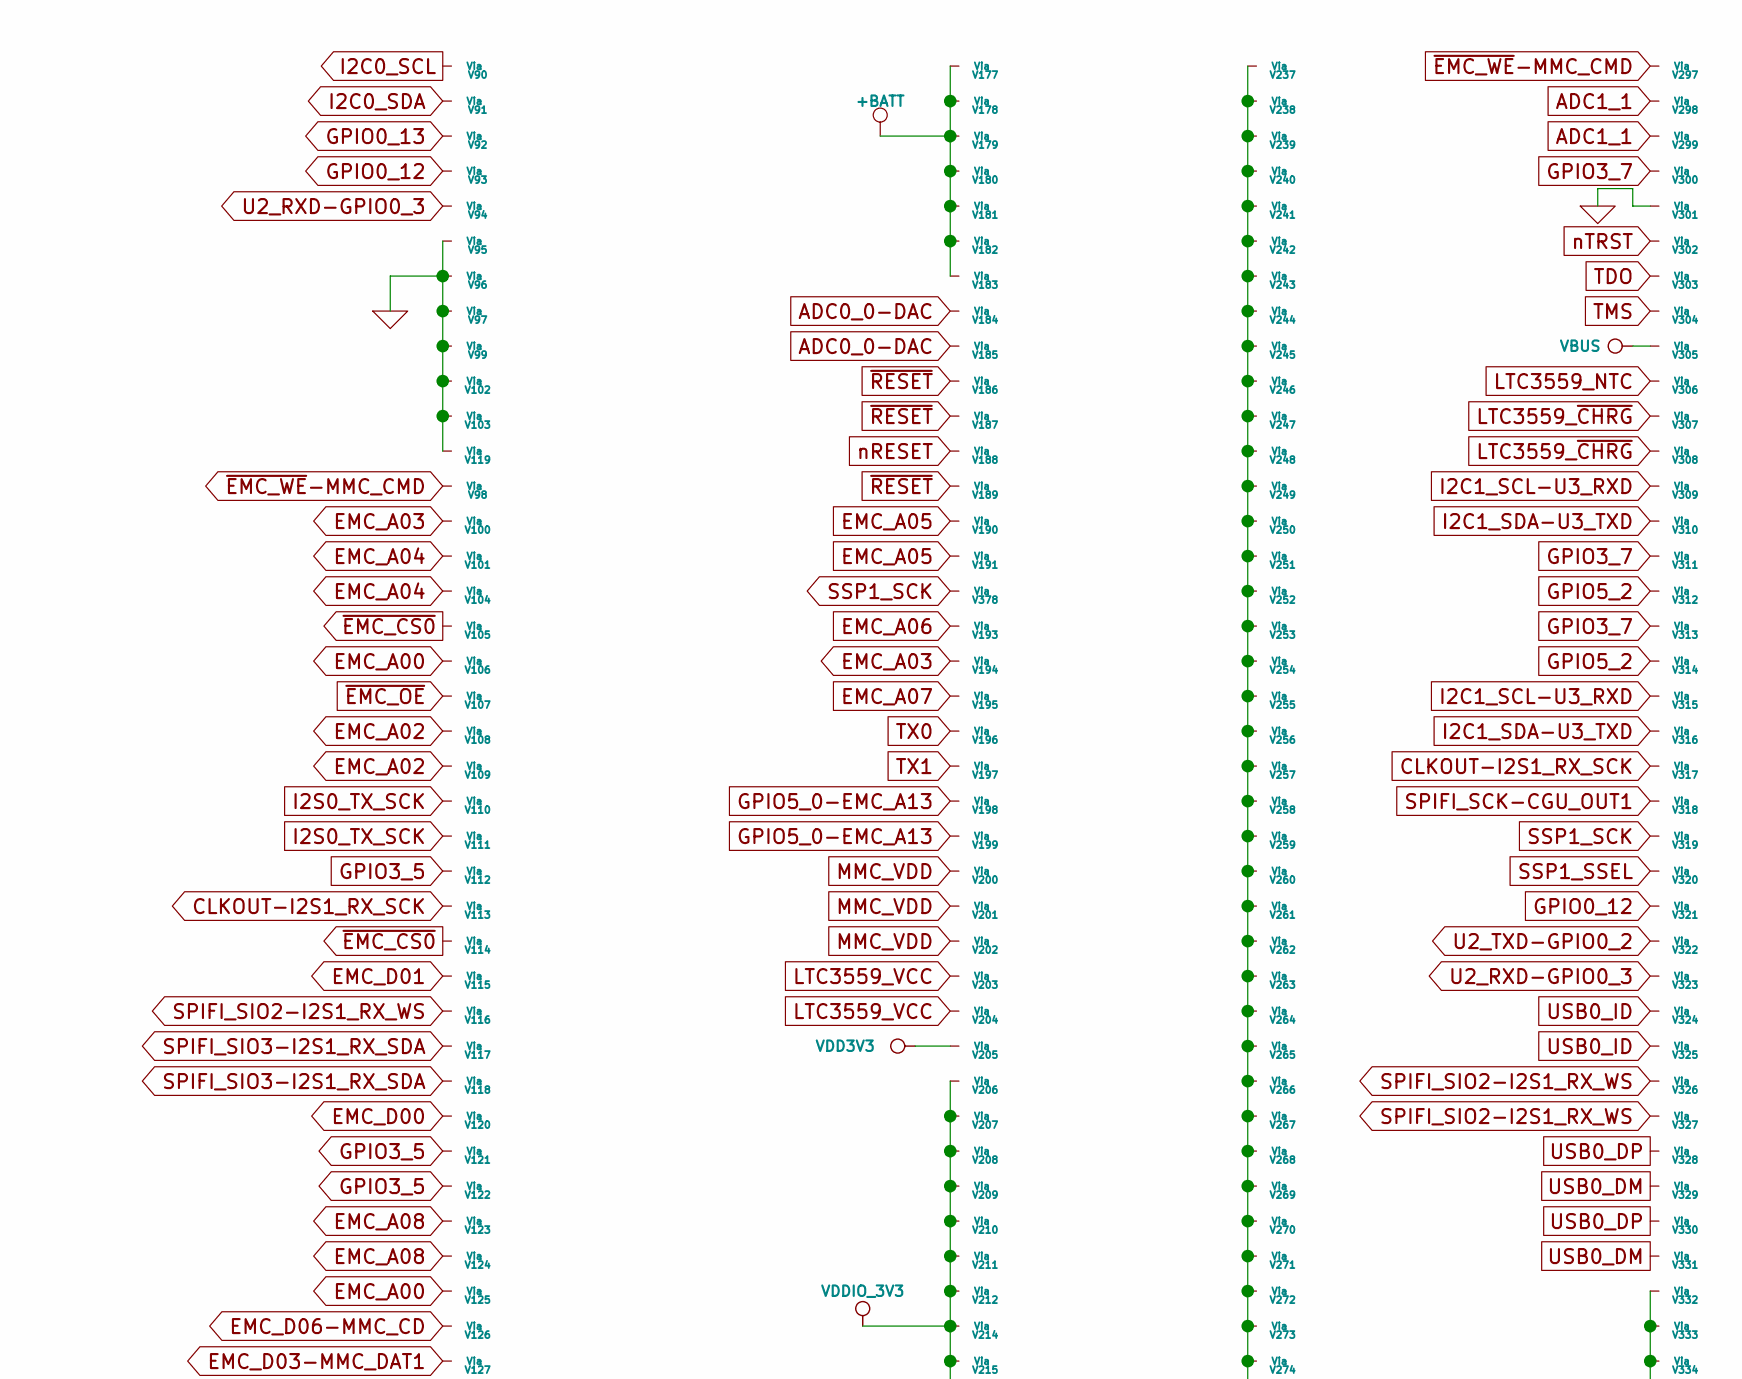
[picture p66: schematic MicropendousX-LPC183x-Vias.sch, part in row 1, column 2]

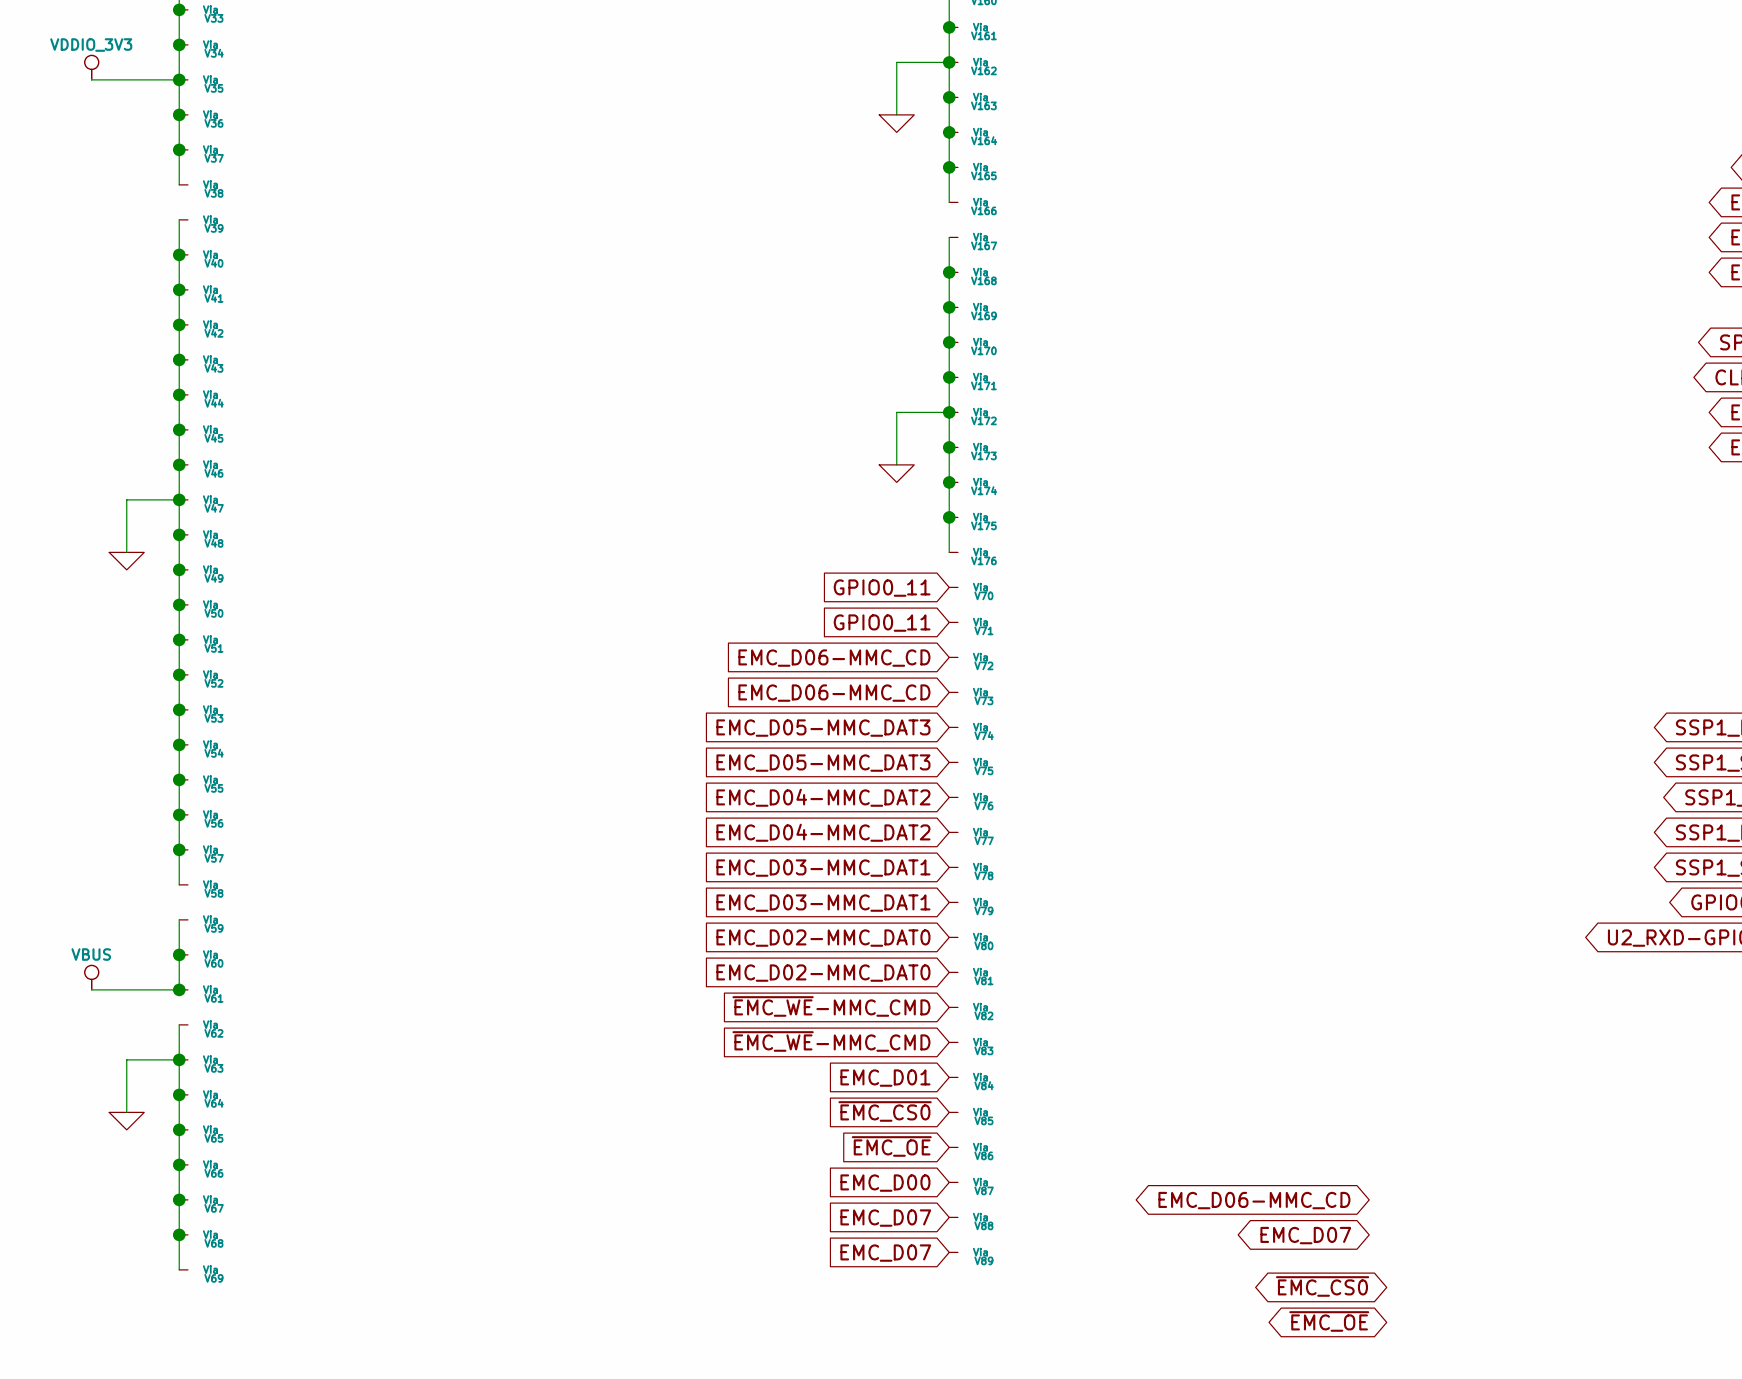
[picture p67: schematic MicropendousX-LPC183x-Vias.sch, part in row 2, column 1]

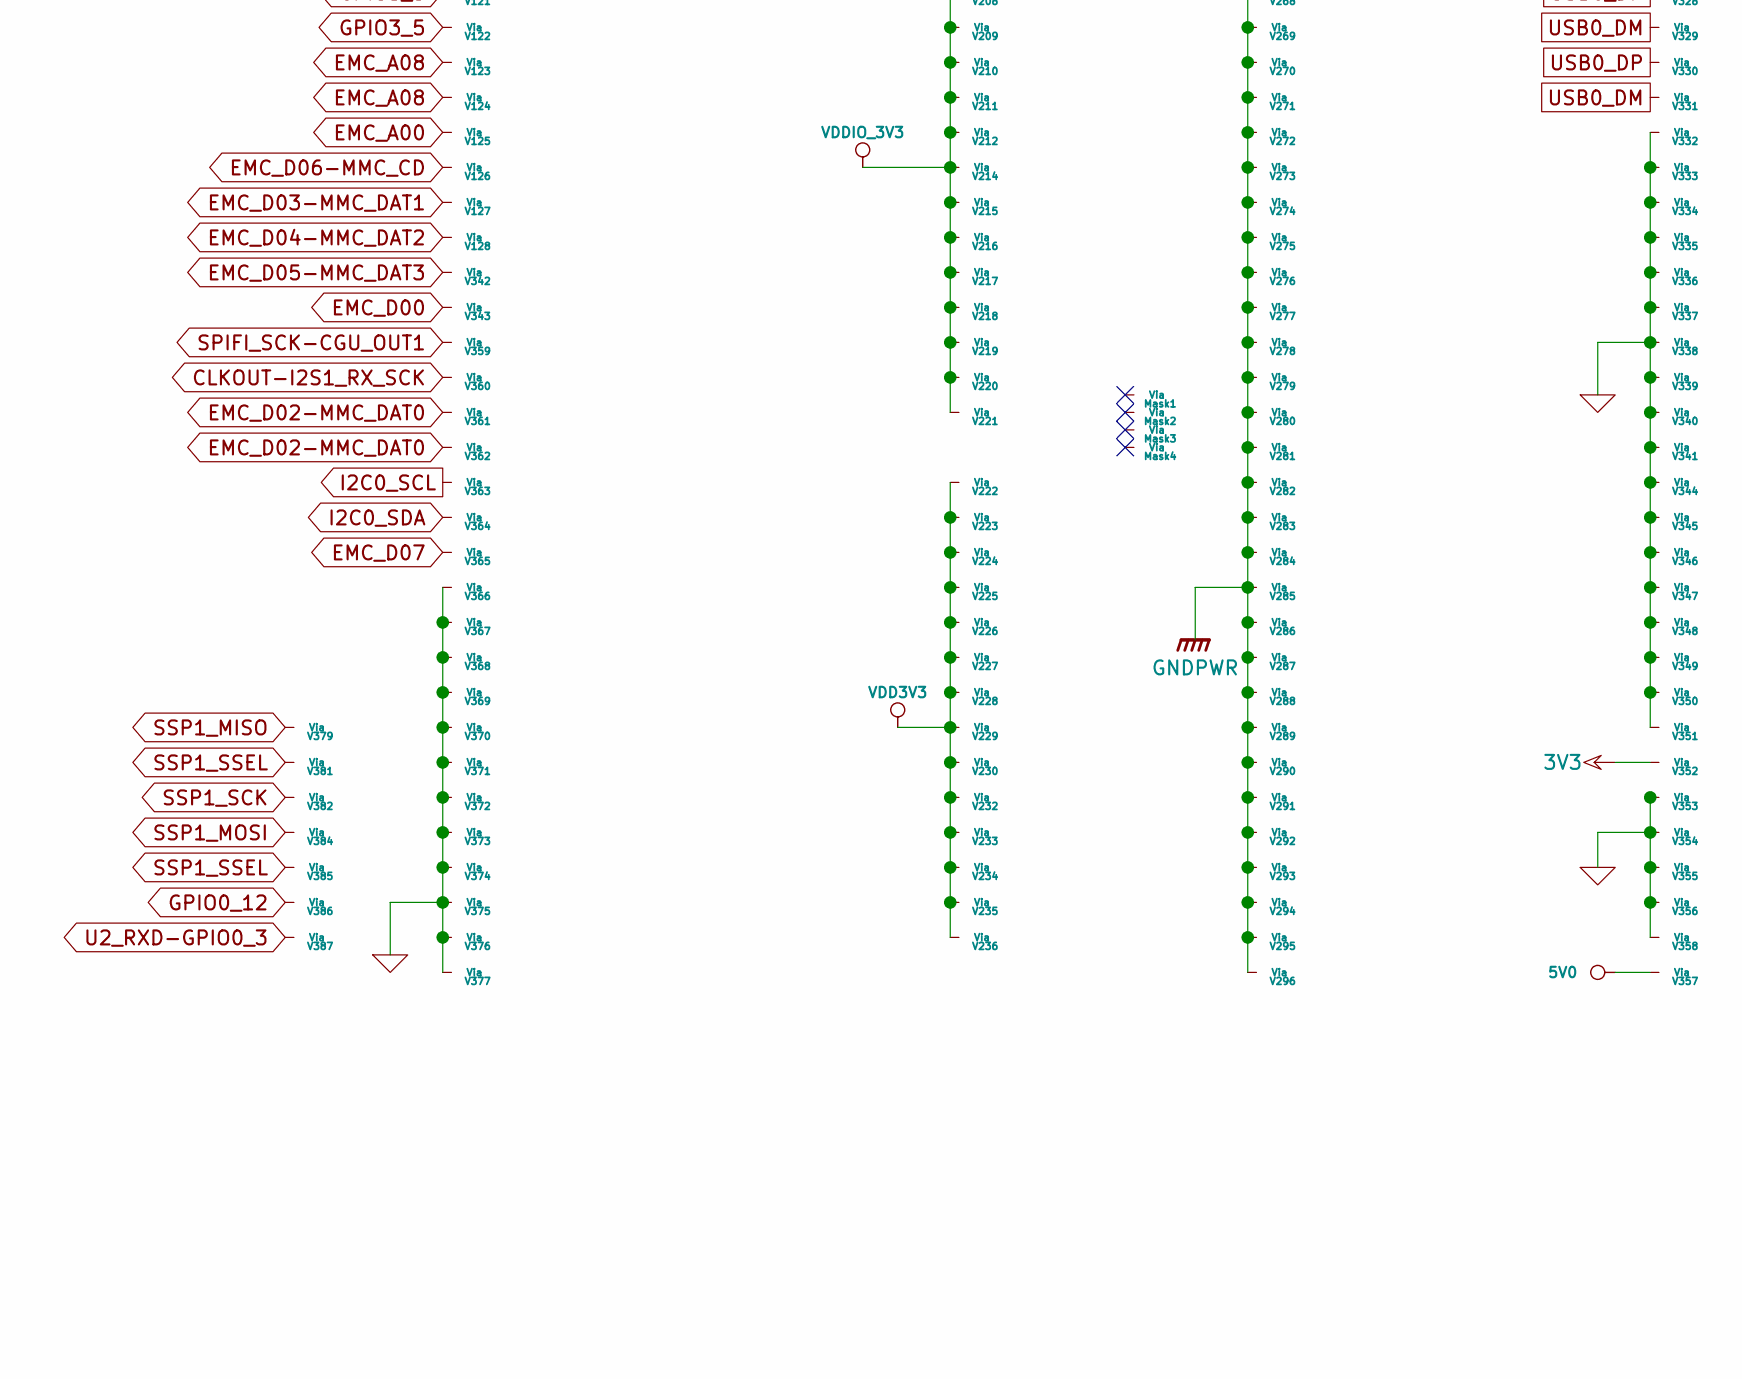
[picture p68: schematic MicropendousX-LPC183x-Vias.sch, part in row 2, column 2]

Parts:
Mask1, Mask2, Mask3, Mask4: Mask
V1, V2, V3, V4, V5, V6, V7, V8, V9, V10, V11, V12, V13, V14, V15, V16, V17, V18, V19, V20, V21, V22, V23, V24, V25, V26, V27, V28, V29, V30, V31, V32, V33, V34, V35, V36, V37, V38, V39, V40, V41, V42, V43, V44, V45, V46, V47, V48, V49, V50, V51, V52, V53, V54, V55, V56, V57, V58, V59, V60, V61, V62, V63, V64, V65, V66, V67, V68, V69, V70, V71, V72, V73, V74, V75, V76, V77, V78, V79, V80, V81, V82, V83, V84, V85, V86, V87, V88, V89, V90, V91, V92, V93, V94, V95, V96, V97, V98, V99, V100, V101, V102, V103, V104, V105, V106, V107, V108, V109, V110, V111, V112, V113, V114, V115, V116, V117, V118, V119, V120, V121, V122, V123, V124, V125, V126, V127, V128, V129, V130, V131, V132, V133, V134, V135, V136, V137, V138, V139, V140, V141, V142, V143, V144, V145, V146, V147, V148, V149, V150, V151, V152, V153, V154, V155, V156, V157, V158, V159, V160, V161, V162, V163, V164, V165, V166, V167, V168, V169, V170, V171, V172, V173, V174, V175, V176, V177, V178, V179, V180, V181, V182, V183, V184, V185, V186, V187, V188, V189, V190, V191, V192, V193, V194, V195, V196, V197, V198, V199, V200, V201, V202, V203, V204, V205, V206, V207, V208, V209, V210, V211, V212, V213, V214, V215, V216, V217, V218, V219, V220, V221, V222, V223, V224, V225, V226, V227, V228, V229, V230, V231, V232, V233, V234, V235, V236, V237, V238, V239, V240, V241, V242, V243, V244, V245, V246, V247, V248, V249, V250, V251, V252, V253, V254, V255, V256, V257, V258, V259, V260, V261, V262, V263, V264, V265, V266, V267, V268, V269, V270, V271, V272, V273, V274, V275, V276, V277, V278, V279, V280, V281, V282, V283, V284, V285, V286, V287, V288, V289, V290, V291, V292, V293, V294, V295, V296, V297, V298, V299, V300, V301, V302, V303, V304, V305, V306, V307, V308, V309, V310, V311, V312, V313, V314, V315, V316, V317, V318, V319, V320, V321, V322, V323, V324, V325, V326, V327, V328, V329, V330, V331, V332, V333, V334, V335, V336, V337, V338, V339, V340, V341, V342, V343, V344, V345, V346, V347, V348, V349, V350, V351, V352, V353, V354, V355, V356, V357, V358, V359, V360, V361, V362, V363, V364, V365, V366, V367, V368, V369, V370, V371, V372, V373, V374, V375, V376, V377, V378, V379, V380, V381, V382, V383, V384, V385, V386, V387, V388, V389: VIA

Connections:
3V3: V352.1
5V0: V357.1
+BATT: V177.1, V178.1, V179.1, V180.1, V181.1, V182.1, V183.1
ADC0_0-DAC: V184.1, V185.1
ADC1_1: V298.1, V299.1
CLKOUT-I2S1_RX_SCK: V113.1, V317.1, V360.1
EMC_A00: V106.1, V125.1
EMC_A02: V108.1, V109.1
EMC_A03: V100.1, V194.1
EMC_A04: V101.1, V104.1
EMC_A05: V190.1, V191.1
EMC_A06: V193.1
EMC_A07: V195.1
EMC_A08: V123.1, V124.1
EMC_D00: V87.1, V120.1, V343.1
EMC_D01: V84.1, V115.1
EMC_D02-MMC_DAT0: V80.1, V81.1, V361.1, V362.1
EMC_D03-MMC_DAT1: V78.1, V79.1, V127.1
EMC_D04-MMC_DAT2: V76.1, V77.1, V128.1
EMC_D05-MMC_DAT3: V74.1, V75.1, V342.1
EMC_D06-MMC_CD: V72.1, V73.1, V126.1
EMC_D07: V88.1, V89.1, V365.1
GND: V1.1, V2.1, V3.1, V4.1, V5.1, V6.1, V7.1, V8.1, V9.1, V10.1, V11.1, V12.1, V13.1, V14.1, V15.1, V16.1, V17.1, V18.1, V19.1, V20.1, V21.1, V22.1, V23.1, V24.1, V25.1, V26.1, V27.1, V28.1, V39.1, V40.1, V41.1, V42.1, V43.1, V44.1, V45.1, V46.1, V47.1, V48.1, V49.1, V50.1, V51.1, V52.1, V53.1, V54.1, V55.1, V56.1, V57.1, V58.1, V62.1, V63.1, V64.1, V65.1, V66.1, V67.1, V68.1, V69.1, V95.1, V96.1, V97.1, V99.1, V102.1, V103.1, V119.1, V153.1, V154.1, V155.1, V156.1, V157.1, V158.1, V159.1, V160.1, V161.1, V162.1, V163.1, V164.1, V165.1, V166.1, V167.1, V168.1, V169.1, V170.1, V171.1, V172.1, V173.1, V174.1, V175.1, V176.1, V192.1, V213.1, V231.1, V301.1, V332.1, V333.1, V334.1, V335.1, V336.1, V337.1, V338.1, V339.1, V340.1, V341.1, V344.1, V345.1, V346.1, V347.1, V348.1, V349.1, V350.1, V351.1, V353.1, V354.1, V355.1, V356.1, V358.1, V366.1, V367.1, V368.1, V369.1, V370.1, V371.1, V372.1, V373.1, V374.1, V375.1, V376.1, V377.1, V380.1, V383.1, V388.1, V389.1
GNDPWR: V129.1, V130.1, V131.1, V132.1, V133.1, V134.1, V135.1, V136.1, V137.1, V138.1, V139.1, V140.1, V141.1, V142.1, V143.1, V144.1, V237.1, V238.1, V239.1, V240.1, V241.1, V242.1, V243.1, V244.1, V245.1, V246.1, V247.1, V248.1, V249.1, V250.1, V251.1, V252.1, V253.1, V254.1, V255.1, V256.1, V257.1, V258.1, V259.1, V260.1, V261.1, V262.1, V263.1, V264.1, V265.1, V266.1, V267.1, V268.1, V269.1, V270.1, V271.1, V272.1, V273.1, V274.1, V275.1, V276.1, V277.1, V278.1, V279.1, V280.1, V281.1, V282.1, V283.1, V284.1, V285.1, V286.1, V287.1, V288.1, V289.1, V290.1, V291.1, V292.1, V293.1, V294.1, V295.1, V296.1
GPIO0_11: V70.1, V71.1
GPIO0_12: V93.1, V321.1, V386.1
GPIO0_13: V92.1
GPIO3_5: V112.1, V121.1, V122.1
GPIO3_7: V300.1, V311.1, V313.1
GPIO5_0-EMC_A13: V198.1, V199.1
GPIO5_2: V151.1, V152.1, V312.1, V314.1
I2C0_SCL: V90.1, V363.1
I2C0_SDA: V91.1, V364.1
I2C1_SCL-U3_RXD: V309.1, V315.1
I2C1_SDA-U3_TXD: V310.1, V316.1
I2S0_TX_SCK: V110.1, V111.1
LTC3559_NTC: V306.1
LTC3559_VCC: V203.1, V204.1
LTC3559_~CHRG~: V307.1, V308.1
MMC_CLK: V145.1, V146.1
MMC_VDD: V200.1, V201.1, V202.1
SPIFI_SCK-CGU_OUT1: V318.1, V359.1
SPIFI_SIO2-I2S1_RX_WS: V116.1, V326.1, V327.1
SPIFI_SIO3-I2S1_RX_SDA: V117.1, V118.1
SSP1_MISO: V147.1, V148.1, V379.1
SSP1_MOSI: V149.1, V150.1, V384.1
SSP1_SCK: V319.1, V378.1, V382.1
SSP1_SSEL: V320.1, V381.1, V385.1
TDO: V303.1
TMS: V304.1
TX0: V196.1
TX1: V197.1
U2_RXD-GPIO0_3: V94.1, V323.1, V387.1
U2_TXD-GPIO0_2: V322.1
USB0_DM: V329.1, V331.1
USB0_DP: V328.1, V330.1
USB0_ID: V324.1, V325.1
VBUS: V59.1, V60.1, V61.1, V305.1
VDD3V3: V205.1, V222.1, V223.1, V224.1, V225.1, V226.1, V227.1, V228.1, V229.1, V230.1, V232.1, V233.1, V234.1, V235.1, V236.1
VDDIO_3V3: V29.1, V30.1, V31.1, V32.1, V33.1, V34.1, V35.1, V36.1, V37.1, V38.1, V206.1, V207.1, V208.1, V209.1, V210.1, V211.1, V212.1, V214.1, V215.1, V216.1, V217.1, V218.1, V219.1, V220.1, V221.1
nRESET: V188.1
nTRST: V302.1
~EMC_CS0~: V85.1, V105.1, V114.1
~EMC_OE~: V86.1, V107.1
~EMC_WE~-MMC_CMD: V82.1, V83.1, V98.1, V297.1
~RESET~: V186.1, V187.1, V189.1
