prabhakar06447/micropendousx/MicropendousX/Hardware/MicropendousX-LPC185x/MicropendousX-LPC185x-Audio_Analog.sch

## KiCad design MicropendousX/Hardware/MicropendousX-LPC185x/MicropendousX-LPC185x-Audio_Analog.sch (2011-08-15)

Schematic: MicropendousX-LPC185x-Audio_Analog.sch

Parts:
C103, C104, C105, C106: 1u0
IC1: LPC185X
P1: ADCTRIG1
P2: ADC
R56, R57: 2k2
TP5: GP_CLKIN
U7: OPENNECT-ANALOG-ADC_3V3-X2
U9: OPENNECT-CONTROLLER-I2S_3V3-PWR_8W

Notes on the sheet:
From USB and GPIO Sheet 6
ADC 0_2 and 1_2 used on LCD Sheet 4 for Touchscreen Sensors
