prabhakar06447/micropendousx/MicropendousX/Hardware/MicropendousX-LPC185x/MicropendousX-LPC185x-EMI.sch

## KiCad design MicropendousX/Hardware/MicropendousX-LPC185x/MicropendousX-LPC185x-EMI.sch (2011-08-15)

Schematic: MicropendousX-LPC185x-EMI.sch

Parts:
C6: 4u7
C7, C56, C57, C58: 1u0
C8, C10: 0u1
IC1: LPC185X
IC2: CY7C1021DV331-10ZSXI
R54, R55: 2k2
U3: Opennect-Controller-SingleEnded_3V3-x8_8W

Notes on the sheet:
From USB and GPIO Sheet 6
Notes: - when using the EMC block of the LPC18xx the core clock must be set max 120MHz for compatibility (Errata 20110701 EMC.1)
