prabhakar06447/micropendousx/MicropendousX/Hardware/MicropendousX-LPC185x/MicropendousX-LPC185x-Ethernet.sch

## KiCad design MicropendousX/Hardware/MicropendousX-LPC185x/MicropendousX-LPC185x-Ethernet.sch (2011-08-15)

Schematic: MicropendousX-LPC185x-Ethernet.sch

Parts:
C41, C59: 12pF
C60, C67, C68, C69, C70, C95: 0u1
C61: 4u7
C62, C63: 1u0
C65, C66: u01
C121, C122: 10p
IC1: LPC185X
IC5: LAN8720
J1: SI-52003-F
L1: FB
R6, R7, R29: 10k
R8, R9, R26, R27: 49.9
R28: 12k1
R31, R32: 750
X3: 25MHz

Notes on the sheet:
GNDs are joined in USB and GPIO Sheet 6
Decoupling Capacitors
From USB and GPIO Sheet 6
REGOFF=0 enables internal 1V8 regulator
nINTSEL=0 selects REF_CLK Out Mode so that REFCLKO (Pin14) outputs 50MHz
To PoE Sheet 9
