prabhakar06447/micropendousx/MicropendousX/Hardware/MicropendousX-LPC185x/MicropendousX-LPC185x-LCD.sch

## KiCad design MicropendousX/Hardware/MicropendousX-LPC185x/MicropendousX-LPC185x-LCD.sch (2011-08-15)

Schematic: MicropendousX-LPC185x-LCD.sch

Parts:
C96, C100: 4u7
C97, C98, C101, C102: 0u1
C99: u22
C123, C124: 5pF
D1: PMEG4005EH
IC1: LPC185X
IC6: CAT4237
L2: 33uH
R33: 0
R34: 47k
R35: 15
U5: NHD-TS
U6: NHD-3.5-320240MF-ATXL-T-1

Notes on the sheet:
Use CTOUT_14 for PWM
The CAT4237 is footprint compatible with other boost converters in SOT23-5 and allows a PWM rate of up to 2kHz. Feedback maintains output current at 20mA which automatically keeps the voltage at about 20V with this panel's LEDs. Footprint compatible parts are: LM3410, CAT4139, LX1995, and FAN5331
50V
Molex 512965494
Molex 522070485
Filter capacitors of 5pF allow for faster settling time.
