prabhakar06447/micropendousx/MicropendousX/Hardware/MicropendousX-LPC185x/MicropendousX-LPC185x-PoE.sch

## KiCad design MicropendousX/Hardware/MicropendousX-LPC185x/MicropendousX-LPC185x-PoE.sch (2011-08-15)

Schematic: MicropendousX-LPC185x-PoE.sch

Parts:
C71, C73, C74, C93: 1u
C72: 12u
C75: 1000u
C76: 100u
C77: 470p
C78: 560p
C79: 15n
C80, C81, C82, C83, C84, C85, C86, C87, C89, C90: 1kp
C88, C92, C94: 0u1
C91: u22
D71: 1N4148W
D72: DFLT15A
D73: PDS1040
D78, D79, D80, D81, D82, D83, D84, D85: 4002
IC70: SI3402
IC71: H11L
L71: 10uH
L72, L73, L74, L75: FB
P3: POWER
R72, R78: 10k
R73: 30.9
R74: 25k5
R75: 46k
R76: 12k1
R77: 2k05
R79: 3k01
R80: 10
R81: 4k99
R82: 100
R83: 100k
T72: Wurth 749119933
U74: TLV431
U75: PS2911
V70, V71, V72, V73, V74, V75, V76, V77, V78, V79, V80, V81, V82, V83, V84, V85, V86, V87, V88, V89, V90, V91, V92, V93, V94, V95, V96, V97, V98, V99, V100, V101, V102, V103, V104, V105, V106, V107, V108, V109, V110, V111, V112, V113, V114, V115, V116, V117, V118, V119, V120, V121, V122, V123, V124, V125, V126, V127, V128: VIA

Notes on the sheet:
1500V Isolation Barrier
TODO: Do the WAKEUP pins function as standard interrupts?
12V-15mA
34V-72V
3V3-2A
When Power-Loss (PLOSS) is asserted, the LPC185x will have time to shut down.
C71-C74 must be rated for 100V
Capacitors C80-C87 are for ESD immunity Diodes D78-D95 are for High Power 10W+
300 Ohm
From Ethernet Sheet 6
Notes: - PoE should generate 6V for the System - Component references follow those from si3402iso-evb.pdf Figure 1 wih a +70 offset - R75, R76 were calculated for Vo=6V - use VPOS for top layer plane to reduce EMI - use VNEG for bottom layer plane as heatsink and to reduce EMI
