prabhakar06447/micropendousx/MicropendousX/Hardware/MicropendousX-LPC185x/MicropendousX-LPC185x-Power.sch

## KiCad design MicropendousX/Hardware/MicropendousX-LPC185x/MicropendousX-LPC185x-Power.sch (2011-08-15)

Schematic: MicropendousX-LPC185x-Power.sch

Parts:
B1: Li-Ion
BT2: BATTERY
C12: 1.2pF
C13, C18, C20, C39, C49: 10u
C14, C25, C26, C27, C31, C32, C35, C37, C43, C44, C47, C53, C55, C64, C109, C110, C111, C112, C113, C114: 0u1
C15, C17, C19, C34, C38, C40: 4u7
C16: 68n
C21, C42, C45: 22u
C22: DNI
C23, C24, C29, C30, C33, C36, C52, C54: 33n
C28: 3n3
C50: 2u2
C51: n1
C115: 1u
IC1: LPC185X
IC4: MAX8677
IC10: TPS63000
IC20: NCP1599
L6, L7: 2.2uH
R10: 1k5
R11: 1M8
R12: 200k
R13: 3k
R14, R15, R22: 10k
R16, R17, R18, R19, R20: 560k
R21: 31k3
R23: 3k65
R24, R25: 1
R48: 12k1

Notes on the sheet:
10V+
16V+
3V3 Buck
5V Buck-Boost
Power Source Switch and Li-Ion Charger
R14 should match 25C resistance of Li-Ion battery thermistor
Cff
DCR<100mOhm
TPS63002: R11=0 R12=DNI C12=DNI
Alternates: STBB1, TPS63002
Riset=3k=1A Limit
Rpset=1k5=2A Limit
nCEN connects to GND so charging is always enabled
