prabhakar06447/micropendousx/MicropendousX/Hardware/MicropendousX-LPC185x/MicropendousX-LPC185x-System.sch

## KiCad design MicropendousX/Hardware/MicropendousX-LPC185x/MicropendousX-LPC185x-System.sch (2011-08-15)

Schematic: MicropendousX-LPC185x-System.sch

Parts:
C1, C2, C3, C4: 10pF
C5, C120: u01
C107, C108, C116, C119: 0u1
C117: 470p
C118: 10u
IC1: LPC185X
IC7: 25Q
IC8: FDC6331L
JP6, JP7, JP8, JP9: JUMPER-3
R36, R37, R39, R40, R41, R42, R43, R44, R45, R46, R47, R52: 10k
R38, R50: 100
R51: 200k
R53: DNI
SW1: RESET
SW2: NMI
TP2: DBGEN
TP3: WAKEUP0
TP4: RTC_ALARM
U4: JTAG
U11: MMC
X1: 12MHz
X2: 32.768kHz

Notes on the sheet:
Si3865BDV
HIGH
Taken from 2011-07-13 LPC18x0 Datasheet - Table 5
UART
LOW
P1_2(A7)
P1_1(A6)
P2_8(A8)
P2_7(A9)
Boot Mode
Boot Mode Selection
SOICW
This is equivalent to nSRST
Power-up Reset is not reliable with fast VDD ramps so a Reset delay is required (Errata 20110701 POR.1)
