prabhakar06447/micropendousx/MicropendousX/Hardware/MicropendousX-LPC185x/MicropendousX-LPC185x-USB_GPIO.sch

## KiCad design MicropendousX/Hardware/MicropendousX-LPC185x/MicropendousX-LPC185x-USB_GPIO.sch (2011-08-15)

Schematic: MicropendousX-LPC185x-USB_GPIO.sch

Parts:
C9: 150uF
C11: 10u
C46: u01
C48: 0u1
CR1, CR2, CR3, CR4, CR5: ESD
F1: 750mA
IC1: LPC185X
IC3: AP2151
L8, L9, L11: FBY
L10: FBX
R1, R2, R3, R4: 0
R5: 10k
TP1: CLK1
U1: USB-microAB-RCPT
U2: USB-A

Notes on the sheet:
Used in Audio and Analog Sheet 5
Used in Ethernet Sheet 3
Used in EMC Sheet 2
Notes: - FBX ferrite bead is high DCR 0805 - FBY ferrite beads are high current 0805 - all other FB are 1A 0603, moderate DCR
High DCR
Intel USB Design Guidelines recommend Low ESR (<100mOhm) capacitors of 120uF+ to allow for temperature derating
To Host
To Device
