prabhakar06447/micropendousx/MicropendousX/Firmware/USBtoSerial/USBtoSerial.c

/*
             LUFA Library
     Copyright (C) Dean Camera, 2010.
              
  dean [at] fourwalledcubicle [dot] com
      www.fourwalledcubicle.com
*/

/*
  Copyright 2010  Dean Camera (dean [at] fourwalledcubicle [dot] com)

  Modified for ARM Cortex-M3 by Opendous Inc. 2010-03
  www.MicropendousX.org

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
  The author disclaim all warranties with regard to this
  software, including all implied warranties of merchantability
  and fitness.  In no event shall the author be liable for any
  special, indirect or consequential damages or any damages
  whatsoever resulting from loss of use, data or profits, whether
  in an action of contract, negligence or other tortious action,
  arising out of or in connection with the use or performance of
  this software.
*/

/** \file
 *
 *  Main source file for the USBtoSerial project. This file contains the main tasks of
 *  the demo and is responsible for the initial application hardware configuration.
 */

#include "USBtoSerial.h"

/** Circular buffer to hold data from the host before it is sent to the device via the serial port. */
RingBuff_t USBtoUSART_Buffer;

/** Circular buffer to hold data from the serial port before it is sent to the host. */
RingBuff_t USARTtoUSB_Buffer;

/** LUFA CDC Class driver interface configuration and state information. This structure is
 *  passed to all CDC Class driver functions, so that multiple instances of the same class
 *  within a device can be differentiated from one another.
 */
USB_ClassInfo_CDC_Device_t VirtualSerial_CDC_Interface =
	{
		.Config = 
			{
				.ControlInterfaceNumber         = 0,

				.DataINEndpointNumber           = CDC_TX_EPNUM,
				.DataINEndpointSize             = CDC_TXRX_EPSIZE,
				.DataINEndpointDoubleBank       = false,

				.DataOUTEndpointNumber          = CDC_RX_EPNUM,
				.DataOUTEndpointSize            = CDC_TXRX_EPSIZE,
				.DataOUTEndpointDoubleBank      = false,

				.NotificationEndpointNumber     = CDC_NOTIFICATION_EPNUM,
				.NotificationEndpointSize       = CDC_NOTIFICATION_EPSIZE,
				.NotificationEndpointDoubleBank = false,
			},
	};

/** Main program entry point. This routine contains the overall program flow, including initial
 *  setup of all components and the main program loop.
 */
int main(void)
{
	SetupHardware();
	
	Buffer_Initialize(&USBtoUSART_Buffer);
	Buffer_Initialize(&USARTtoUSB_Buffer);

	LEDs_SetAllLEDs(LEDMASK_USB_NOTREADY);

	for (;;)
	{
		/* Read bytes from the USB OUT endpoint into the USART transmit buffer */
		for (uint8_t DataBytesRem = CDC_Device_BytesReceived(&VirtualSerial_CDC_Interface); DataBytesRem != 0; DataBytesRem--)
		{
			if (!(BUFF_STATICSIZE - USBtoUSART_Buffer.Elements))
			  break;

			Buffer_StoreElement(&USBtoUSART_Buffer, CDC_Device_ReceiveByte(&VirtualSerial_CDC_Interface));
		}

		/* Read bytes from the USART receive buffer into the USB IN endpoint */
		if (USARTtoUSB_Buffer.Elements)
		  CDC_Device_SendByte(&VirtualSerial_CDC_Interface, Buffer_GetElement(&USARTtoUSB_Buffer));

		CDC_Device_USBTask(&VirtualSerial_CDC_Interface);
		USB_USBTask();

		while (USBtoUSART_Buffer.Elements) {
			Buffer_StoreElement(&USARTtoUSB_Buffer, Buffer_GetElement(&USBtoUSART_Buffer));
		}
	}
}

/** Configures the board hardware and chip peripherals for the demo's functionality. */
void SetupHardware(void)
{
	prvSetupHardware();

	/* Hardware Initialization */
	LEDs_Init();
	USB_Init();
}

/** Event handler for the library USB Connection event. */
void EVENT_USB_Device_Connect(void)
{
	LEDs_SetAllLEDs(LEDMASK_USB_ENUMERATING);
}

/** Event handler for the library USB Disconnection event. */
void EVENT_USB_Device_Disconnect(void)
{
	LEDs_SetAllLEDs(LEDMASK_USB_NOTREADY);
}

/** Event handler for the library USB Configuration Changed event. */
void EVENT_USB_Device_ConfigurationChanged(void)
{
	LEDs_SetAllLEDs(LEDMASK_USB_READY);

	if (!(CDC_Device_ConfigureEndpoints(&VirtualSerial_CDC_Interface)))
		LEDs_SetAllLEDs(LEDMASK_USB_ERROR);
}

/** Event handler for the library USB Unhandled Control Request event. */
void EVENT_USB_Device_UnhandledControlRequest(void)
{
	CDC_Device_ProcessControlRequest(&VirtualSerial_CDC_Interface);
}


/** Event handler for the CDC Class driver Line Encoding Changed event.
 *
 *  \param[in] CDCInterfaceInfo  Pointer to the CDC class interface configuration structure being referenced
 */
void EVENT_CDC_Device_LineEncodingChanged(USB_ClassInfo_CDC_Device_t* const CDCInterfaceInfo)
{
	// TODO - replace
}
