prabhakar06447/micropendousx/(commit log)

2010-02-04 Added initial revision of hardware and firmware.
    [MicropendousX-1343.brd, MicropendousX-1343.sch, MicropendousX-1758.brd, MicropendousX-1758.sch]
2010-02-04 Added a couple JTAG adapter pictures.
2010-02-05 Added PDF version of MicropendousX-LPC1758 Schematic and complete BillOfMaterials
2010-02-05 Added PDF version of MicropendousX-LPC1343 Schematic and complete BillOfMaterials
2010-02-05 Added MicropendousX-1758-Assembly.jpg
2010-02-08 Minor update.
    [MicropendousX-1758.brd, MicropendousX-1758.sch]
2010-02-24 Updated MicropendousX-1343 hardware design
    [MicropendousX-1343.brd, MicropendousX-1343.sch]
2010-02-25 Added partial Micropendous-1769 DIP development board design.
    [MicropendousX-1769.brd, MicropendousX-1769.sch]
2010-03-02 Updated MicropendousX-1343 and KiCAD Schematic Symbol Library
    [MicropendousX-1343.brd, MicropendousX-1343.sch]
2010-04-01 Begun porting LUFA 100219 to ARM. LUFA USBtoSerial compiles.
2010-04-05 Minor fixes to CMSIS. Blinky demo now uses CMSIS-only and no custom files.
    [Blinky.c]
2010-06-05 Updated makefiles thanks to notes from Casainho.
    [MicropendousX-1769.brd, MicropendousX-1769.sch]
2010-06-07 Updated pictures of the MicropendousX-1343 for the latest PCB revision.
2010-10-12 Updated hardware designs. Added Blinky demos with and without assembly.
    [MicropendousX-1343.brd, MicropendousX-1343.sch, MicropendousX-1769.brd, MicropendousX-1769.sch, MicropendousX-176x.brd, MicropendousX-176x.sch]
2010-10-12 Bill Of Materials was accidentally removed from 176x hardware design.
2010-10-13 Updated LPC176x hardware design with top layer silkcreen pin names and minor fixes for copper layers.
    [MicropendousX-176x.brd, MicropendousX-176x.sch]
2010-10-13 Updated MicropendousX-1343 to a better stocked microSD connector (Amphenol 101-00303).
    [MicropendousX-1343.brd, MicropendousX-1343.sch]
2010-10-13 Updated MicropendousX-176x to a better stocked microSD connector (Amphenol 101-00303).
    [MicropendousX-176x.brd, MicropendousX-176x.sch]
2010-10-13 Updated MicropendousX-176x Bill Of Materials.
2010-10-13 Updated MicropendousX-1343 Bill Of Materials.
2010-10-13 Updated MicropendousX-1343 assembly instructions.
2011-03-14 Added missing parts to LPC1343 Bill of Materials.
2011-05-04 Minor update to correct LPC1343 Bill of Materials
2011-08-15 Added unfinished LPC185x-based design.
    [MicropendousX-LPC185x-Audio_Analog.sch, MicropendousX-LPC185x-EMI.sch, MicropendousX-LPC185x-Ethernet.sch, MicropendousX-LPC185x-LCD.sch, MicropendousX-LPC185x-PoE.sch, MicropendousX-LPC185x-Power.sch, MicropendousX-LPC185x-System.sch, MicropendousX-LPC185x-USB_GPIO.sch]
2011-08-16 Added unfinished LPC183x-based design.
    [MicropendousX-LPC183x-Audio_Analog.sch, MicropendousX-LPC183x-EMI.sch, MicropendousX-LPC183x-Ethernet.sch, MicropendousX-LPC183x-LCD.sch, MicropendousX-LPC183x-Power.sch, MicropendousX-LPC183x-System.sch, MicropendousX-LPC183x-USB.sch, MicropendousX-LPC183x-Vias.sch]
2011-08-21 Update unfinished LPC183x-based design.
    [MicropendousX-LPC183x-Audio_Analog.sch, MicropendousX-LPC183x-EMI.sch, MicropendousX-LPC183x-GPS.sch, MicropendousX-LPC183x-LCD.sch, MicropendousX-LPC183x-Power.sch, MicropendousX-LPC183x-System.sch, MicropendousX-LPC183x-USB.sch, MicropendousX-LPC183x-Vias.sch]
2011-09-26 Updated LPC183x Hardware Design
    [MicropendousX-LPC183x-Audio_Analog.sch, MicropendousX-LPC183x-EMI.sch, MicropendousX-LPC183x-Ethernet.sch, MicropendousX-LPC183x-Opennect_Connector.sch, MicropendousX-LPC183x-PoE.sch, MicropendousX-LPC183x-Power.sch, MicropendousX-LPC183x-System.sch, MicropendousX-LPC183x-USB.sch]
2011-09-26 Updated LPC183x Hardware Design to Rev.2011-09-26 which will be sent out for fabrication.
    [MicropendousX-LPC183x-EMI.sch, MicropendousX-LPC183x-Opennect_Connector.sch, MicropendousX-LPC183x-Power.sch, MicropendousX-LPC183x-System.sch, MicropendousX-LPC183x-USB.sch, MicropendousX-LPC183x-Vias.sch, MicropendousX-LPC183x.brd, MicropendousX-LPC183x.sch]
2011-10-28 Added Bill of Materials and Schematics in Postscript format for the MicropendousX-LPC183x project.
2011-11-03 Updated MicropendousX-LPC183x portable design with minor post-prototyping corrections.
    [MicropendousX-LPC183x-EMI.sch, MicropendousX-LPC183x-Opennect_Connector.sch, MicropendousX-LPC183x-Power.sch, MicropendousX-LPC183x-System.sch, MicropendousX-LPC183x-USB.sch, MicropendousX-LPC183x-Vias.sch, MicropendousX-LPC183x.brd, MicropendousX-LPC183x.sch]
2011-11-03 Added picture of MicropendousX-LPC183x prototype.
2011-11-03 Added another picture of MicropendousX-LPC183x prototype.
2011-11-03 Updated MicropendousX-LPC183x Bill of Materials.
2011-11-04 Minor updates to MicropendousX-LPC183x Inner2 (power) and silkscreen layers.
    [MicropendousX-LPC183x-EMI.sch, MicropendousX-LPC183x.brd]
2012-06-01 Added schematic for MicropendousX-GPS Sensor Module.
    [MicropendousX-LPC182x-GPS-EMI.sch, MicropendousX-LPC182x-GPS-LCD.sch, MicropendousX-LPC182x-GPS-Position_Sensors.sch, MicropendousX-LPC182x-GPS-Power.sch, MicropendousX-LPC182x-GPS-RF.sch, MicropendousX-LPC182x-GPS-System.sch, MicropendousX-LPC182x-GPS-USB.sch, MicropendousX-LPC182x-GPS-Vias.sch]
2012-06-09 Updated MicropendousX-LPC182x-GPS design. PCB routing almost complete.
    [MicropendousX-LPC182x-GPS-EMI.sch, MicropendousX-LPC182x-GPS-Expansion.sch, MicropendousX-LPC182x-GPS-LCD.sch, MicropendousX-LPC182x-GPS-Position_Sensors.sch, MicropendousX-LPC182x-GPS-Power.sch, MicropendousX-LPC182x-GPS-RF.sch, MicropendousX-LPC182x-GPS-System.sch, MicropendousX-LPC182x-GPS-USB.sch]
2012-06-27 Updated MicropendousX-LPC182x-GPS design. PCB routing is complete.
    [MicropendousX-LPC182x-GPS-EMI.sch, MicropendousX-LPC182x-GPS-Expansion.sch, MicropendousX-LPC182x-GPS-LCD.sch, MicropendousX-LPC182x-GPS-Position_Sensors.sch, MicropendousX-LPC182x-GPS-Power.sch, MicropendousX-LPC182x-GPS-RF.sch, MicropendousX-LPC182x-GPS-System.sch, MicropendousX-LPC182x-GPS-USB.sch]
2012-07-02 Added Gerbers for MicropendousX-LPC182x-GPS design.
2012-07-02 Added complete MicropendousX-LPC182x Module design.
    [MicropendousX-LPC182x-Expansion.sch, MicropendousX-LPC182x-Power.sch, MicropendousX-LPC182x-System.sch, MicropendousX-LPC182x-USB.sch, MicropendousX-LPC182x-Vias.sch, MicropendousX-LPC182x.brd, MicropendousX-LPC182x.sch]
