prabhakar06447/micropendousx/(notices)

Notices in the files:
MicropendousX/Firmware/LPC17xx/FreeRTOS_USBSerial_Ethernet_LPC17x8/webserver/emac.c:
FreeRTOS is free software; you can redistribute it and/or modify it under
the terms of the GNU General Public License (version 2) as published by the
Free Software Foundation AND MODIFIED BY the FreeRTOS exception.
NOTE*** The exception to the GPL is included to allow you to distribute
MicropendousX/Hardware/MicropendousX-GPS/MicropendousX-LPC182x-GPS-Expansion.sch:
http://creativecommons.org/licenses/by/3.0
Copyright Under the Creative Commons Attribution License
